thebenedict/tinkerbadge-hardware/docs/design/history/2026-11-10-before-optical-reposition/review/rear-with-battery.png

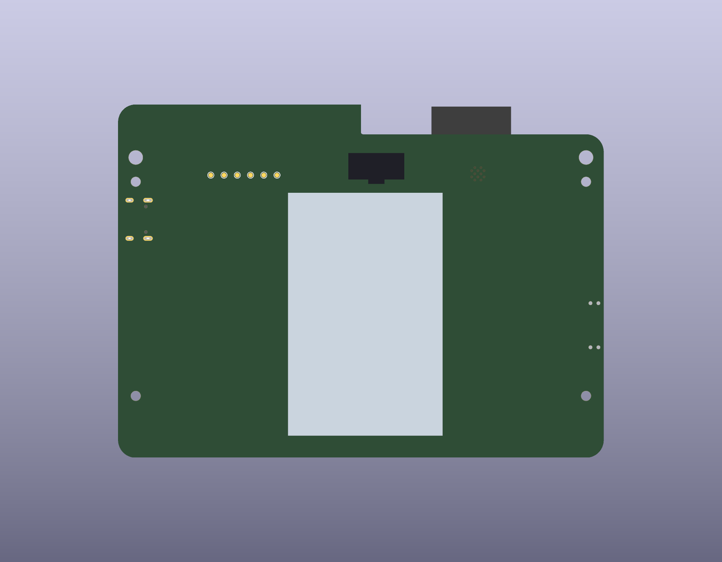
docs/design/history/2026-11-10-before-optical-reposition/review/rear-with-battery.png
