thebenedict/tinkerbadge-hardware/docs/design/history/2026-11-10-before-optical-reposition/README.md

# Before optical relocation

Complete native project/source-library/model checkpoint before the requested IR and ambient-light relocation. Board SHA256 08b5de1ac1b194544ebf15598fd0b40e66a4e0c05123c6da75603a769d91554e. This 110 × 80 mm placement is historical and unrouted. Review outputs and the source placement plan are preserved.
