thebenedict/tinkerbadge-hardware/docs/design/display_pinout.md

# Display project pinout

Generated by `tools/write_display_pinout.py` from [display_contract.json](display_contract.json). Manufacturer facts remain in docs/components. J301 rows are panel flex positions; the FH34SRJ footprint numbers its pads in the same panel order.

| Ref | Physical pin | Function | Project net | Treatment |
|---|---|---|---|---|
| J301 | 1 | NC | — | no_connect |
| J301 | 2 | GDR | EPD_GDR | connected |
| J301 | 3 | RESE | EPD_RESE | connected |
| J301 | 4 | NC | — | no_connect |
| J301 | 5 | VSH2 | EPD_VSH2 | connected |
| J301 | 6 | TSCL | — | no_connect |
| J301 | 7 | TSDA | — | no_connect |
| J301 | 8 | BS1 | GND | connected |
| J301 | 9 | BUSY | EPD_BUSY | connected |
| J301 | 10 | RES# | EPD_RST_N | connected |
| J301 | 11 | D/C# | EPD_DC | connected |
| J301 | 12 | CS# | EPD_CS_N | connected |
| J301 | 13 | SCL | EPD_SCK | connected |
| J301 | 14 | SDA | EPD_MOSI | connected |
| J301 | 15 | VDDIO | +3V3_EPD | connected |
| J301 | 16 | VCI | +3V3_EPD | connected |
| J301 | 17 | VSS | GND | connected |
| J301 | 18 | VDD | EPD_VDD_1V8 | connected |
| J301 | 19 | VPP | EPD_VPP | connected |
| J301 | 20 | VSH1 | EPD_VSH1 | connected |
| J301 | 21 | VGH | EPD_VGH | connected |
| J301 | 22 | VSL | EPD_VSL | connected |
| J301 | 23 | VGL | EPD_VGL | connected |
| J301 | 24 | VCOM | EPD_VCOM | connected |
| Q301 | 1 | G | EPD_GDR | connected |
| Q301 | 2 | S | EPD_RESE | connected |
| Q301 | 3 | D | EPD_SW | connected |
| D301 | 1 | K | GND | connected |
| D301 | 2 | A | EPD_PUMP | connected |
| D302 | 1 | K | EPD_PUMP | connected |
| D302 | 2 | A | EPD_VGL | connected |
| D303 | 1 | K | EPD_VGH | connected |
| D303 | 2 | A | EPD_SW | connected |
| L301 | 1 | 1 | +3V3_EPD | connected |
| L301 | 2 | 2 | EPD_SW | connected |
| R301 | 1 | 1 | EPD_RESE | connected |
| R301 | 2 | 2 | GND | connected |
| R302 | 1 | 1 | EPD_GDR | connected |
| R302 | 2 | 2 | GND | connected |
| C301 | 1 | 1 | +3V3_EPD | connected |
| C301 | 2 | 2 | GND | connected |
| C302 | 1 | 1 | EPD_SW | connected |
| C302 | 2 | 2 | EPD_PUMP | connected |
| C303 | 1 | 1 | +3V3_EPD | connected |
| C303 | 2 | 2 | GND | connected |
| C304 | 1 | 1 | EPD_VDD_1V8 | connected |
| C304 | 2 | 2 | GND | connected |
| C305 | 1 | 1 | EPD_VPP | connected |
| C305 | 2 | 2 | GND | connected |
| C306 | 1 | 1 | EPD_VSH1 | connected |
| C306 | 2 | 2 | GND | connected |
| C307 | 1 | 1 | EPD_VGH | connected |
| C307 | 2 | 2 | GND | connected |
| C308 | 1 | 1 | EPD_VSL | connected |
| C308 | 2 | 2 | GND | connected |
| C309 | 1 | 1 | EPD_VGL | connected |
| C309 | 2 | 2 | GND | connected |
| C310 | 1 | 1 | EPD_VCOM | connected |
| C310 | 2 | 2 | GND | connected |
| C311 | 1 | 1 | EPD_VSH2 | connected |
| C311 | 2 | 2 | GND | connected |
| R308 | 1 | 1 | EPD_BUSY | connected |
| R308 | 2 | 2 | GND | connected |
| TP301 | 1 | pad | +3V3_EPD | connected |
