thebenedict/tinkerbadge-hardware/docs/design/power_capture_review.md

# Independent power capture review

9 November 2026. **PASS: native single nominal 3.3 V prototype capture.** This replaces the historical 3.95 V / LDO capture review, which remains preserved under `history/power_3v95_before_single_3v3`.

A new netlist was independently exported from the actual `power.kicad_sch` through Konnect. It matches the reviewed contract: **60 components, 195 physical endpoints, 14 intentional NCs, zero issues**. The exact non-power-symbol component set also matches, so removed U106, C110 and C111 have not survived outside the contract. No old VLED_3V9 net remains. Four independent native validators report zero floating wires, unconnected pins, shorted nets and orphan items.

Separately compared all 60 Contract fields, all 60 blank footprint fields, 12 exact MPNs and their visible values, 45 support Specifications and visible values, plus J104's DNP property. All agree. Blank footprints are deliberate release gates, not accepted physical mappings. J104's DNP is carried by its explicit value/property; the native DNP attribute remains unavailable in the current tool and the BOM process must honor this flag.

Inspected the final full-page image. The shared-rail group is readable, the 56.0 kΩ divider is shown, both 22 µF output capacitors remain, and the removed LDO group and old headline are absent. Rail labels terminate on clear branch stubs. The charging-disabled and first-prototype LED-exception notes remain prominent. No new ambiguity or visible correction was found.

Current native SHA-256: `377d3afaa8323e6f61d6cef0f8e670254b959091fdc766e32c5c063dad6d121f`.
Final reviewed PNG SHA-256: `5bca714550c126438e0f0ab12fda2b1071d87f0450cd5ac655035bd5c81601b2`.
Independent export SHA-256: `e516bbae113c89aea26574083f35281a8f212997e392044e743a3b23d77adbda`.

This acceptance is for a development schematic, not guaranteed LED operation or manufacturing release. Full-root ERC, physical component/footprint qualification, the unselected pack/connector and shared-rail bench tests remain separate. R120 continues to disable charging. Full results, source contract hash and field-level evidence are in `power_capture_review.json`.
