thebenedict/tinkerbadge-hardware/docs/design/property_checker_review.md

# Independent property-checker review

9 November 2026. **PASS for its stated explicit-property scope.** Independently ran seven fixture tests: five negative cases, one baseline and one unit-equivalence case. All pass, with fixture hashes checked. Current power export also passes.

Declared MPN, support value/rating, displayed voltage rating, explicit library/footprint and DNP comparisons are consistent with the current contracts. The checker is separate from endpoint checking and does not claim physical footprint or electrical-performance acceptance.

Scope limits: Contract trace fields, power Specification metadata and visible IC values are not automatically compared unless represented by the implemented contract fields. Unspecified footprints are reported rather than approved. I separately audited all of these for the current power capture. Nominal values are compared as scaled numbers without dimensions, allowing display-style values such as 100n; this is not a unit-validity proof.

Future fail-closed improvements: reject duplicate component/property records instead of dictionary overwrite, report missing values cleanly, and add negative DNP/library tests. These are not observed defects in the current KiCad exports. No native correction is required. File hashes and exact observations are in `property_checker_review.json`.
