thebenedict/tinkerbadge-hardware/docs/design/history/2026-11-10-before-lower-ir/spec.md

# AI Tinkerers Badge Project Specification

Version 0.6 · 9 November 2026 · Working draft for humans and implementation agents

## Purpose and scope

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

## Current schematic snapshot

The KiCad development schematic now implements the reviewed [project pinouts](pinouts.md). [Schematic implementation](design/implementation_status.md) records the current electrical choices and supersedes conflicting candidate details below, including the two-wire battery interface, initially unpopulated thermistor and hardware-disabled charging. Prototype and physical acceptance gates remain open.

### Approved first-prototype LED supply

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

## Experience and operation

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

## Events and interactions

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

### Arrival: email link, scan, and badge assignment

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

### Further journeys to define

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

## Hardware blocks

### Display and processor

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

### V1 sensors and peripherals

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

- **Two physical buttons are required.** Use at least one existing button for wake from storage deep sleep; its GPIO and circuit must support the selected sleep mode. Placement, labels, other short/long-press behavior, and functions remain TBD. Candidate uses include display navigation and explicit contact exchange; retain independent hardware recovery access.
- **Ambient light sensor:** Include a low-power digital sensor, preferably on I2C, to adapt LED brightness to the room. Allow manual brightness override. Position its optical opening away from the badge's own LEDs and test with the final enclosure and diffuser.
- **Accelerometer and orientation:** Include a low-power three-axis accelerometer with motion/wake interrupt support for tilt, shake, and badge-bump experiments. Gravity provides tilt when the badge is relatively still; an accelerometer alone does not provide compass heading or reliable orientation during arbitrary movement. Prefer this simpler baseline. A six-axis accelerometer/gyroscope is an option if prototypes need richer gestures or smoother motion tracking; it still does not provide drift-free absolute heading.
- **Infrared, proposed transmit and receive:** Recommend both an IR LED with a suitable current driver and a carrier-demodulating IR receiver, rather than transmit-only hardware. This allows directional badge-to-badge messages and facing-cue experiments. Start by evaluating a common 38 kHz carrier and a short, collision-aware packet protocol. A demodulating remote-control receiver is not a general raw IR sensor: validate its burst timing and filtering against the selected protocol. Check sunlight and lighting interference, viewing angle, range, multiple badges, and transmitter peak current. IR sensing is not proof of a conversation. Final inclusion and optical placement remain a v1 decision.
- **MCU-programmable NFC tag:** Include a dynamic NFC tag with an MCU interface, preferably I2C, and a tuned antenna. Firmware should be able to update an NDEF record, such as a profile or contact-exchange URL, so a compatible phone can tap the badge. Select field-detect/interrupt capability if useful for wake or UI feedback, and test the target phones and enclosure. Passive RF operation can allow reading the last stored record without badge power, subject to the selected part. Default to a public or limited-purpose link, with controlled write access; do not expose private attendee data or credentials in the tag. A tap does not itself authorize contact sharing.
- **NFC reader, optional pending use case:** A dynamic tag does not make the badge a reader. Two passive tags cannot initiate an exchange with one another. If badges must read external tags or initiate badge-to-badge NFC, add a reader/controller capable of generating the RF field, and validate the reader/tag modes and arbitration. This adds cost, power, antenna/layout work, and firmware. Recommendation: use the dynamic tag for v1 phone taps and defer an onboard reader unless one of those use cases is essential; BLE with button confirmation or IR can support badge-to-badge experiments. The proposed ESP32-S3 needs external NFC hardware for either approach.
- **BLE and Wi-Fi:** Retain the processor's radios for discovery/proximity experiments, provisioning, updates, and event connectivity. Evaluate scanning, advertising, power, and coexistence under event conditions. BLE signal strength is only an approximate proximity cue.
- **Display and lighting:** Retain the e-paper display, top role bar, and independently controlled affinity indicators described below. Budget LED drivers/channels, dimming, and power explicitly; the exact indicator count remains open.
- **Battery and power sensing:** Retain battery-voltage monitoring, charger status, separate USB and dock presence sensing, low-battery behavior, and battery-temperature protection appropriate to the chosen cell and charger. Prefer an inexpensive voltage/status baseline; a fuel-gauge IC is a suggested upgrade if usable state-of-charge estimates or fleet charging diagnostics justify it. Voltage alone is not an accurate remaining-runtime measurement.

### Supporting interfaces and optional additions

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

Other suggestions, not additional v1 requirements:

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

### Lights and optics

- **Power status:** Include one separate tiny red/green indicator, owned by the power block and distinct from the role/affinity lights. Prefer 0402 or similar; the currently sourced working candidate is a four-pad 0603 part. See the power-status contract below.
- **Top role bar:** A thin, continuous-looking colored light identifies attendee, organizer, speaker, or another event-defined role. Explore a diffused LED strip/light guide; no specific filament or LED construction is selected.
- **Affinity indicators:** Approximately three to five separately controlled color indicators, likely near the bottom. Five is a prototype suggestion, not a final count. Begin with simple, distinguishable colors rather than combinations or subtle blinking codes.
- **Affinity assignment:** Support attendee-selected interests and optional agent-proposed groups based on voluntarily shared interests. Proposed flow: organizer reviews the event’s categories, attendees confirm or edit their assignments, and the website or display explains the colors. More specific introductions and “can help with / looking for” matching are optional extensions.
- **Appearance:** Soft, modest-brightness glows rather than exposed hotspots. Prototype frosted windows or strips, LED-to-diffuser spacing, and internal light barriers. A single diffuser behind separate openings may simplify construction. Preserve a non-color explanation for accessibility.

## Power and docking

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

Working architecture:

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

### Automatic power behavior

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

### Power-status indicator

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

Reuse battery-voltage sensing and charger status. Measure protected BAT through a calibrated, filtered, safely scaled ADC1 path with verified powered-off isolation, never raw battery directly into a GPIO. Provisional battery-mode thresholds are **below 3.50 V for 10 seconds**, clearing **above 3.65 V for 30 seconds**; validate these with the selected pack and realistic load/temperature, suppress transient flicker, and re-evaluate after external power removal. Invalid readings must not imply a healthy battery. The warning is separate from controlled low-voltage shutdown and the pack's protection cutoff. `CHG` indicates charging, not low battery.

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

## PCB and enclosure

### PCB

**Current placement trial (9 November 2026):** The requested compact candidate is 110 × 80 mm, with front-side SMT, a proposed 4.5 mm raised display, right-edge USB, full-width affinity LEDs, organized circuit groups, an evenly spaced role-LED row on the remaining top edge and a radio-antenna opening extended to the left edge. It is experimental, not RF/manufacturing approved. The glass is closer to the antenna than the recommended surrounding clearance; the NFC coil, flex and exact part heights remain unresolved. The user selected a rear-copper NFC PCB coil with the front and inner layers kept clear; coil geometry and tuning are not yet implemented. IR/ambient optical faces now use the exposed area right of the MCU and below the role row, while low-profile support sits under the raised display. The prior 110 × 100 mm placement is preserved as a fallback. See [current placement review](design/pcb_placement_review.md) and obtain human approval before detailed routing.

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

#### PCB layout and routing guidance

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

**Placement, composition, and routing goals:**

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

**Placement approval and visual feedback loop:**

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

**Useful prior art and its limits** (reviewed 9 November 2026):

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

### Enclosure

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

- Explore two or three shapes around the same functional envelope. A clear front/back with a printed frame, screws/standoffs, and diffuser inserts is a practical candidate. A simple protective front cover is an earlier prototype step; higher-quality printing, machining, or molding may follow.
- Attach the lanyard to the structure or PCB, not assumed holes in the display. Confirm the exact panel’s permitted support and adhesive regions. Compliant support is a candidate, not permission to clamp arbitrary glass edges or compress the panel.
- **CAD working choice:** Parametric build123d; CadQuery is a close alternative, with FreeCAD or Onshape available for visual design/review. Keep fit dimensions separate from styling and use KiCad’s PCB/component STEP assembly as a reference.
- Export STEP for mechanical handoff and 3MF or STL for printed prototypes. Check fits, clearances, wall thickness, fasteners, assembly sequence, and process-specific rules such as draft before calling a design production-ready.

## Firmware, networking, and privacy

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

## Design, publishing, and production pipeline

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

## Next decisions and references

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
