thebenedict/tinkerbadge-hardware/docs/design/history/2026-11-10-before-shared-optics/CHECKPOINT.md

# Before shared passive optical window placement

Complete a7ac lower-IR native project, libraries/models and reviews before the four-part ALS/support revision. Board SHA256 a7ac2778f423c3847b9a3a6200f00446d6a960bbee242b6ef8da7aff5ed24b84. The saved prior-bookkeeping manifest predates a7ac and is retained as history, not as this checkpoint verification. The source board and review files identify the a7ac revision.
