thebenedict/tinkerbadge-hardware/docs/design/history/power_3v95_before_single_3v3/docs/design/power_capture_review.md

# Independent power capture review

Temporary review artifacts below are identified by filename only; these intermediate files are not distributed. Published source outputs and repeatable checks are linked from the [current verification record](../../../../verification.md).

2026-11-09. Reviewer: display/MCU circuit reviewer, independent of power CAD author. **PASS electrical capture for reviewed contract e6117b29…bccb; visual corrections requested before final visual acceptance.** No native CAD edits made by this reviewer.

Freshly exported `power-independent.net` through Konnect and checked it against `power_contract.json`: **63 parts, 206 physical endpoints, 16 intentional NC, no mismatch**. Independently ran all four local validators: **0 floating wires, 0 unconnected pins, 0 named-net shorts and 0 orphans**. Every specified MPN/value matches the export. All power footprint fields are blank, preserving the physical-release gate.

Reviewed the actual `power_final.png` against the original-source decisions in `review_power.md`. Actual endpoint sets preserve USB/dock input and TVS polarity, mux OUT1/8 and charger BAT2/3/OUT10/11 duplicates, all exposed grounds, Q103 source-mode inversion, the fitted R1200-ohm VSYS→CE hard charge-disable, and separate logical two-wire battery/optional thermistor interfaces. The 69k/10k feedback, 0.47uH between L1/L2, both 22uF primary output caps, 3.3V LDO and bypasses match the reviewed 3.95V/3.3V architecture. This is not independent approval of a later rail-architecture change.

ADC capture places C116 upstream of the powered-off-protected TMUX, R13010k after it, and R129100k from BAT_ADC to ground; the reviewed VBAT/3.2 ratio and off-state leakage reasoning therefore apply. U104 has correct ON/CT/QOD assignments and its QOD resistor returns to +3V3_EPD, not ground. All source-sense GPIO outputs use ground-referenced MOSFETs and 3.3V pull-ups. The complete-root display/MCU review separately verifies U104's switched output and EPD_EN integration.

J104's exported value is `NTC (DNP)` with `Populate=DNP` and an explicit charging-stays-disabled Safety field. A native KiCad DNP attribute was not available through the current tool; the source contract, value and custom field retain the intent. Manufacturing/BOM automation must explicitly honor that field before any release. No battery mating polarity or charge enable is authorized by this schematic.

## Requested visual corrections

The electrical content is sound, but the initial final render has avoidable collisions: R120 with the CHARGER_TMR/EN1 text; battery/NTC captions with nearby rail/GND labels; U106 value with +3V3; R121/R124 values across vertical gate wires; and three global rail labels over continuous wires. Specific locations were sent to the author for correction. Await a fresh render before visual signoff. These findings do not alter the electrical contract.

Pinned evidence, actual critical net membership, values and validator results are in `power_capture_review.json`. Complete-root ERC, human visual approval, exact footprints/MPNs/pack polarity, temperature sensing and disabled charging, source/current-mode tests, thermal/peak-load limits, USB compliance and prototype validation remain open release gates. This review neither routes a PCB nor approves manufacturing.

## Corrected historical capture accepted

Inspected the final corrected `power_final_reviewed.png`, including the last U103 reference/value move clear of PRIMARY_L2. All reported visual overlaps are resolved; no new issue observed. Rechecked exported endpoints:63/206/16NC PASS, and fresh local validators again report zero findings. **Independent electrical and visual capture PASS for this 3.95V-plus-LDO snapshot.**

The user has since chosen a single nominal3.3V prototype rail. That upcoming electrical amendment supersedes this architecture and requires a new source/contract review before capture; this historical signoff does not approve it in advance.

Snapshot native SHA-256: `137e7f1daf40aac11d6c4be061468b6c48a9999a3ebdb6682e1a062be78fc4c8`.
Snapshot netlist SHA-256: `f7becfc1633dc1065ae864f44d7bf41c62d5d64395a43ab665b5a6f64cec310b`.
Inspected PNG SHA-256: `7703f9b78a4eafbf3418aee859d446e965a00efd902e23f2b2076d88f7b0f0e0`.
