thebenedict/tinkerbadge-hardware/docs/design/history/2026-11-10-before-shared-optics/review/functional-blocks.png

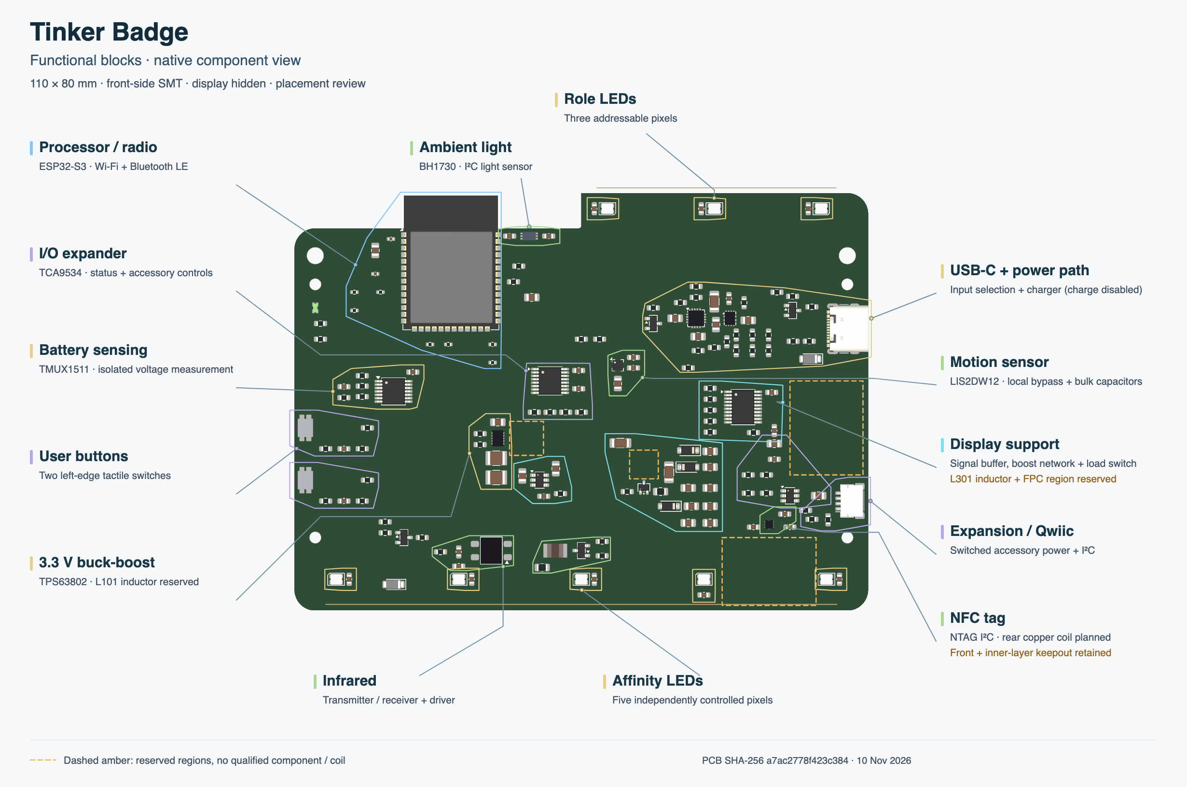
docs/design/history/2026-11-10-before-shared-optics/review/functional-blocks.png
