thebenedict/tinkerbadge-hardware/docs/review/product-review-2026-11-11/pcb-front.png

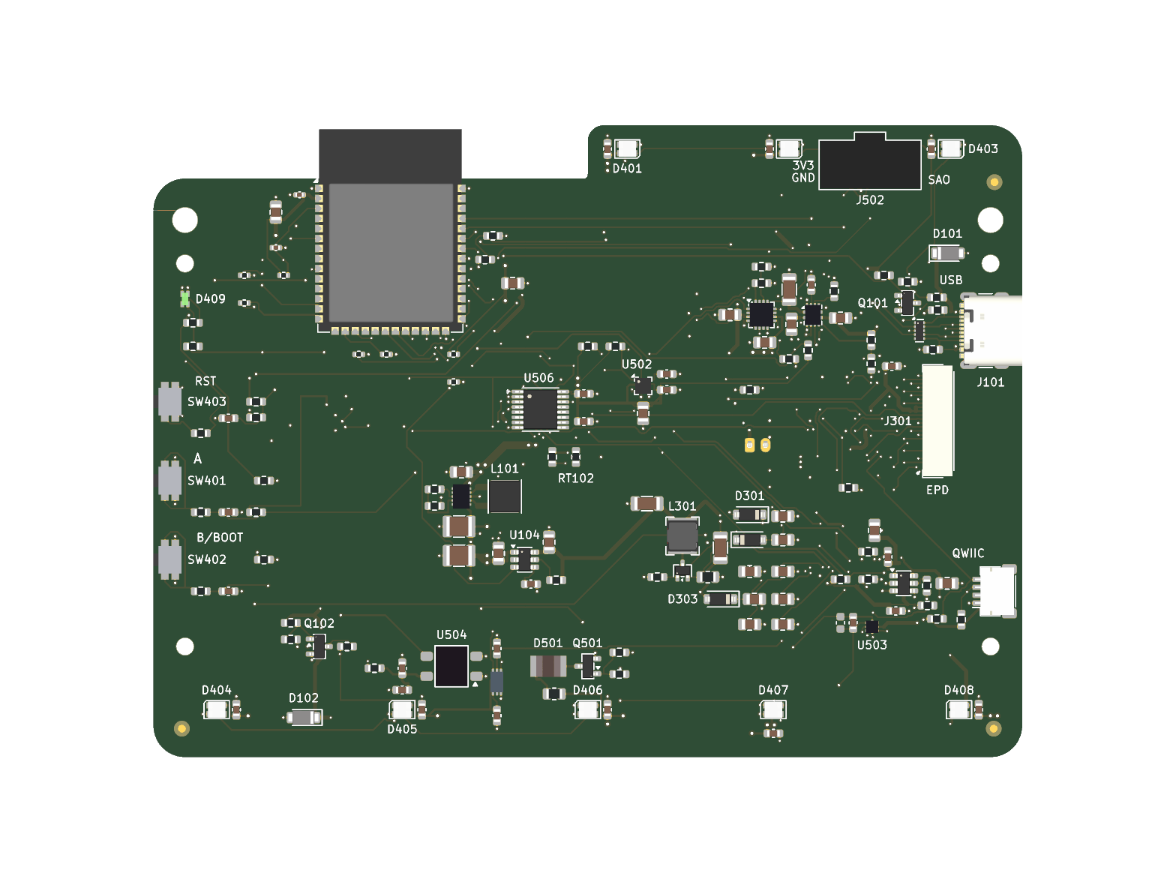
docs/review/product-review-2026-11-11/pcb-front.png
