thebenedict/tinkerbadge-hardware/exports/design-review-2026-11-11/front-3d.png

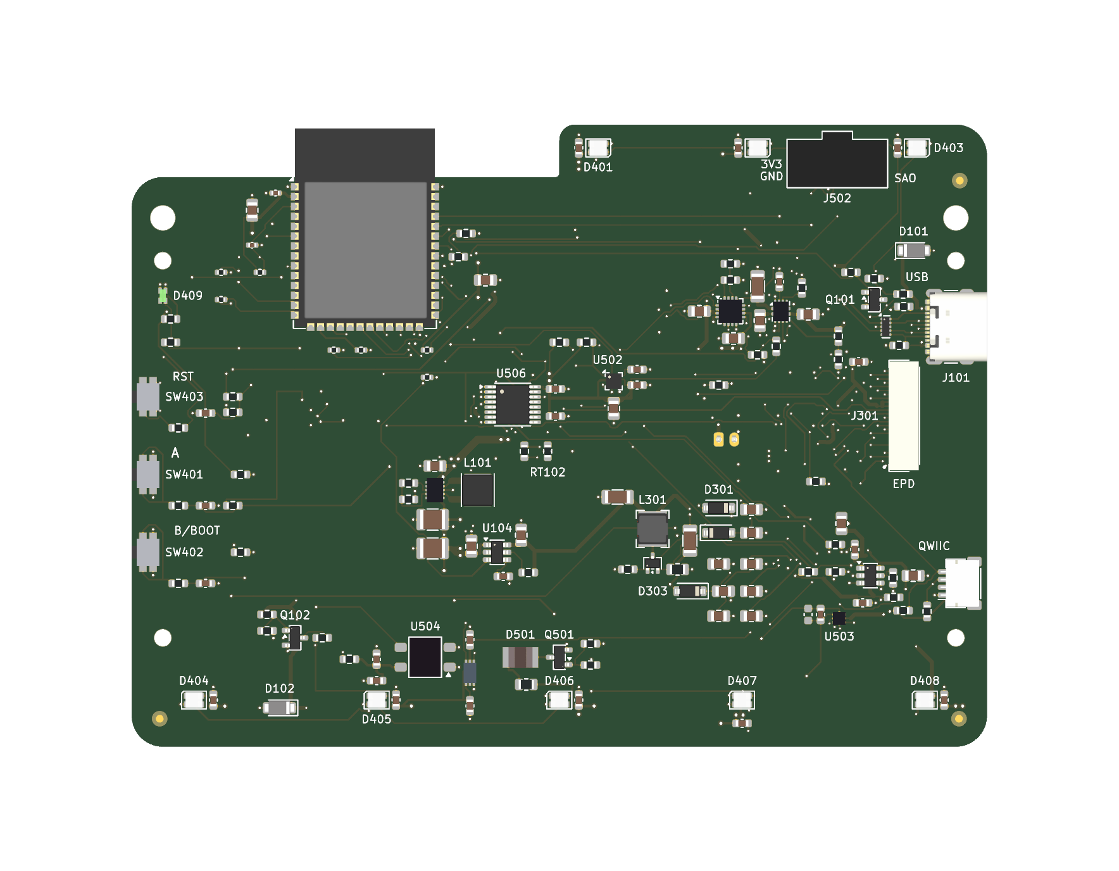
exports/design-review-2026-11-11/front-3d.png
