thebenedict/tinkerbadge-hardware/exports/display.png

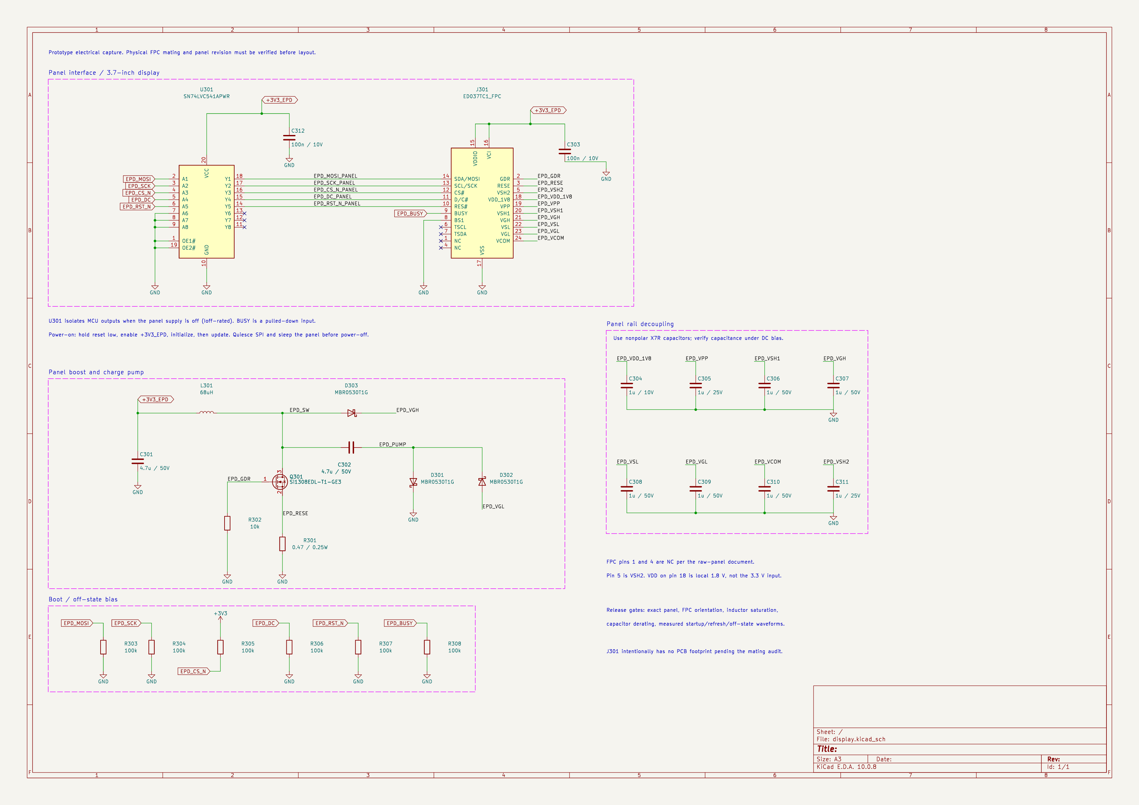
exports/display.png
