thebenedict/tinkerbadge-hardware/exports/lighting.png

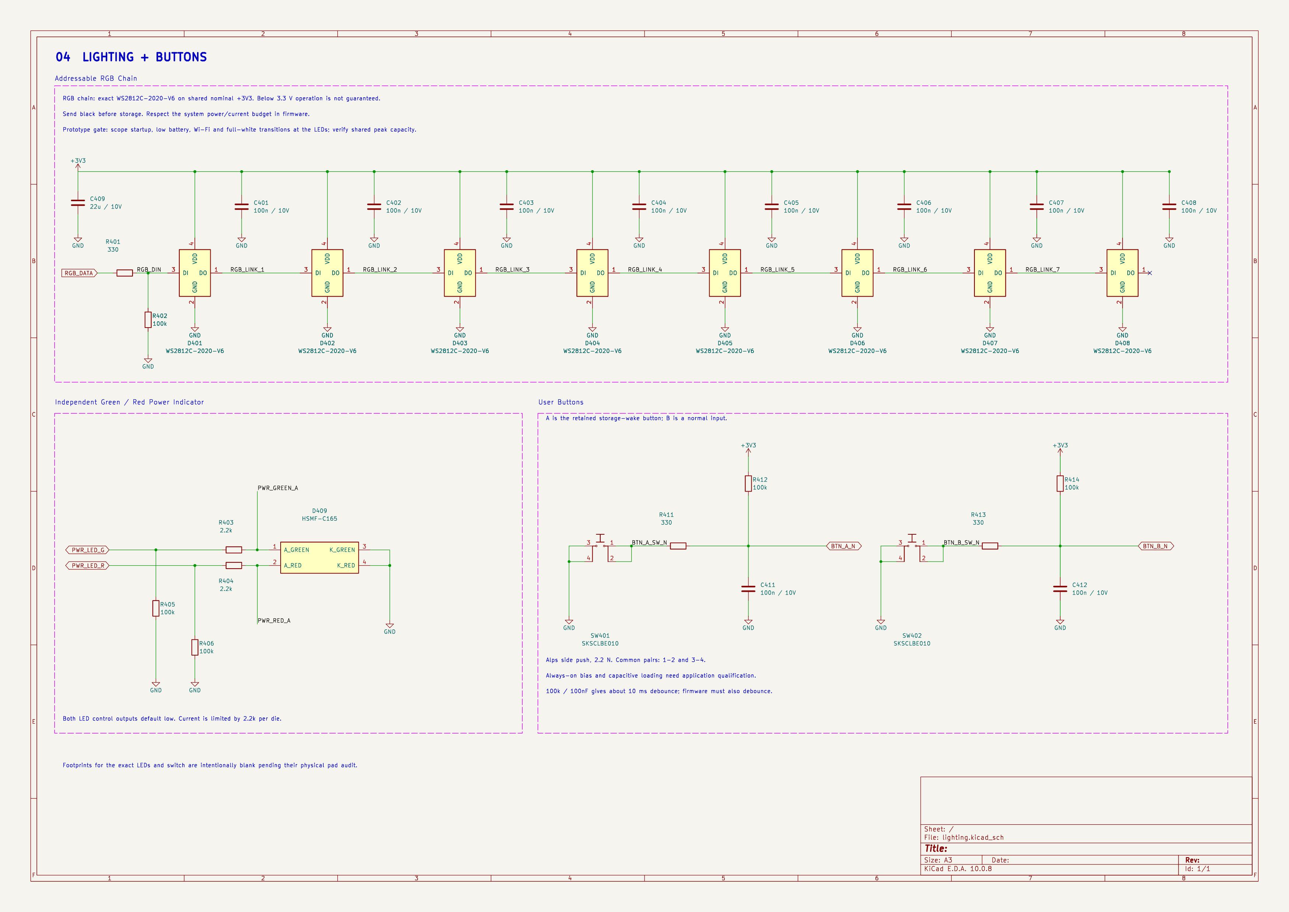
exports/lighting.png
