thebenedict/tinkerbadge-hardware/exports/mcu.png

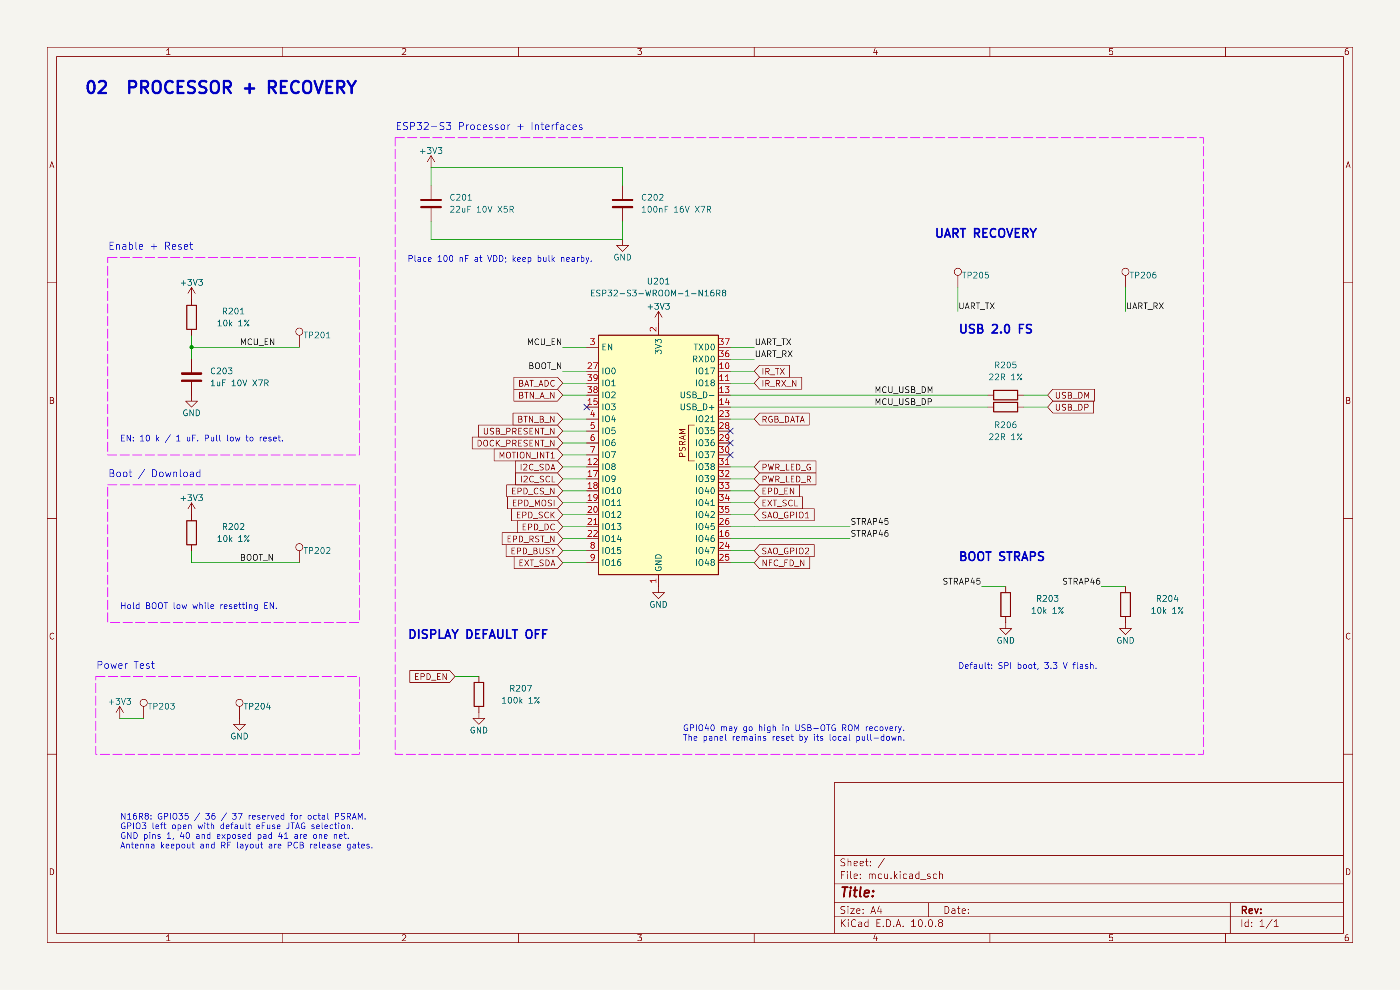
exports/mcu.png
