thebenedict/tinkerbadge-hardware/exports/pcb-review/first-routing/front-with-display.png

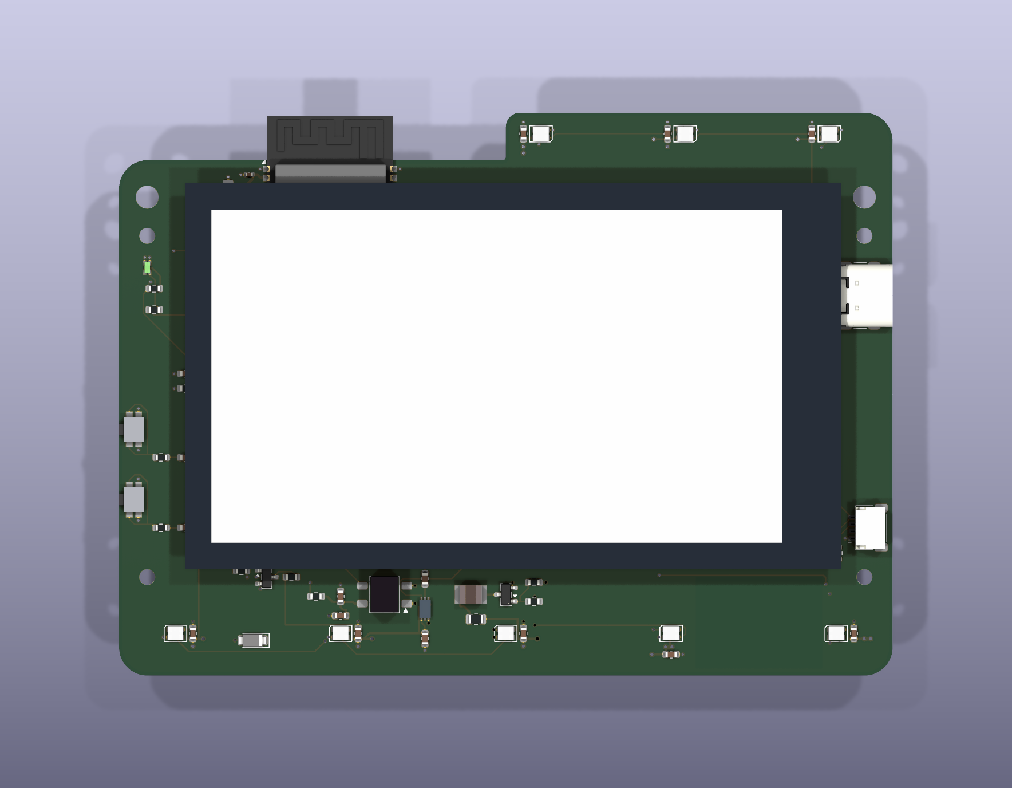
exports/pcb-review/first-routing/front-with-display.png
