thebenedict/tinkerbadge-hardware/exports/pcb-review/first-routing/raised-display-perspective.png

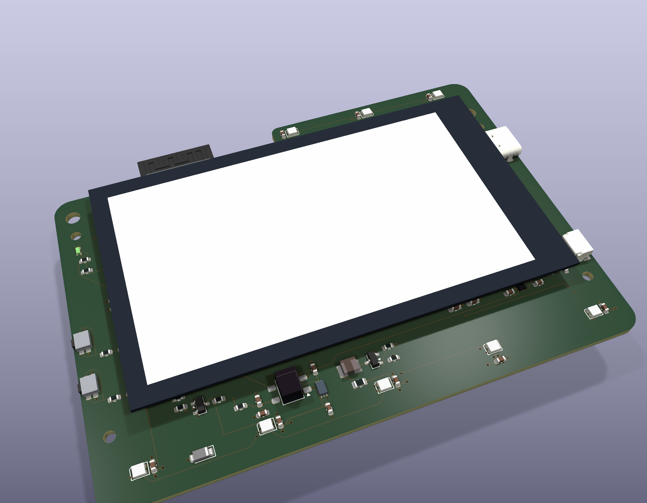
exports/pcb-review/first-routing/raised-display-perspective.png
