thebenedict/tinkerbadge-hardware/exports/pcb-review/first-routing/rear-with-battery.png

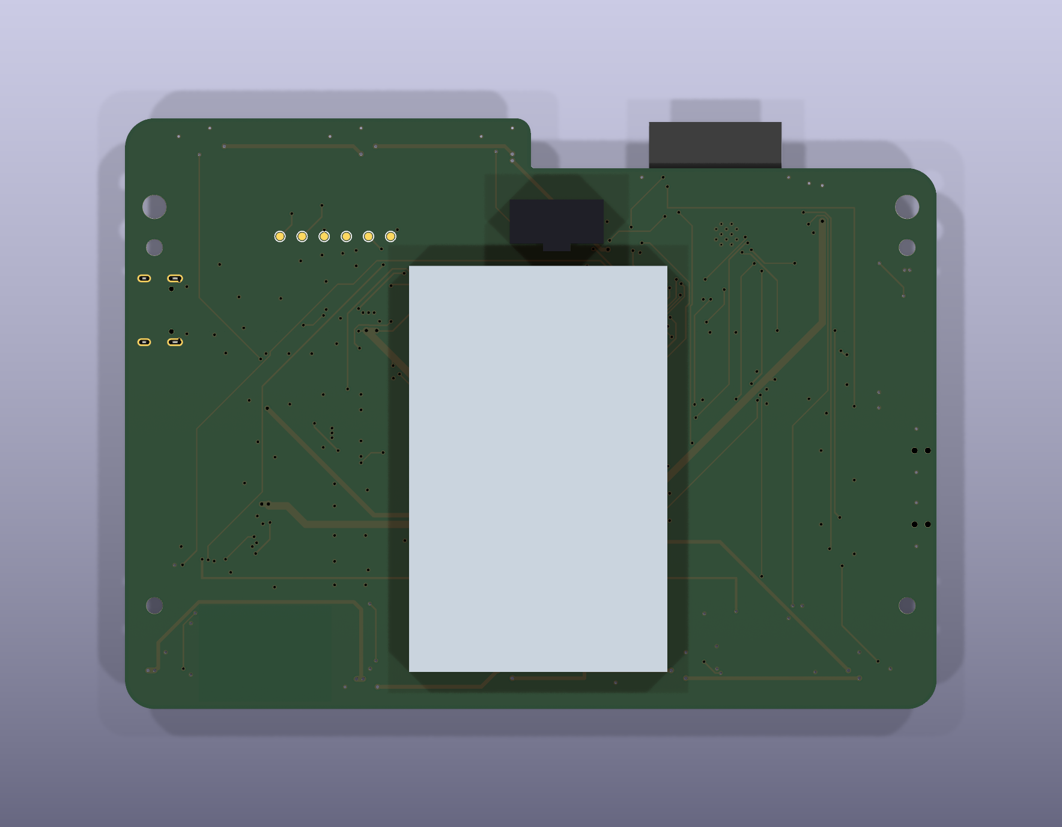
exports/pcb-review/first-routing/rear-with-battery.png
