thebenedict/tinkerbadge-hardware/exports/pcb-review/first-routing/routing-closeups.png

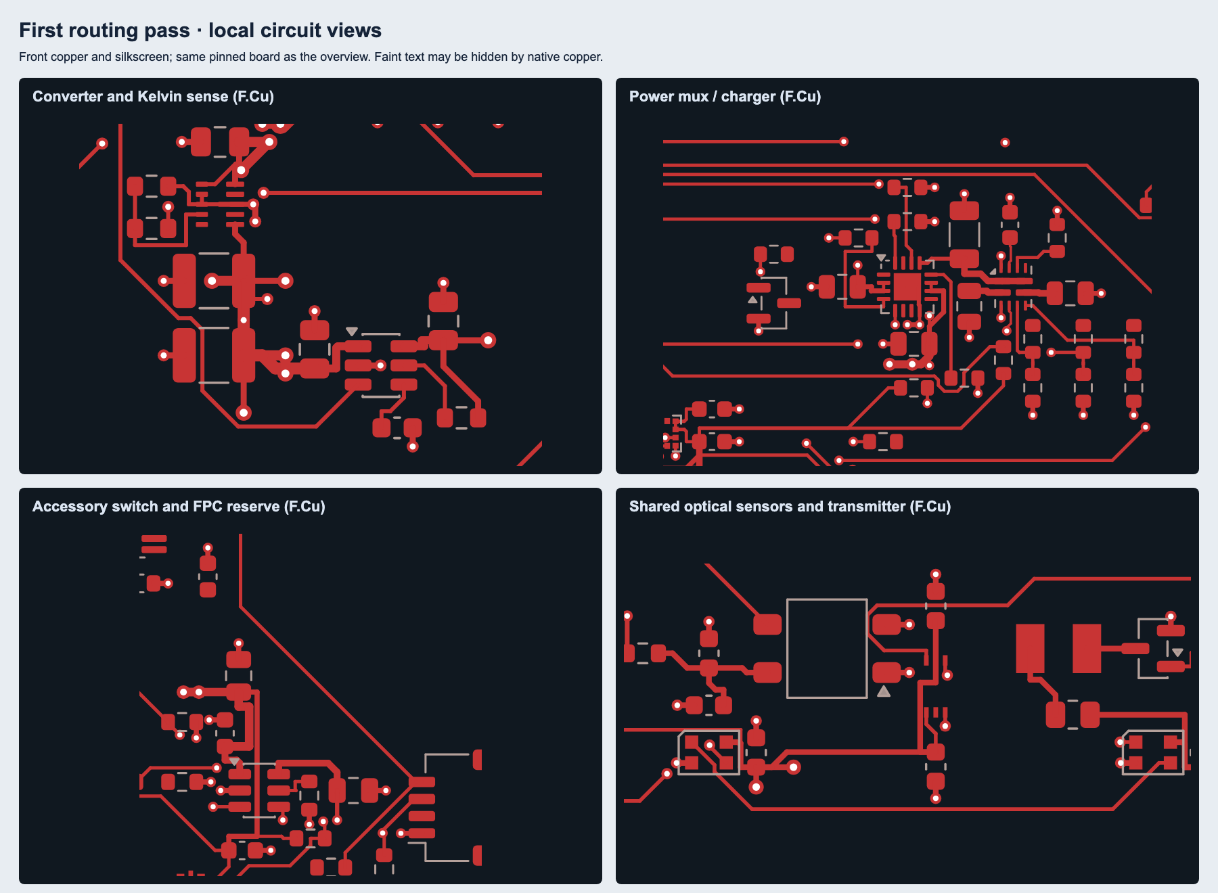
exports/pcb-review/first-routing/routing-closeups.png
