thebenedict/tinkerbadge-hardware/exports/pcb-review/first-routing/routing-overview.png

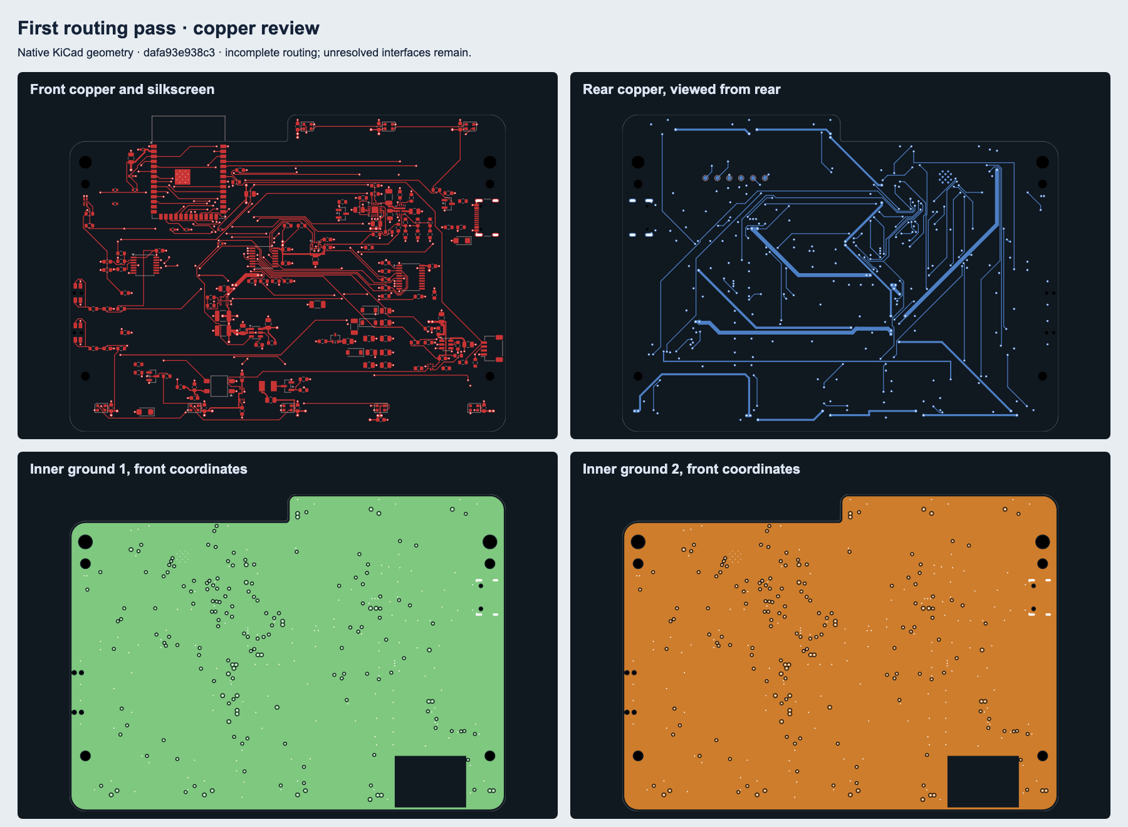
exports/pcb-review/first-routing/routing-overview.png
