thebenedict/tinkerbadge-hardware/exports/pcb-review/led-spacing-front-with-envelopes.png

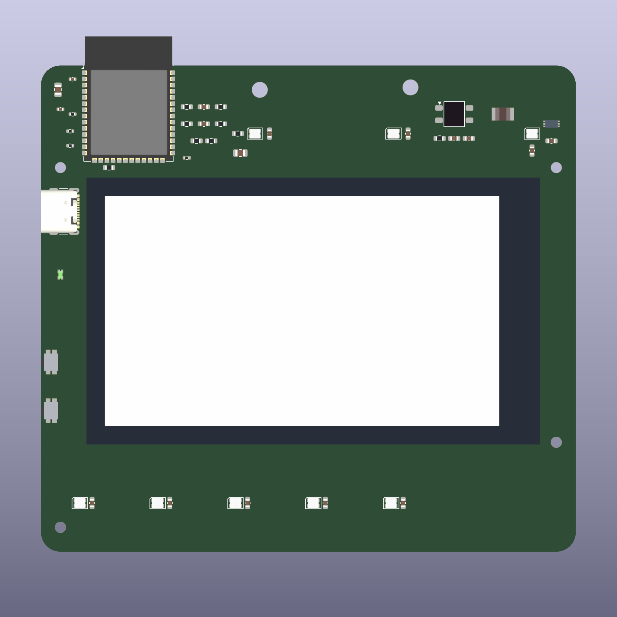
exports/pcb-review/led-spacing-front-with-envelopes.png
