thebenedict/tinkerbadge-hardware/exports/pcb-review/led-spacing-rear-with-envelopes.png

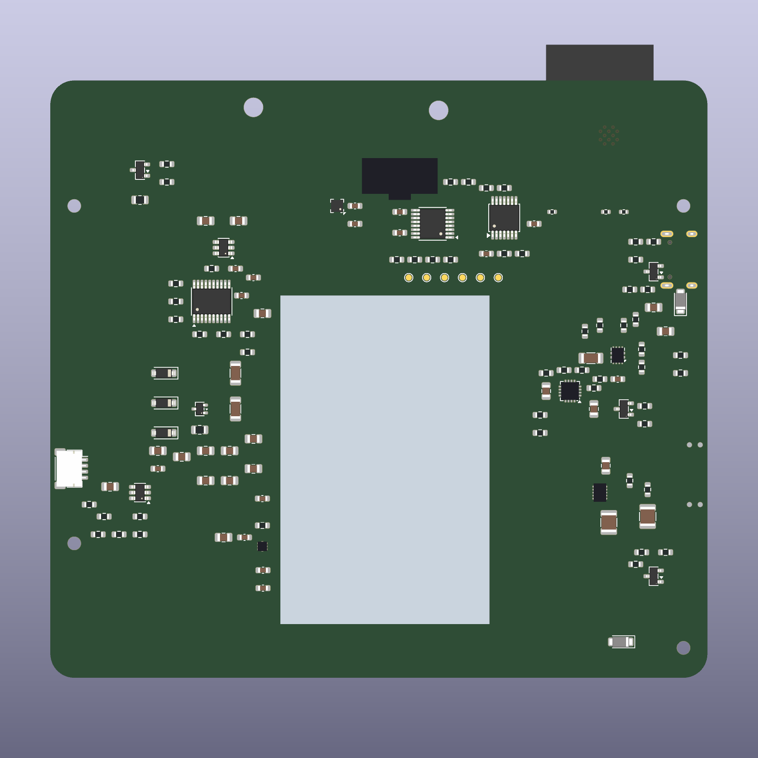
exports/pcb-review/led-spacing-rear-with-envelopes.png
