thebenedict/tinkerbadge-hardware/exports/pcb-review/placement-bottom-3d.png

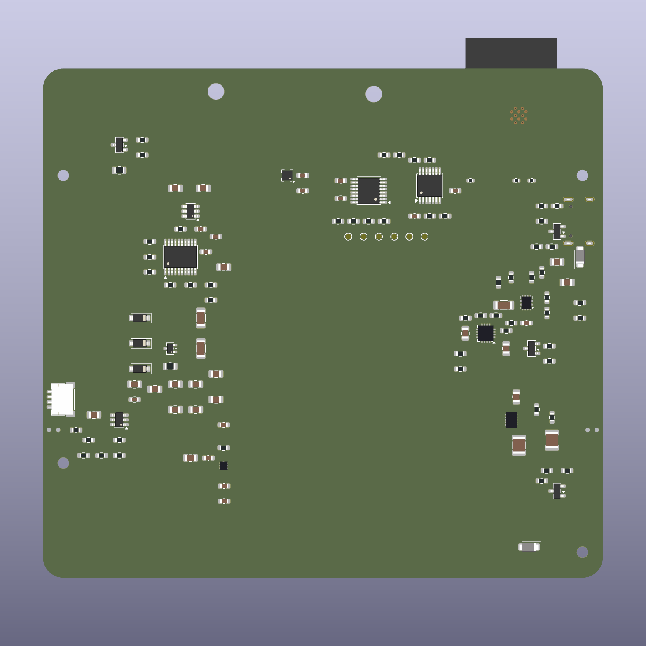
exports/pcb-review/placement-bottom-3d.png
