thebenedict/tinkerbadge-hardware/exports/pcb-review/placement-initial-top.png

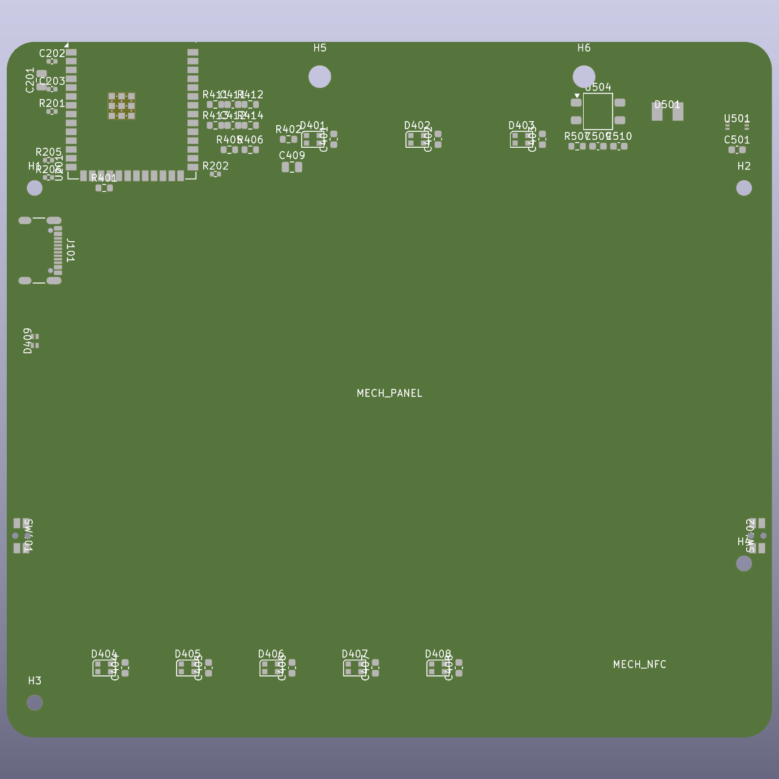
exports/pcb-review/placement-initial-top.png
