thebenedict/tinkerbadge-hardware/exports/pcb-review/placement-top-3d.png

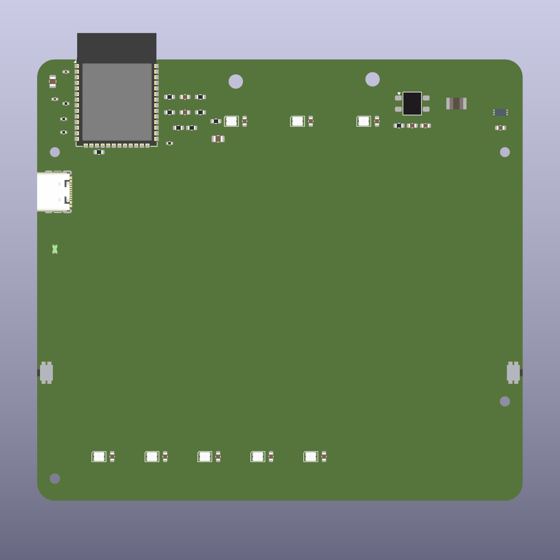
exports/pcb-review/placement-top-3d.png
