thebenedict/tinkerbadge-hardware/exports/pcb-review/shared-optics/front-with-display.png

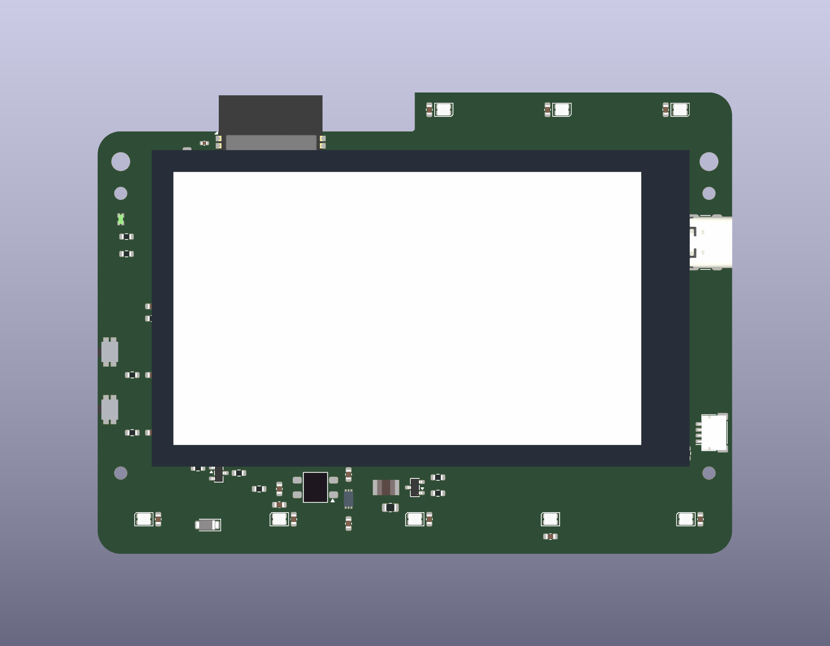
exports/pcb-review/shared-optics/front-with-display.png
