thebenedict/tinkerbadge-hardware/exports/peripherals.png

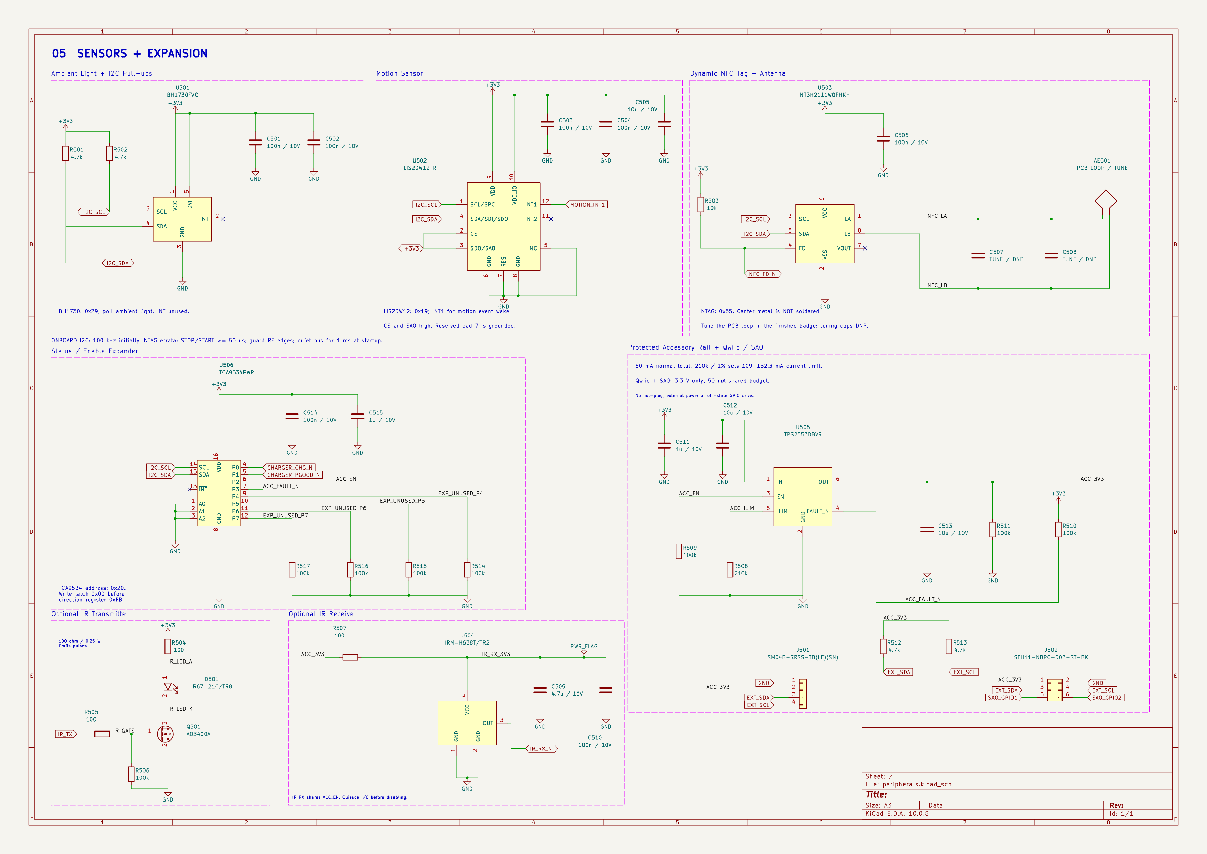
exports/peripherals.png
