thebenedict/tinkerbadge-hardware/exports/power.png

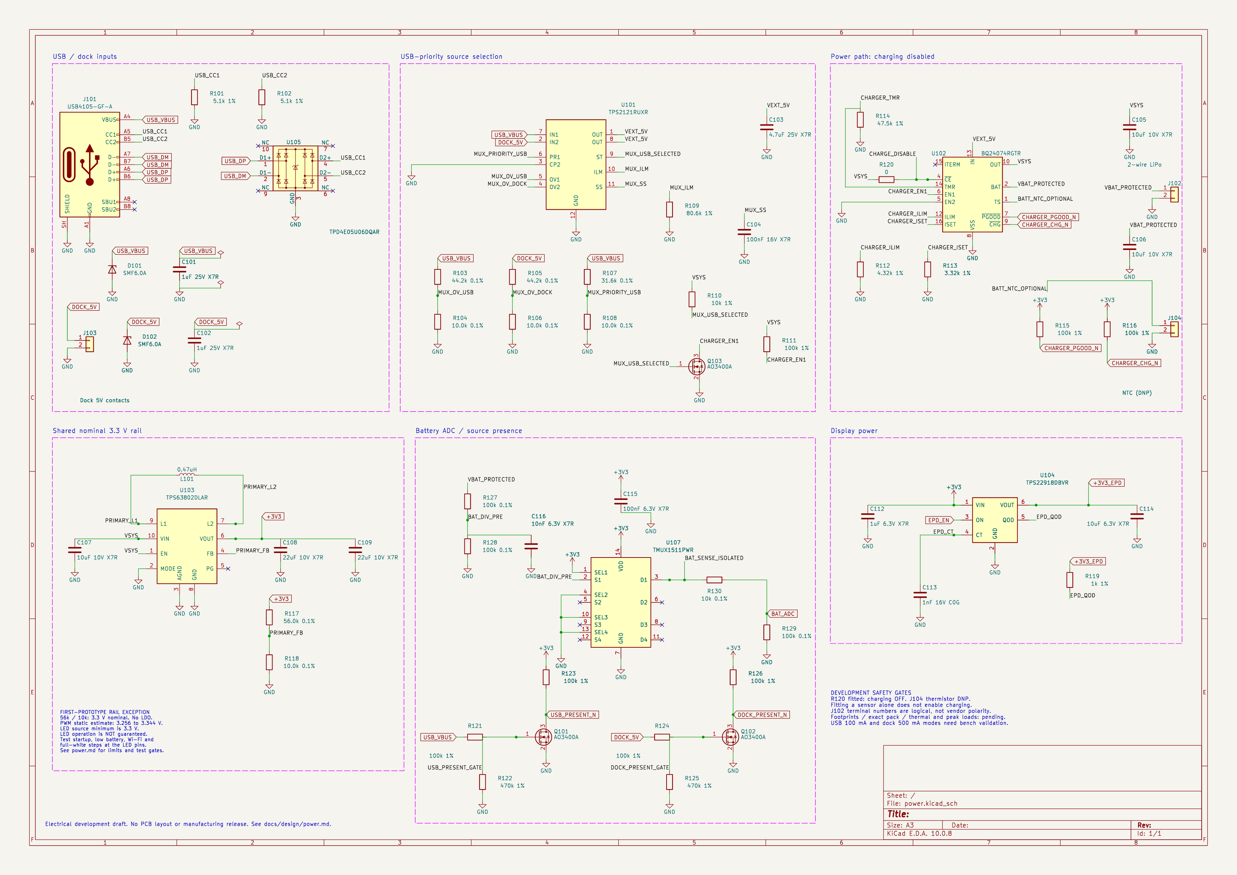
exports/power.png
