thebenedict/tinkerbadge-hardware/docs/components/532610371.md

# 532610371

Status: BLOCKED: manufacturer drawing and actual pack polarity

Package: Molex PicoBlade, 3 contacts, 1.25 mm pitch, right-angle SMT

Source: [532610371-product.pdf](https://www.micros.com.pl/mediaserver/Z_MX-0532610371_MOLEX_0001.pdf). Critical PDF pages: not available.

Pin facts are generated from `power_facts.json`. Project assignments are separate in `../design/power_contract.json`.

| Physical pin/pad | Manufacturer function | Meaning |
|---|---|---|
| 1 | CONTACT1 | Function unknown until actual pack is matched |
| 2 | CONTACT2 | Function unknown until actual pack is matched |
| 3 | CONTACT3 | Function unknown until actual pack is matched |
| MP1 | MOUNT | Provisional mechanical hold-down; geometry unverified |
| MP2 | MOUNT | Provisional mechanical hold-down; geometry unverified |

Selection: Former three-wire candidate retained as source evidence; not selected for the user-approved two-wire build.

## Design-relevant facts

- An exact-part product export is saved as 532610371-product.pdf. The manufacturer mechanical drawing could not be downloaded: official requests timed out and the distributor returned non-PDF content. The footprint is not approved.
- The product record confirms three contacts, 1.25 mm pitch, right-angle SMT, mating family 51021 and 1 A/contact. Do not assign BAT, GND or NTC by convention.
- All electrical assignments remain null. Omit the connector from implemented electrical CAD, or display it explicitly unconnected and blocked. MP1/MP2 are provisional hold-down identifiers whose geometry and count require the missing drawing.

Project circuit and power-state decisions: [power.md](../design/power.md).
