thebenedict/tinkerbadge-hardware/docs/components/AYF532435.md

# AYF532435

Preferred physical connector candidate. Official Y5B drawings establish dual contacts, 0.5 mm pitch, 0.30 ± 0.03 mm FPC thickness, 50 V / 0.5 A ratings, and the dimensional pattern. They do not label numbered terminals. Numbers below are project panel-flex positions. J301 remains an electrical flex model with no approved footprint until the contact face, board view, fold, and pad-1 continuity are checked. The Hirose bottom-contact alternative is not approved.

See [display circuit decisions](../design/display.md) for voltage margins, support values, boot/off-state behavior, and release gates.

## Physical pin facts

Source: [Panasonic_Y5B_Y5BW.pdf](https://api.pim.na.industrial.panasonic.com/file_stream/main/fileversion/277740). ACCTB1E 202309; September 2023; 14 PDF pages. Machine-readable source: [AYF532435.pins.json](AYF532435.pins.json).

| Pin | Manufacturer function | Type | PDF page |
|---|---|---|---|
| 1 | contact: Electrically independent dual-contact FPC position | passive | 5 |
| 2 | contact: Electrically independent dual-contact FPC position | passive | 5 |
| 3 | contact: Electrically independent dual-contact FPC position | passive | 5 |
| 4 | contact: Electrically independent dual-contact FPC position | passive | 5 |
| 5 | contact: Electrically independent dual-contact FPC position | passive | 5 |
| 6 | contact: Electrically independent dual-contact FPC position | passive | 5 |
| 7 | contact: Electrically independent dual-contact FPC position | passive | 5 |
| 8 | contact: Electrically independent dual-contact FPC position | passive | 5 |
| 9 | contact: Electrically independent dual-contact FPC position | passive | 5 |
| 10 | contact: Electrically independent dual-contact FPC position | passive | 5 |
| 11 | contact: Electrically independent dual-contact FPC position | passive | 5 |
| 12 | contact: Electrically independent dual-contact FPC position | passive | 5 |
| 13 | contact: Electrically independent dual-contact FPC position | passive | 5 |
| 14 | contact: Electrically independent dual-contact FPC position | passive | 5 |
| 15 | contact: Electrically independent dual-contact FPC position | passive | 5 |
| 16 | contact: Electrically independent dual-contact FPC position | passive | 5 |
| 17 | contact: Electrically independent dual-contact FPC position | passive | 5 |
| 18 | contact: Electrically independent dual-contact FPC position | passive | 5 |
| 19 | contact: Electrically independent dual-contact FPC position | passive | 5 |
| 20 | contact: Electrically independent dual-contact FPC position | passive | 5 |
| 21 | contact: Electrically independent dual-contact FPC position | passive | 5 |
| 22 | contact: Electrically independent dual-contact FPC position | passive | 5 |
| 23 | contact: Electrically independent dual-contact FPC position | passive | 5 |
| 24 | contact: Electrically independent dual-contact FPC position | passive | 5 |

Status: source extraction complete; independent review of assignments is pending.
