thebenedict/tinkerbadge-hardware/docs/components/ED037TC1.md

# ED037TC1

Electrical candidate defined by the exact 19-page Waveshare 3.7-inch Rev 1.0 specification. The ED037TC1 / SSD1677 association does not establish the next shipped panel revision. The panel includes its controller. Use switched 3.3 V on pins 15/16; pin 18 is a separate 1.8 V regulator node. Pins 1/4 remain NC, and pin 5 is bypassed VSH2 rather than the generic HAT VGH label. RESE and SCL are inputs despite errors in the panel table’s I/O column. Pixel review covered the actual flex diagram, pin table, HAT circuit, and controller circuit.

See [display circuit decisions](../design/display.md) for voltage margins, support values, boot/off-state behavior, and release gates.

## Physical pin facts

Source: [ED037TC1_Waveshare_rev1_2020-05-29.pdf](https://files.waveshare.com/upload/7/71/3.7inch_e-Paper_Specification.pdf). Rev 1.0; 2020-05-29; 19 PDF pages. Machine-readable source: [ED037TC1.pins.json](ED037TC1.pins.json).

| Pin | Manufacturer function | Type | PDF page |
|---|---|---|---|
| 1 | NC: No connection | no_connect | 6 |
| 2 | GDR: External N-MOSFET gate drive | output | 6 |
| 3 | RESE: Current-sense input | input | 6 |
| 4 | NC: No connection | no_connect | 6 |
| 5 | VSH2: Reserved positive source rail, nominal 5 V | power | 6 |
| 6 | TSCL: External temperature sensor I2C clock | output | 6 |
| 7 | TSDA: External temperature sensor I2C data | bidirectional | 6 |
| 8 | BS1: Interface selection: low for 4-wire SPI | input | 6 |
| 9 | BUSY: Controller busy status, active high | output | 6 |
| 10 | RES#: Active-low global reset | input | 6 |
| 11 | D/C#: Data/command select | input | 6 |
| 12 | CS#: Active-low chip select | input | 6 |
| 13 | SCL: SPI clock input | input | 6 |
| 14 | SDA: SPI serial data | bidirectional | 6 |
| 15 | VDDIO: Logic/I/O supply, nominal 3.3 V | power_in | 6 |
| 16 | VCI: Analog/chip supply, nominal 3.3 V | power_in | 6 |
| 17 | VSS: Ground | power_in | 6 |
| 18 | VDD: Core regulator node, nominal 1.8 V; decouple only for internal-regulator use | power | 6 |
| 19 | VPP: OTP programming node, nominal 7.5 V; no external programming supply in badge | power | 6 |
| 20 | VSH1: Positive source rail, nominal +15 V | power | 6 |
| 21 | VGH: Positive gate rail, nominal +20 V | power | 6 |
| 22 | VSL: Negative source rail, nominal -15 V | power | 6 |
| 23 | VGL: Negative gate rail, nominal -20 V | power | 6 |
| 24 | VCOM: Common-electrode drive output | power | 6 |

Status: source facts and electrical assignments independently reviewed; see [display review](../design/review_display.md). Physical and prototype gates are listed in [library acceptance](display_library_acceptance.md).
