thebenedict/tinkerbadge-hardware/docs/components/IR67-21C-TR8.md

# IR67-21C/TR8 component facts

## Source and physical package

[IR67-21C-TR8.pdf](https://www.everlighteurope.com/custom/files/datasheets/DIR-0000986.pdf), DIR-0000986 Rev3,10 July2013; approval stamp12 July2013. [Source](https://www.everlighteurope.com/custom/files/datasheets/DIR-0000986.pdf). URL, retrieval route and SHA256 are in `IR67-21C-TR8.source.json` under datasheets.

SMD3528 two-terminal emitter,3.5×2.7×1.9mm. No exposed pad. Polarity mark and pad numbering must match exact drawing.

Inspected actual p1–2 package and pin-table pixels, peripheral_views/IR67-page1.png and IR67-page2.png.

| Physical pin | Name | Function | PDF page |
|---|---|---|---|
| 1 | ANODE | IR LED anode | 2 |
| 2 | CATHODE | IR LED cathode | 2 |

## Limits and working baseline

940nm emitter,120° full viewing angle. At20mA, VF1.2V typical/1.5V maximum. Continuous IF65mA and power130mW at25°C, with thermal derating. Pulsed1A absolute limit requires≤100µs and≤1% duty; that rating must not be used for a33–50% duty38kHz carrier.

D501 anode fed from3.3V through100Ω1%0805≥0.25W resistor; cathode to AO3400A drain. Nominal about21mA with1.2V VF. Even with zero LED drop and3.6V rail the electrical bound is36.4mA, below25°C continuous limit. Worst resistor short-LED dissipation3.6²/99≈131mW, hence≥0.25W. Board use is initially0–45°C; thermal and optical range still require assembled testing. Use38kHz carrier, one-third carrier duty and bounded packet duty. All gate defaults low; storage emits nothing. This is a working option for optical experiments, not a certified high-power IR product.

## Review state

Extracted 2026-11-09. Electrical source facts and assignments passed [independent review](../design/review_peripherals.md). Connections are maintained in [the peripheral contract](../design/peripherals_contract.json); physical mating, footprints and prototype checks remain separate gates.
