thebenedict/tinkerbadge-hardware/docs/components/MBR0530T1G.md

# MBR0530T1G

Three 30 V / 0.5 A Schottky rectifiers. The actual CASE 425 STYLE 1 drawing on PDF page 4 identifies cathode pin 1 at the banded end and anode pin 2. D301 clamps the flying-capacitor node; D302 rectifies VGL; D303 rectifies VGH. Nominal rail voltage does not establish switching-overshoot margin. The discontinued row on datasheet page 1 is NRVB0530T3G, not this part.

See [display circuit decisions](../design/display.md) for voltage margins, support values, boot/off-state behavior, and release gates.

## Physical pin facts

Source: [MBR0530T1G.pdf source record](MBR0530T1G.pins.json). MBR0530T1/D Rev 9; October 2024; 5 PDF pages. Machine-readable source: [MBR0530T1G.pins.json](MBR0530T1G.pins.json).

| Pin | Manufacturer function | Type | PDF page |
|---|---|---|---|
| 1 | K: Cathode, banded end | passive | 4 |
| 2 | A: Anode | passive | 4 |

Status: source facts and electrical assignments independently reviewed; see [display review](../design/review_display.md). Physical and prototype gates are listed in [library acceptance](display_library_acceptance.md).
