thebenedict/tinkerbadge-hardware/docs/design/jlcpcb_parts_check_2026-11-11.csv

LCSC Part # | Manufacturer Part | Comment | Qty per board | JLCPCB library | JLCPCB stock | Unit price USD (qty 1 tier) | Line USD | Read on
C28323 | CL21B105KBFNNNE | 1uF 25V X7R | 11 | Basic | 3698947 | 0.0296 | 0.3256 | 2026-11-10
C29823 | 1206B475K500NT | 4.7uF 25V X7R | 3 | Basic | 602626 | 0.0697 | 0.2091 | 2026-11-10
C14663 | CC0603KRX7R9BB104 | 100nF 16V X7R | 20 | Basic | 35882469 | 0.0058 | 0.116 | 2026-11-10
C15850 | CL21A106KAYNNNE | 10uF 10V X7R | 7 | Basic | 8319541 | 0.0314 | 0.2198 | 2026-11-10
C309062 | CL32B226KAJNNNE | 22uF 10V X7R | 2 | Extended | 137891 | 0.2423 | 0.4846 | 2026-11-10
C1588 | CL10B102KB8NNNC | 1nF 16V C0G | 1 | Basic | 5592980 | 0.0082 | 0.0082 | 2026-11-10
C45783 | CL21A226MAQNNNE | 22uF 10V X5R | 2 | Basic | 3791286 | 0.1055 | 0.211 | 2026-11-10
C1525 | CL05B104KO5NNNC | 100nF 16V X7R | 1 | Basic | 31631277 | 0.0031 | 0.0031 | 2026-11-10
C52923 | CL05A105KA5NQNC | 1uF 10V X7R | 1 | Basic | 10771625 | 0.0057 | 0.0057 | 2026-11-10
C107045 | CC0603JRNPO9BN270 | 27p C0G (tune) | 1 | Preferred Extended | 409458 | 0.0033 | 0.0033 | 2026-11-10
C19666 | CL10A475KO8NNNC | 4.7u / 10V | 1 | Basic | 3684108 | 0.015 | 0.015 | 2026-11-10
C15849 | CL10A105KB8NNNC | 1u / 10V | 2 | Basic | 12255666 | 0.0112 | 0.0224 | 2026-11-10
C19077499 | SMF6.0A | SMF6.0A | 2 | Preferred Extended | 593960 | 0.0318 | 0.0636 | 2026-11-10
C82046 | MBR0530T1G | MBR0530T1G | 3 | Extended | 211905 | 0.0628 | 0.1884 | 2026-11-10
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
C91447 | IRM-H638T/TR2 | IRM-H638T/TR2 | 1 | Extended | 129736 | 0.2546 | 0.2546 | 2026-11-10
C55266 | TPS2553DBVR | TPS2553DBVR | 1 | Extended | 55487 | 0.5525 | 0.5525 | 2026-11-10
C783615 | TCA9534PWR | TCA9534PWR | 1 | Extended | 8282 | 0.9301 | 0.9301 | 2026-11-10
