thebenedict/tinkerbadge-hardware/exports/design-review-2026-11-11/bom.csv

Reference | Value | Footprint | MPN | Qty | DNP
C101,C102 | 1uF 25V X7R | Capacitor_SMD:C_0805_2012Metric | CL21B105KBFNNNE | 2
C103 | 4.7uF 25V X7R | Capacitor_SMD:C_1206_3216Metric | 1206B475K500NT | 1
C104 | 100nF 16V X7R | Capacitor_SMD:C_0603_1608Metric | CC0603KRX7R9BB104 | 1
C105-C107 | 10uF 10V X7R | Capacitor_SMD:C_0805_2012Metric | CL21A106KAYNNNE | 3
C108,C109 | 22uF 10V X7R | Capacitor_SMD:C_1210_3225Metric | CL32B226KAJNNNE | 2
C112 | 1uF 6.3V X7R | Capacitor_SMD:C_0805_2012Metric | CL21B105KBFNNNE | 1
C113 | 1nF 16V C0G | Capacitor_SMD:C_0603_1608Metric | CL10B102KB8NNNC | 1
C114 | 10uF 6.3V X7R | Capacitor_SMD:C_0805_2012Metric | CL21A106KAYNNNE | 1
C116 | 100nF 6.3V X7R | Capacitor_SMD:C_0603_1608Metric | CC0603KRX7R9BB104 | 1
C201 | 22uF 10V X5R | Capacitor_SMD:C_0805_2012Metric | CL21A226MAQNNNE | 1
C202 | 100nF 16V X7R | Capacitor_SMD:C_0402_1005Metric | CL05B104KO5NNNC | 1
C203 | 1uF 10V X7R | Capacitor_SMD:C_0402_1005Metric | CL05A105KA5NQNC | 1
C301,C302 | 4.7u / 50V | Capacitor_SMD:C_1206_3216Metric | 1206B475K500NT | 2
C303,C401-C408,C411,C412,C501-C504,C506,C510,C514 | 100n / 10V | Capacitor_SMD:C_0603_1608Metric | CC0603KRX7R9BB104 | 18
C304 | 1u / 10V | Capacitor_SMD:C_0805_2012Metric | CL21B105KBFNNNE | 1
C305,C311 | 1u / 25V | Capacitor_SMD:C_0805_2012Metric | CL21B105KBFNNNE | 2
C306-C310 | 1u / 50V | Capacitor_SMD:C_0805_2012Metric | CL21B105KBFNNNE | 5
C409 | 22u / 10V | Capacitor_SMD:C_0805_2012Metric | CL21A226MAQNNNE | 1
C505,C512,C513 | 10u / 10V | Capacitor_SMD:C_0805_2012Metric | CL21A106KAYNNNE | 3
C507 | 27p C0G (tune) | Capacitor_SMD:C_0603_1608Metric | CC0603JRNPO9BN270 | 1
C509 | 4.7u / 10V | Capacitor_SMD:C_0603_1608Metric | CL10A475KO8NNNC | 1
C511,C515 | 1u / 10V | Capacitor_SMD:C_0603_1608Metric | CL10A105KB8NNNC | 2
D101,D102 | SMF6.0A | Tinkerbadge:SMF6.0A | SMF6.0A | 2
D301-D303 | MBR0530T1G | Diode_SMD:D_SOD-123 | MBR0530T1G | 3
D401-D408 | WS2812C-2020-V6 | Tinkerbadge:WS2812C-2020-V6_Reviewed | WS2812C-2020-V6 | 8
D409 | HSMF-C165 | Tinkerbadge:HSMF-C165 | HSMF-C165 | 1
D501 | IR67-21C/TR8 | Tinkerbadge:IR67-21C_TR8 | IR67-21C/TR8 | 1
J101 | USB4105-GF-A | Tinkerbadge:USB4105-GF-A_ProjectShells | USB4105-GF-A | 1
J102 | LiPo JST-PH | Connector_JST:JST_PH_S2B-PH-K_1x02_P2.00mm_Horizontal | S2B-PH-K-S(LF)(SN) | 1
J301 | ED037TC1_FPC | Tinkerbadge:Hirose_FH34SRJ-24S-0.5SH_PanelOrder | FH34SRJ-24S-0.5SH(50) | 1
J501 | SM04B-SRSS-TB(LF)(SN) | Tinkerbadge:JST_SH_SM04B_ProjectTabs | SM04B-SRSS-TB(LF)(SN) | 1
J502 | SFH11-NBPC-D03-ST-BK | Tinkerbadge:SAO_Socket_2x03_Front | SFH11-NBPC-D03-ST-BK | 1
L101 | 0.47uH | Inductor_SMD:L_Changjiang_FNR4020S | SWPA4020SR47NT | 1
L301 | 68uH | Inductor_SMD:L_Bourns-SRN4018 | SRN4018-680M | 1
Q101,Q102,Q501 | AO3400A | Package_TO_SOT_SMD:SOT-23 | AO3400A | 3
Q301 | Si1308EDL-T1-GE3 | Package_TO_SOT_SMD:SOT-323_SC-70 | SI1308EDL-T1-GE3 | 1
R101,R102 | 5.1k 1% | Resistor_SMD:R_0603_1608Metric | 0603WAF5101T5E | 2
R107 | 30k 1% | Resistor_SMD:R_0603_1608Metric | 0603WAF3002T5E | 1
R108,R118 | 10k 1% | Resistor_SMD:R_0603_1608Metric | 0603WAF1002T5E | 2
R109 | 82k 1% | Resistor_SMD:R_0603_1608Metric | 0603WAF8202T5E | 1
R111,R116,R121,R123,R124,R126 | 100k 1% | Resistor_SMD:R_0603_1608Metric | 0603WAF1003T5E | 6
R112 | 4.7k 1% | Resistor_SMD:R_0603_1608Metric | 0603WAF4701T5E | 1
R113 | 3.3k 1% | Resistor_SMD:R_0603_1608Metric | 0603WAF3301T5E | 1
R114 | 47k 1% | Resistor_SMD:R_0603_1608Metric | 0603WAF4702T5E | 1
R117 | 56k 1% | Resistor_SMD:R_0603_1608Metric | 0603WAF5602T5E | 1
R119 | 1k 1% | Resistor_SMD:R_0603_1608Metric | 0603WAF1001T5E | 1
R122,R125 | 470k 1% | Resistor_SMD:R_0603_1608Metric | 0603WAF4703T5E | 2
R127,R128 | 1M 1% | Resistor_SMD:R_0603_1608Metric | 0603WAF1004T5E | 2
R201-R204 | 10k 1% | Resistor_SMD:R_0402_1005Metric | 0402WGF1002TCE | 4
R205,R206 | 22R 1% | Resistor_SMD:R_0402_1005Metric | 0402WGF220JTCE | 2
R207 | 100k 1% | Resistor_SMD:R_0402_1005Metric | 0402WGF1003TCE | 1
R301 | 0.47 / 0.25W | Resistor_SMD:R_0805_2012Metric | FBF05FT-R470-00L | 1
R302,R503 | 10k | Resistor_SMD:R_0603_1608Metric | 0603WAF1002T5E | 2
R308,R402,R405,R406,R412,R506,R509-R511 | 100k | Resistor_SMD:R_0603_1608Metric | 0603WAF1003T5E | 9
R401,R411,R413,R415 | 330 | Resistor_SMD:R_0603_1608Metric | 0603WAF3300T5E | 4
R403,R404 | 2.2k | Resistor_SMD:R_0603_1608Metric | 0603WAF2201T5E | 2
R501,R502,R512,R513 | 4.7k | Resistor_SMD:R_0603_1608Metric | 0603WAF4701T5E | 4
R504 | 100 | Resistor_SMD:R_0805_2012Metric | 0805W8F1000T5E | 1
R505,R507 | 100 | Resistor_SMD:R_0603_1608Metric | 0603WAF1000T5E | 2
R508 | 200k | Resistor_SMD:R_0603_1608Metric | 0603WAF2003T5E | 1
RT101 | 10k NTC B3950 1% | Resistor_SMD:R_0603_1608Metric | KNTC0603/10KF3950 | 1
RT102 | 100k NTC B3950 1% | Resistor_SMD:R_0603_1608Metric | KNTC0603/100KF3950 | 1
SW401-SW403 | SKSCLBE010 | Tinkerbadge:SKSCLBE010 | SKSCLBE010 | 3
TP101 | VSYS | TestPoint:TestPoint_Pad_D1.0mm | PCB pad only: no fitted component | 1
TP201 | MCU_EN | TestPoint:TestPoint_Pad_D1.0mm | PCB pad only: no fitted component | 1
TP202 | BOOT / BTN_B | TestPoint:TestPoint_Pad_D1.0mm | PCB pad only: no fitted component | 1
TP203 | +3V3 | TestPoint:TestPoint_Pad_D1.0mm | PCB pad only: no fitted component | 1
TP204 | GND | TestPoint:TestPoint_Pad_D1.0mm | PCB pad only: no fitted component | 1
TP205 | UART_TX | TestPoint:TestPoint_Pad_D1.0mm | PCB pad only: no fitted component | 1
TP206 | UART_RX | TestPoint:TestPoint_Pad_D1.0mm | PCB pad only: no fitted component | 1
TP301 | +3V3_EPD | TestPoint:TestPoint_Pad_D1.0mm | PCB pad only: no fitted component | 1
TP501 | I2C_SDA | TestPoint:TestPoint_Pad_D1.0mm | PCB pad only: no fitted component | 1
TP502 | I2C_SCL | TestPoint:TestPoint_Pad_D1.0mm | PCB pad only: no fitted component | 1
U101 | TPS2121RUXR | Tinkerbadge:TPS2121RUXR_Reviewed | TPS2121RUXR | 1
U102 | BQ24074RGTR | Tinkerbadge:BQ24074RGTR_Reviewed | BQ24074RGTR | 1
U103 | TPS63802DLAR | Tinkerbadge:TPS63802_DLA0010A_Reviewed | TPS63802DLAR | 1
U104 | TPS22918DBVR | Package_TO_SOT_SMD:SOT-23-6 | TPS22918DBVR | 1
U105 | TPD4E05U06DQAR | Package_SON:USON-10_2.5x1.0mm_P0.5mm | TPD4E05U06DQAR | 1
U201 | ESP32-S3-WROOM-1-N16R8 | RF_Module:ESP32-S3-WROOM-1 | ESP32-S3-WROOM-1-N16R8 | 1
U501 | BH1730FVC | Tinkerbadge:BH1730FVC_WSOF6 | BH1730FVC | 1
U502 | LIS2DW12TR | Package_LGA:LGA-12_2x2mm_P0.5mm | LIS2DW12TR | 1
U503 | NT3H2111W0FHKH | Tinkerbadge:NT3H2111W0FHKH_XQFN8 | NT3H2111W0FHKH | 1
U504 | IRM-H638T/TR2 | Tinkerbadge:IRM-H638T_Reviewed | IRM-H638T/TR2 | 1
U505 | TPS2553DBVR | Package_TO_SOT_SMD:SOT-23-6 | TPS2553DBVR | 1
U506 | TCA9534PWR | Package_SO:TSSOP-16_4.4x5mm_P0.65mm | TCA9534PWR | 1
