thebenedict/tinkerbadge-hardware/production/jlcpcb/bom-hand-fit.csv

Comment | Designator | Footprint | LCSC Part # | Manufacturer Part | Qty | Note
LiPo JST-PH | J102 | JST_PH_S2B-PH-K_1x02_P2.00mm_Horizontal | C173752 | S2B-PH-K-S(LF)(SN) | 1 | through-hole, solder by hand after SMT
SFH11-NBPC-D03-ST-BK | J502 | SAO_Socket_2x03_Front | C3320727 | SFH11-NBPC-D03-ST-BK | 1 | through-hole, solder by hand after SMT
