thebenedict/tinkerbadge-hardware/docs/design/history/2026-11-09-80mm-before-group-spacing/review-artifacts/front-components.png

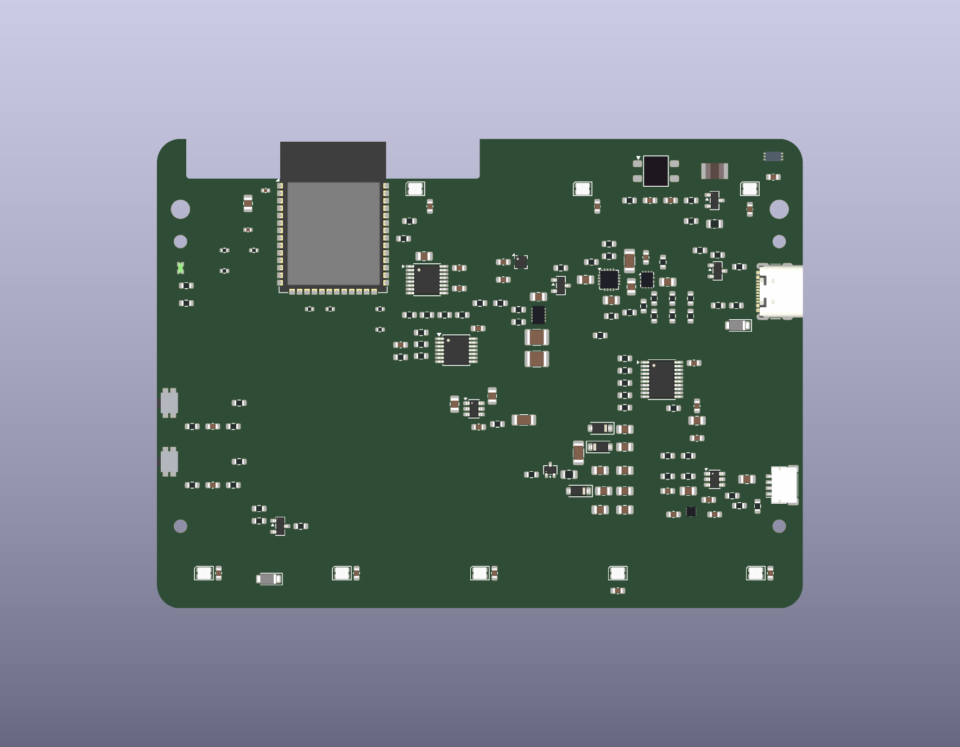
docs/design/history/2026-11-09-80mm-before-group-spacing/review-artifacts/front-components.png
