thebenedict/tinkerbadge-hardware/docs/design/history/2026-11-10-before-lower-ir/review/front-components-transparent.png

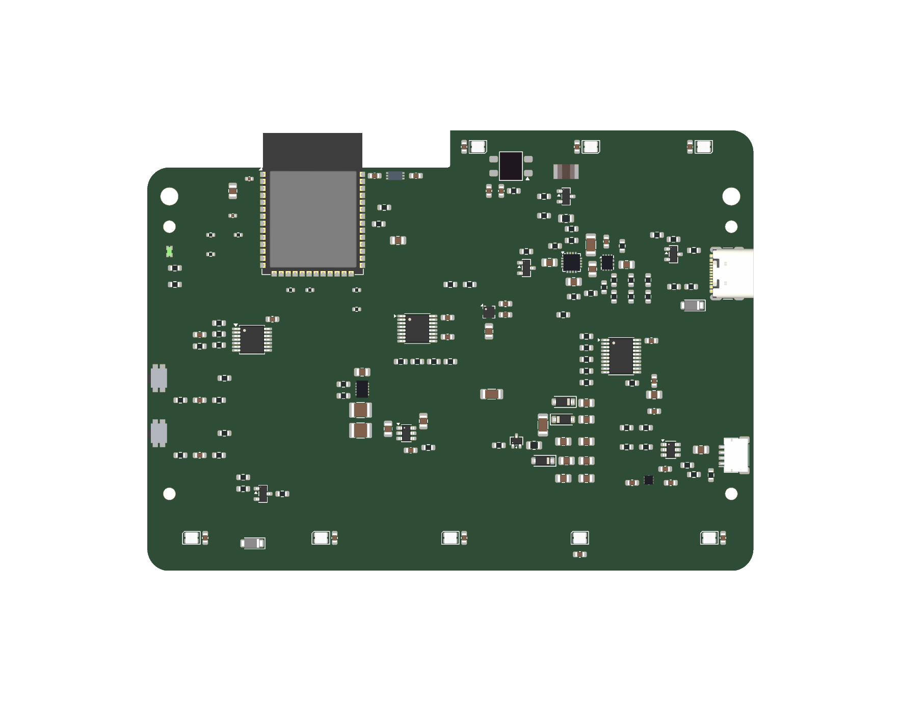
docs/design/history/2026-11-10-before-lower-ir/review/front-components-transparent.png
