thebenedict/tinkerbadge-hardware/exports/pcb-review/first-routing/front-components.png

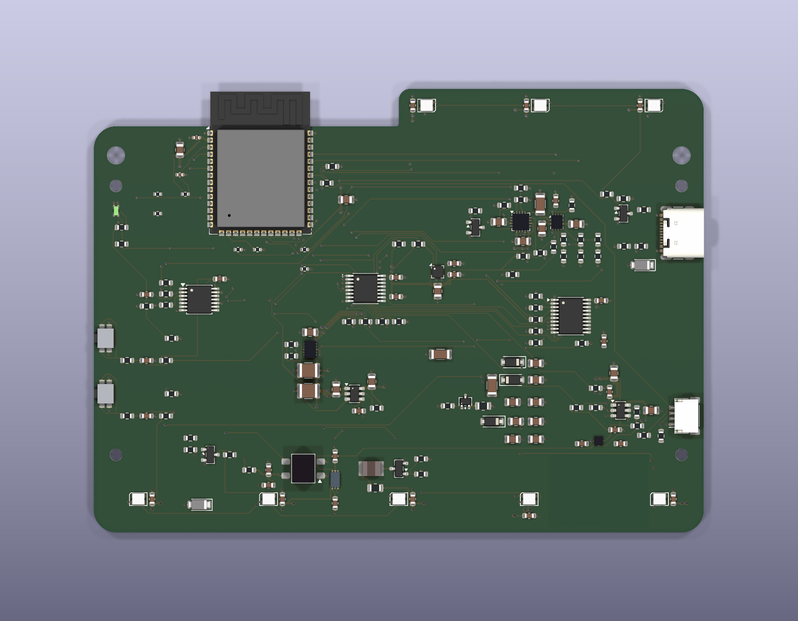
exports/pcb-review/first-routing/front-components.png
