thebenedict/tinkerbadge-hardware/mechanical/enclosure/exports/frame.step

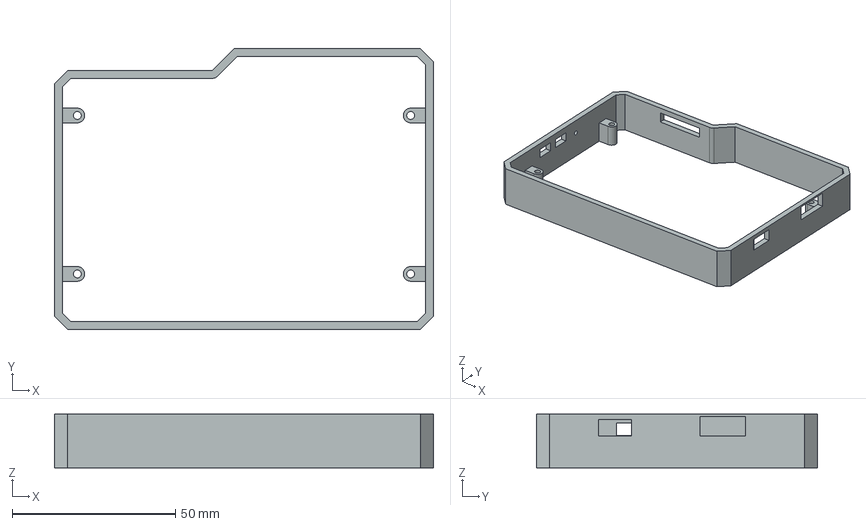
[picture p30: CAD file, 2026-11-12]
mechanical/enclosure/exports/frame.step
116.0 x 86.0 x 16.5 mm
