thebenedict/tinkerbadge-hardware/mechanical/enclosure/exports/battery-guide.step

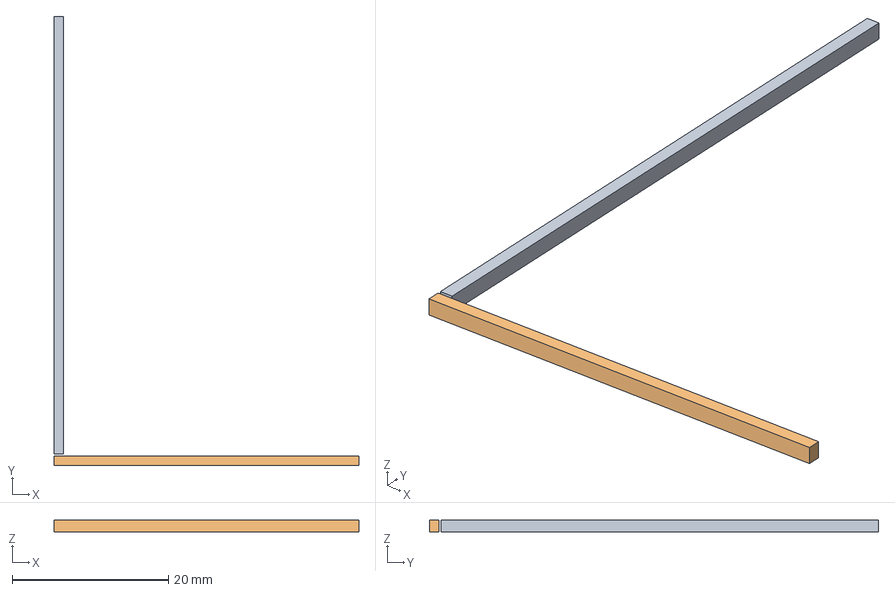
[picture p31: CAD file, 2026-11-12]
mechanical/enclosure/exports/battery-guide.step
39.0 x 57.5 x 1.50 mm
