thebenedict/tinkerbadge-hardware/mechanical/enclosure/exports/rear.step

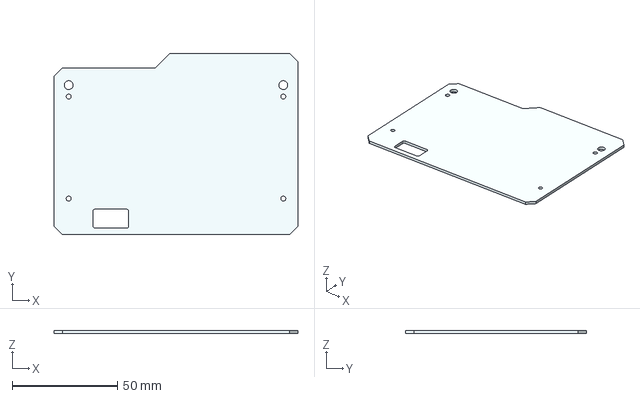
[picture p32: CAD file, 2026-11-12]
mechanical/enclosure/exports/rear.step
116.0 x 86.0 x 1.50 mm
