thebenedict/tinkerbadge-hardware/mechanical/enclosure/exports/support-H4.step

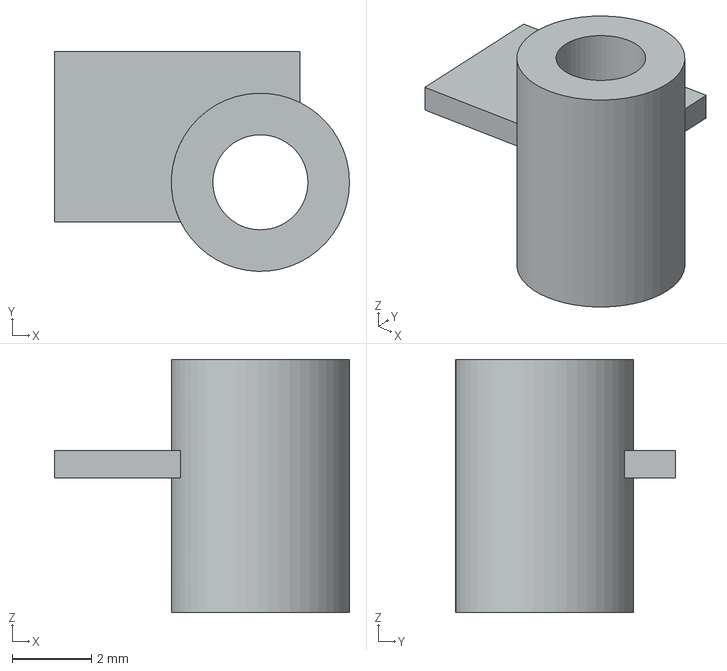
[picture p33: CAD file, 2026-11-12]
mechanical/enclosure/exports/support-H4.step
7.45 x 5.55 x 6.40 mm
