thebenedict/tinkerbadge-hardware/mechanical/enclosure/exports/support-H2.step

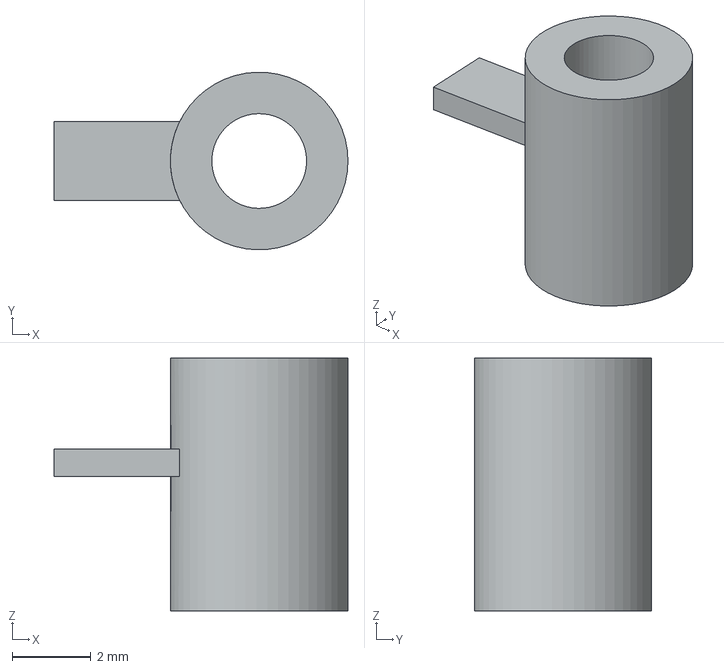
[picture p34: CAD file, 2026-11-12]
mechanical/enclosure/exports/support-H2.step
7.45 x 4.50 x 6.40 mm
