thebenedict/tinkerbadge-hardware/mechanical/enclosure/exports/enclosure.step

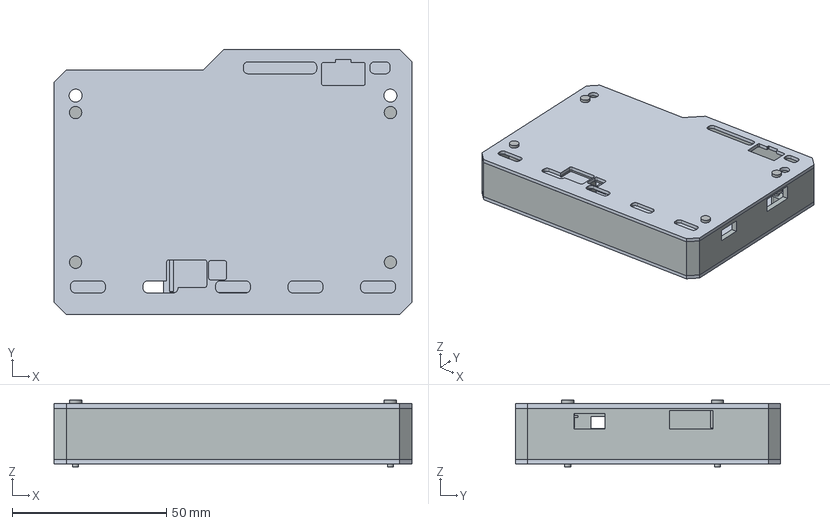
[picture p35: CAD file, 2026-11-12]
mechanical/enclosure/exports/enclosure.step
116.0 x 86.0 x 21.7 mm
Display support H1
Display support H2
Display support H3
Display support H4
Sensor light barrier
Stepped perimeter frame
M2 fastener H1
M2 fastener H2
M2 fastener H3
M2 fastener H4
