thebenedict/tinkerbadge-hardware/mechanical/enclosure/exports/support-H1.step

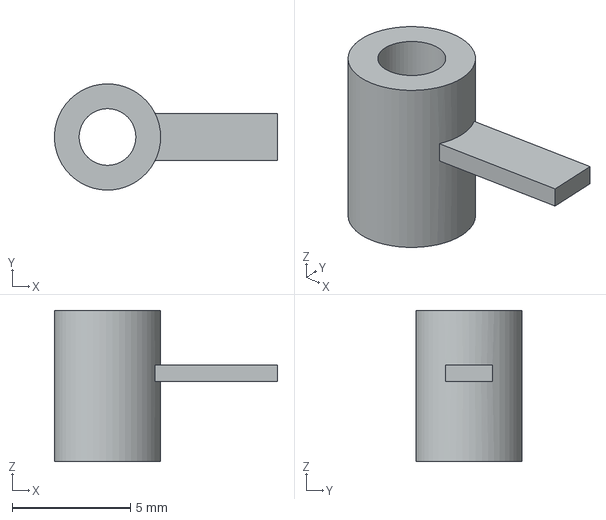
[picture p36: CAD file, 2026-11-12]
mechanical/enclosure/exports/support-H1.step
9.45 x 4.50 x 6.40 mm
