thebenedict/tinkerbadge-hardware/mechanical/enclosure/exports/support-H3.step

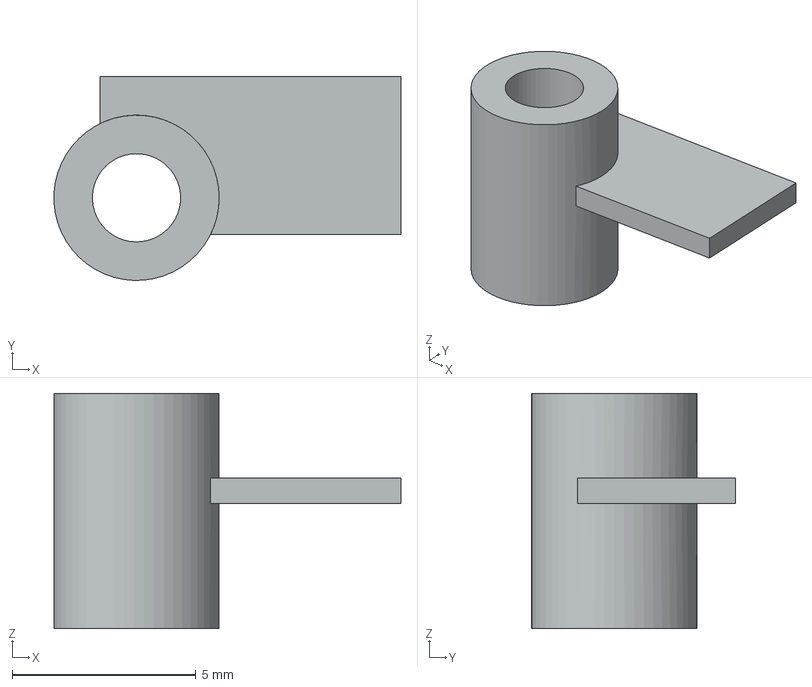
[picture p37: CAD file, 2026-11-12]
mechanical/enclosure/exports/support-H3.step
9.45 x 5.55 x 6.40 mm
