thebenedict/tinkerbadge-hardware/mechanical/enclosure/exports/front.step

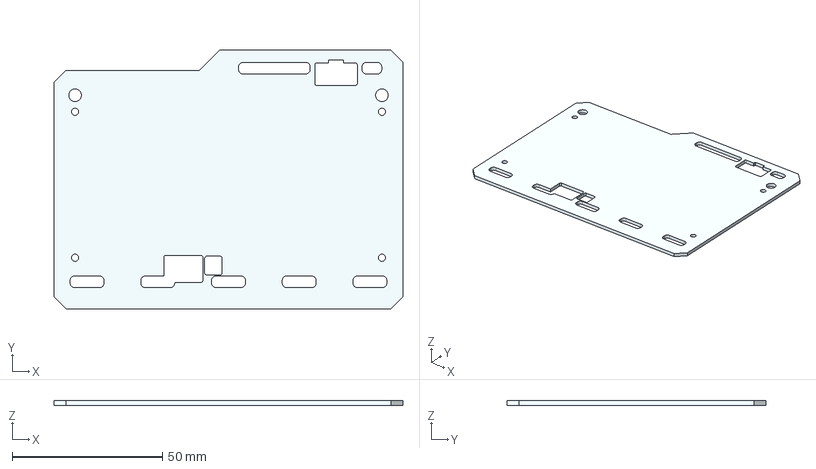
[picture p38: CAD file, 2026-11-12]
mechanical/enclosure/exports/front.step
116.0 x 86.0 x 1.50 mm
