thebenedict/tinkerbadge-hardware/mechanical/enclosure/exports/optical-baffle.step

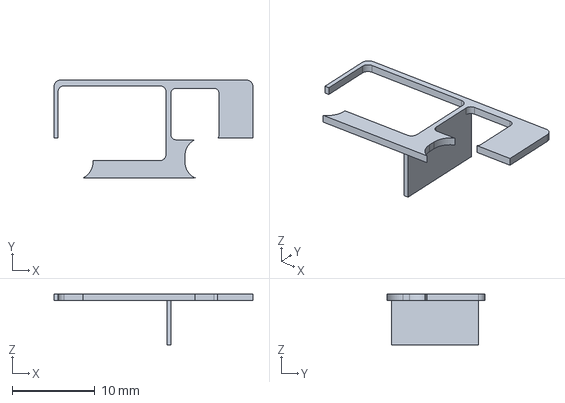
[picture p39: CAD file, 2026-11-12]
mechanical/enclosure/exports/optical-baffle.step
24.0 x 11.8 x 6.15 mm
