thebenedict/tinkerbadge-hardware/mechanical/enclosure/exports/screw-H4.step

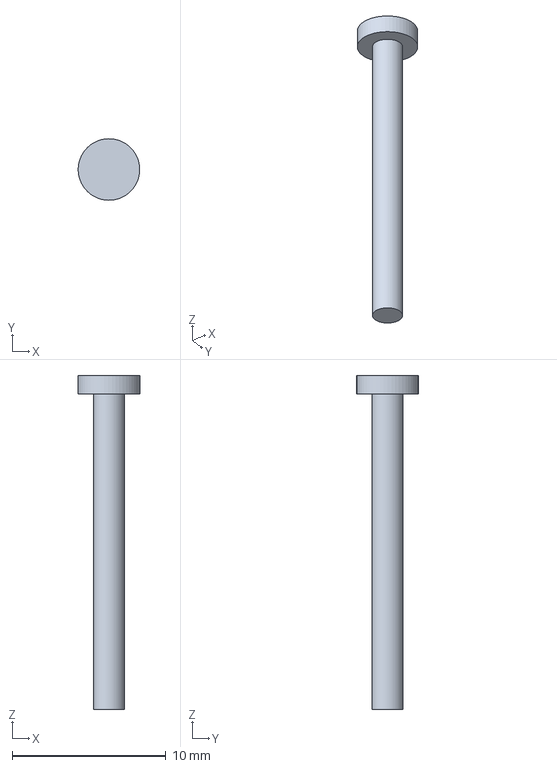
[picture p40: CAD file, 2026-11-12]
mechanical/enclosure/exports/screw-H4.step
4.00 x 4.00 x 21.7 mm
