thebenedict/tinkerbadge-hardware/(list of files, cad)

Other CAD files:
mechanical/enclosure/exports/screw-H2.step
mechanical/enclosure/exports/screw-H1.step
mechanical/enclosure/exports/screw-H3.step
mechanical/enclosure/exports/battery-guide.stl
mechanical/enclosure/exports/frame.stl
mechanical/enclosure/exports/front.dxf
mechanical/enclosure/exports/front.stl
mechanical/enclosure/exports/optical-baffle.stl
mechanical/enclosure/exports/rear.dxf
mechanical/enclosure/exports/rear.stl
mechanical/enclosure/exports/screw-H1.stl
mechanical/enclosure/exports/screw-H2.stl
mechanical/enclosure/exports/screw-H3.stl
mechanical/enclosure/exports/screw-H4.stl
mechanical/enclosure/exports/support-H1.stl
mechanical/enclosure/exports/support-H2.stl
mechanical/enclosure/exports/support-H3.stl
mechanical/enclosure/exports/support-H4.stl
