thebenedict/tinkerbadge-hardware/tests/fixtures/alps_buttons_snapshot/README.md

# Alps button snapshot

Reduced actual KiCad exported netlist for SW401/SW402 after the independently reviewed Alps SKSCLBE010 amendment. Only component/net nodes outside these switches are removed; source hashes are pinned in manifest.json. This fixture tests physical pin and symbol/property regressions, not source or footprint qualification.
