thebenedict/tinkerbadge-hardware/docs/design/history/power_3v95_before_single_3v3/docs/design/power_verification.md

# Power capture verification

Temporary review artifacts below are identified by filename only; these intermediate files are not distributed. Published source outputs and repeatable checks are linked from the [current verification record](../../../../verification.md).

9 November 2026. KiCad 10.0.8. Electrical development capture only.

- Source and assignment review: [review_power.md](review_power.md), including the two-wire and USB shell amendments.
- Independent exported-netlist checker: PASS, 63 components, 206 endpoints, 16 intentional NC endpoints, no missing or extra endpoints.
- Konnect checks: zero unconnected pins, zero floating wire endpoints, zero merged named nets and zero orphan items.
- Root ERC snapshot: no findings name a power reference. The complete project still had 282 findings while other sheets were being captured; this is not a project ERC pass.
- Disposable symbols were queried and rendered, then actual sheet pins were queried. The final render was inspected and field/ground-stub collisions corrected. A separate capture review is pending.

## Pinned evidence

- Contract: `e6117b29bcaa7d7c11b527b3b0ae852f057ef4d57d010c1c6cd636974148bccb`
- Power sheet: `137e7f1daf40aac11d6c4be061468b6c48a9999a3ebdb6682e1a062be78fc4c8`
- Power symbol library: `b486d4bd338bc0ad1079db7796dc91832527bd2b5ba9e774a866476a2127228f`
- Exported power netlist: `f7becfc1633dc1065ae864f44d7bf41c62d5d64395a43ab665b5a6f64cec310b`

Machine-readable results: [power_verification.json](power_verification.json). Preview: `power_final_reviewed.png`. Native writes were performed only by Konnect; orchestration/results are under `tools/` and the temporary working directory. Successful mutation stages are not idempotent and must not be rerun blindly.

## Build and release gates

Charging is hard-disabled in hardware by fitted R120. J104 remains DNP; fitting a thermistor does not enable or qualify charging. J102 is a logical two-wire interface, not a vendor connector pinout. All power footprints are deliberately unassigned. The exact stock pack, connector polarity/current rating, autonomous temperature qualification, inductor and capacitor MPNs, startup/current-mode transitions, rail/transient limits, ADC brownout behavior, storage draw and thermal performance still require selection or testing. No board layout, manufacturing or production readiness is established.
