thebenedict/tinkerbadge-hardware/docs/design/history/2026-11-10-before-routing/README.md

# Published placement before routing

This preserves the checked, unrouted board and current review records before the authorized R2 tip and routing pass. The complete source and library checkpoint is Git commit 1809844. Board SHA256: ddf824f2a59bc82568bbb03bcb3f89959f2ee12638b380790207739273c1844d. Published viewer snapshot: 9089771cc612. No manufacturing release is implied.
