thebenedict/tinkerbadge-hardware/docs/design/history/2026-11-09-100mm-two-sided-fallback/README.md

# Preserved 100 mm two-sided placement

Native board SHA256 99158950ecce21da92f8c0e9343ecf60316f321255fd496f790517ac7717f49f. This was the last checked placement before the requested one-sided, compact experiment. It is unrouted and not approved for production. Local libraries/models and schematic records are frozen with it.
