thebenedict/tinkerbadge-hardware/docs/design/history/2026-11-09-80mm-before-group-spacing/README.md

# Preserved compact placement before group spacing

Board SHA256 a49a19fdf1a2cea1b223f419887e369ab844f49adc9933a0688ba7f01e2ab7b4. This is the first checked 110 x 80 mm front-SMT experiment. It retains the former left PCB sliver and earlier sensor capacitor placement allocation. It is historical, unrouted, and not a manufacturing release.
