thebenedict/tinkerbadge-hardware/docs/design/history/2026-11-09-organized-before-top-row/README.md

# Intermediate organized placement

Historical 110 × 80 mm placement before the requested top-role LED row revision. Board SHA256 2ff74d95a154bce47ce87e97cf86c60af26514ff08235ffc70f8b9189b61ddda. This is a delta checkpoint, not a standalone project; unchanged source dependencies are preserved in the preceding 2026-11-09-80mm-before-group-spacing history directory. No routing was performed.
