thebenedict/tinkerbadge-hardware/docs/design/history/2026-11-10-annotation-before-portability/README.md

# Annotation provenance before portability cleanup

Historical generator, provenance and reproduction notes for the delivered version-1 optical-space annotation. These records preserve the original local execution paths and hashes. The current portable generator is retained in exports/pcb-review; PNG/SVG pixels and native CAD are unchanged by the portability cleanup. Exclude this historical local-path evidence from public distribution.
