thebenedict/tinkerbadge-hardware/docs/design/history/power_3v95_before_single_3v3/README.md

# Superseded 3.95 V / LDO development snapshot

Saved before the user-approved single nominal 3.3 V prototype amendment on 2026-11-09. This is historical evidence, not the current build. Paths inside the archived documents refer to the former project tree. Native files were copied unchanged for preservation; all design mutations remain Konnect-only. The LDO source and component record are retained here rather than in the active BOM inventory.
