thebenedict/tinkerbadge-hardware/docs/design/history/2026-11-10-before-lower-ir/CHECKPOINT.md

# Before lower IR relocation

Complete native project, libraries/models and review records before the requested IR move below the display. Board SHA256 8fa1ac386d237944d634cd7b5be0ca3ad3188f87965fbee94499eb1a51859399. The previous optical arrangement is historical and unrouted.
