thebenedict/tinkerbadge-hardware/exports/tinkerbadge-schematic.pdf

1 | 2 | 3 | 4 | 5 | 6
1 | 2 | 3 | 4 | 5 | 6

AB

C

D

AB

C

### D Date:

Size: A4 | Rev:
KiCad E.D.A. 10.0.8 | Id: 1/6

## Title:

### File: tinkerbadge.kicad_sch

### Sheet: /

02 PROCESSOR + RECOVERY

File: mcu.kicad_sch | 03 E-PAPER DISPLAY

File: display.kicad_sch 05 SENSORS + EXPANSION

File: peripherals.kicad_sch

01 POWER + CHARGING

File: power.kicad_sch 04 LIGHTING + BUTTONS

File: lighting.kicad_sch

ED037TC1 electrical interface Switched logic and isolated inputs Exact panel boost support

Ambient, motion, dynamic NFC IR transmit / receive Qwiic / SAO and status expander

INITIAL VARIANT Onboard charging is disabled. Two-wire protected LiPo; optional NTC not fitted. See docs/design/implementation_status.md

for physical and prototype release gates. PROTOTYPE RAIL DECISION

Shared 3.3 V supply, including the eight RGB LEDs. Tolerance can fall below the LED specified minimum. Startup / low-battery / Wi-Fi / LED-step tests required.

# TINKERBADGE / ELECTRICAL OVERVIEW

### Prototype schematic 0.1 | 2026-11-09 Source-controlled circuit contracts: docs/design/

Electrical source review precedes each populated block. | ESP32-S3-WROOM-1-N16R8 Native USB, UART and boot/reset Reviewed GPIO allocation

Three role + five affinity pixels Red / green power indicator Two buttons, RTC wake USB / dock input selection Power path, protected BAT sensing

Single nominal 3.3 V shared rail

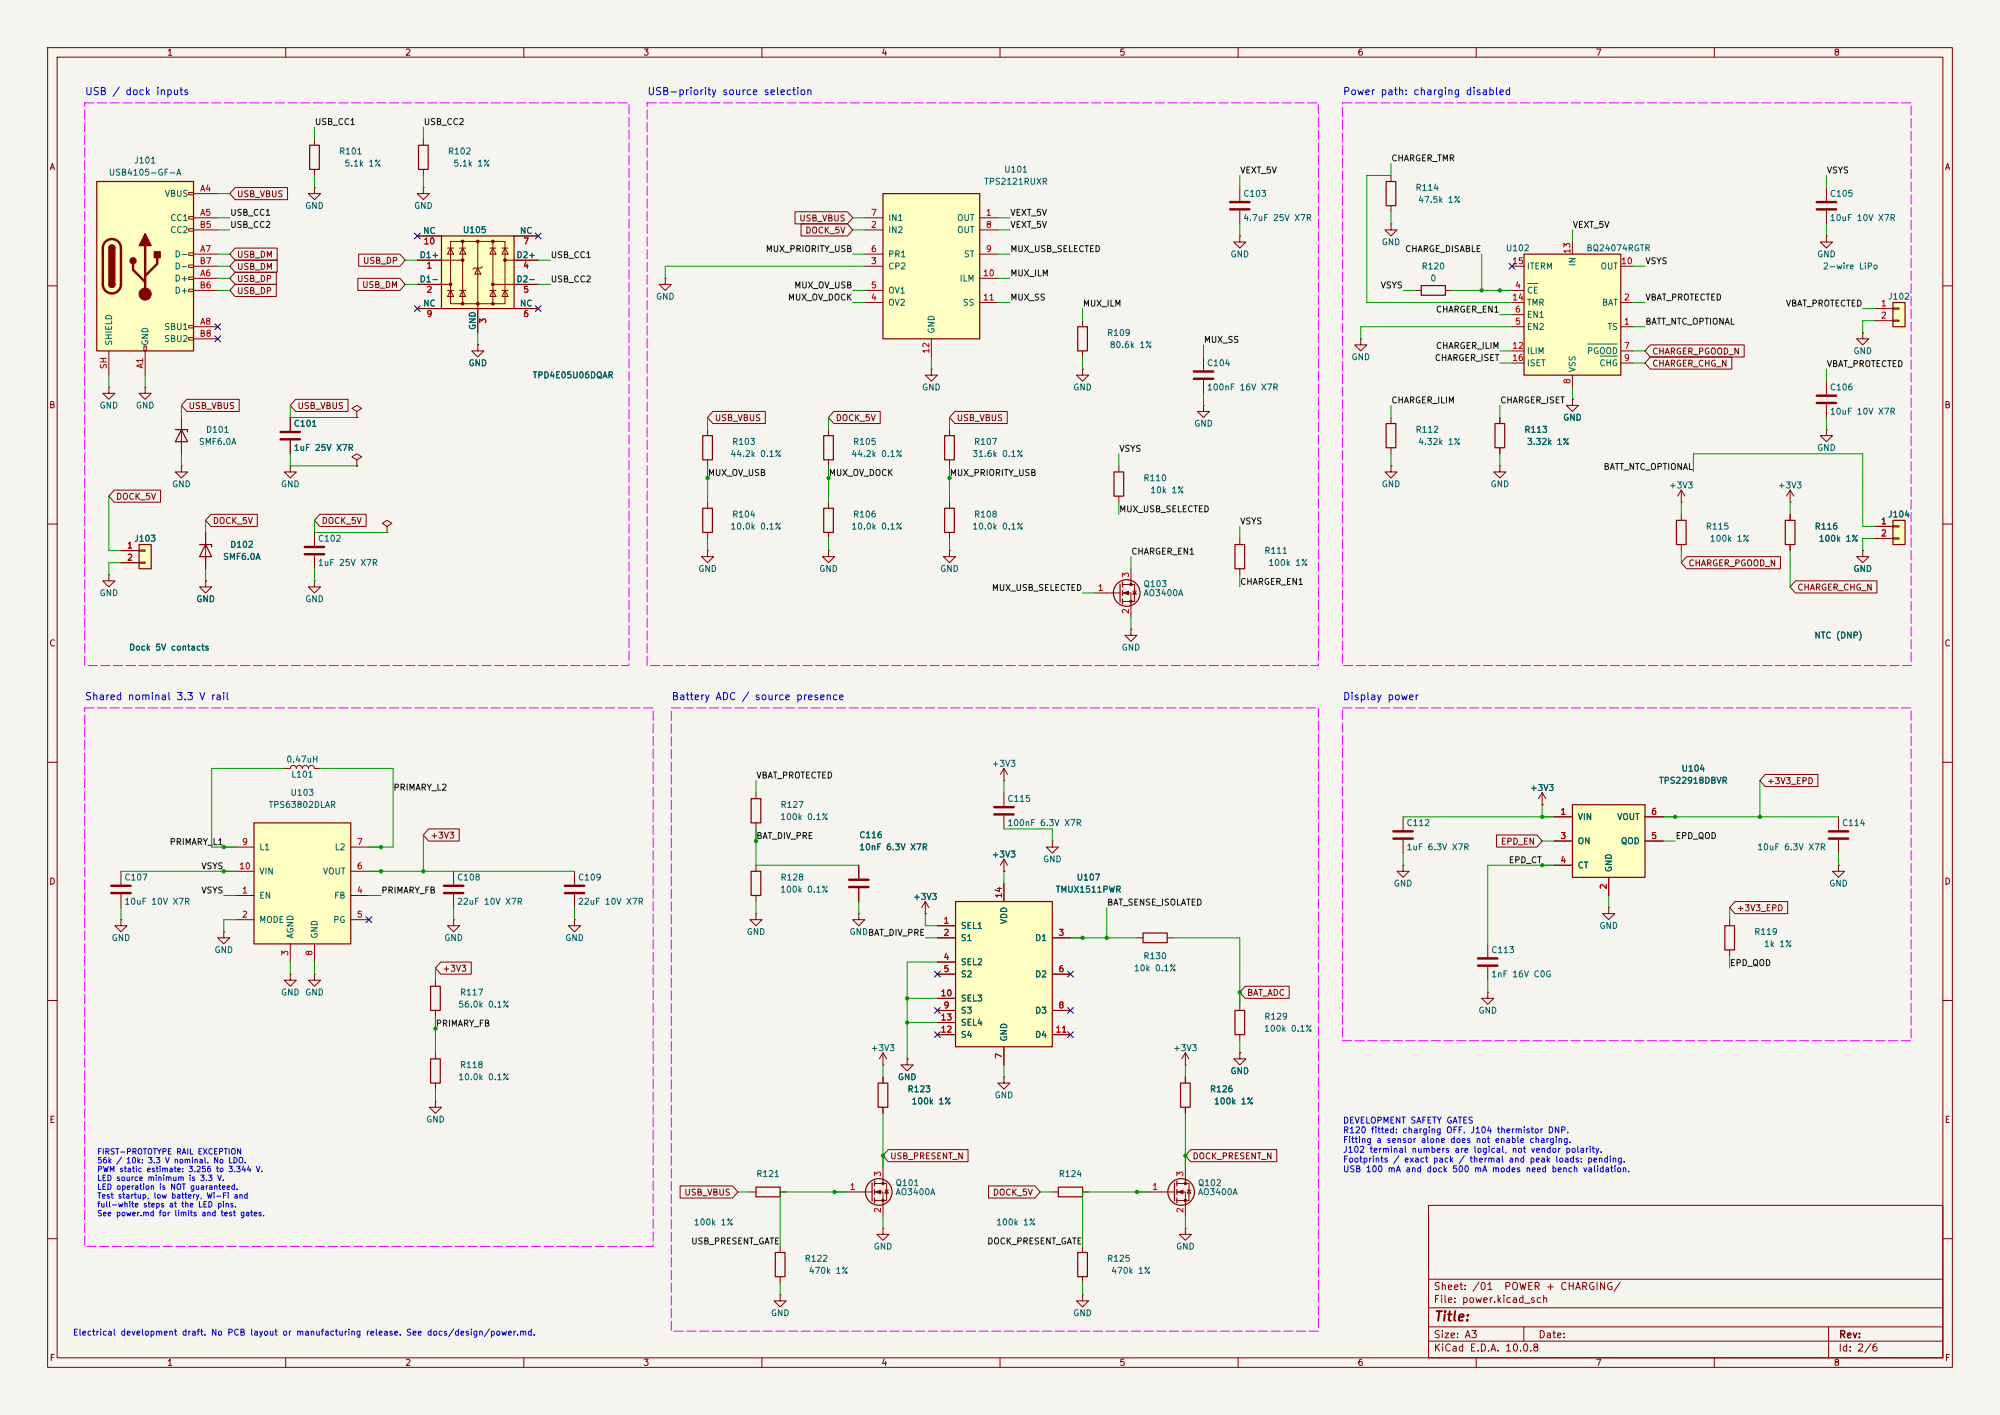
[picture p41: page 2]

Display power DEVELOPMENT SAFETY GATES R120 fitted: charging OFF. J104 thermistor DNP. Fitting a sensor alone does not enable charging. J102 terminal numbers are logical, not vendor polarity.

FIRST-PROTOTYPE RAIL EXCEPTION
56k / 10k: 3.3 V nominal. No LDO. PWM static estimate: 3.256 to 3.344 V. LED source minimum is 3.3 V. LED operation is NOT guaranteed. Test startup, low battery, Wi-Fi and

Footprints / exact pack / thermal and peak loads: pending. USB 100 mA and dock 500 mA modes need bench validation.

full-white steps at the LED pins. See power.md for limits and test gates. Electrical development draft. No PCB layout or manufacturing release. See docs/design/power.md.

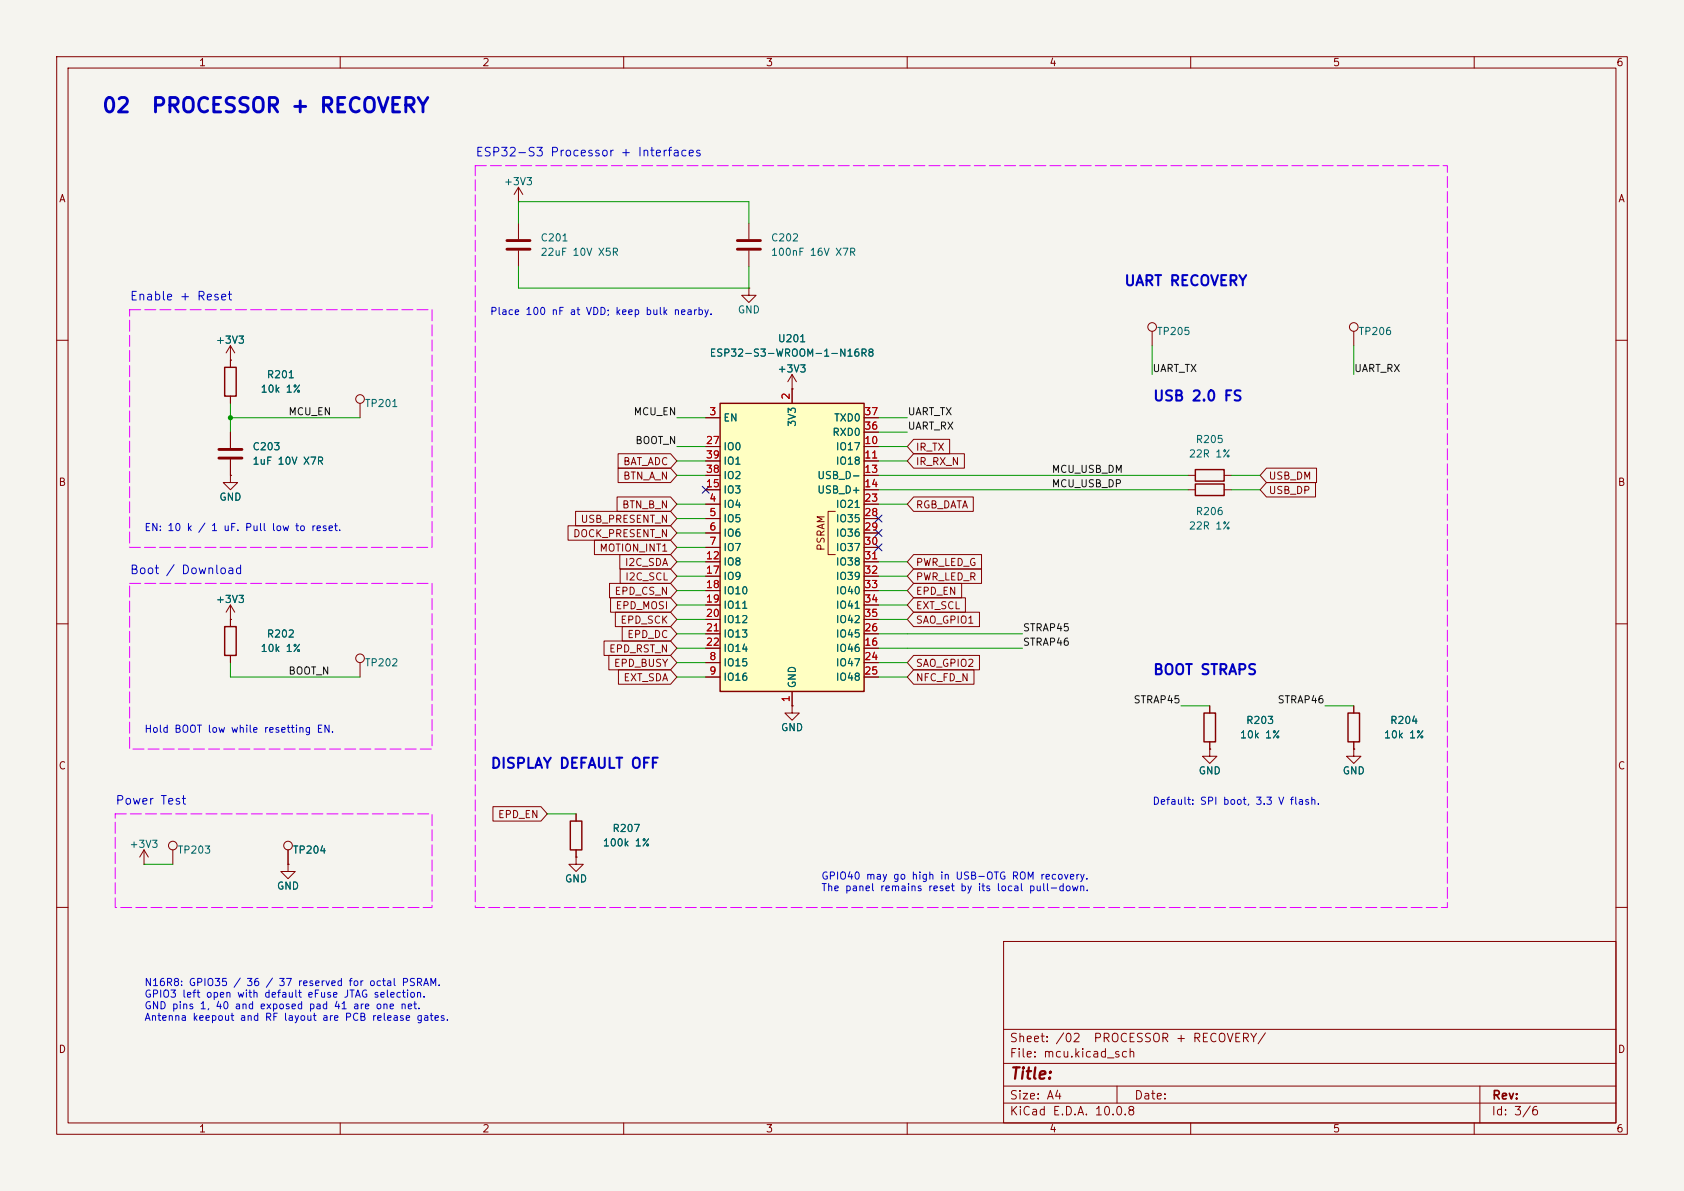
[picture p42: page 3]

Enable + Reset EN: 10 k / 1 uF. Pull low to reset. Boot / Download

Place 100 nF at VDD; keep bulk nearby.

Default: SPI boot, 3.3 V flash. GND

STRAP46 N16R8: GPIO35 / 36 / 37 reserved for octal PSRAM. GPIO3 left open with default eFuse JTAG selection. GND pins 1, 40 and exposed pad 41 are one net. Antenna keepout and RF layout are PCB release gates.

GPIO40 may go high in USB-OTG ROM recovery. The panel remains reset by its local pull-down.

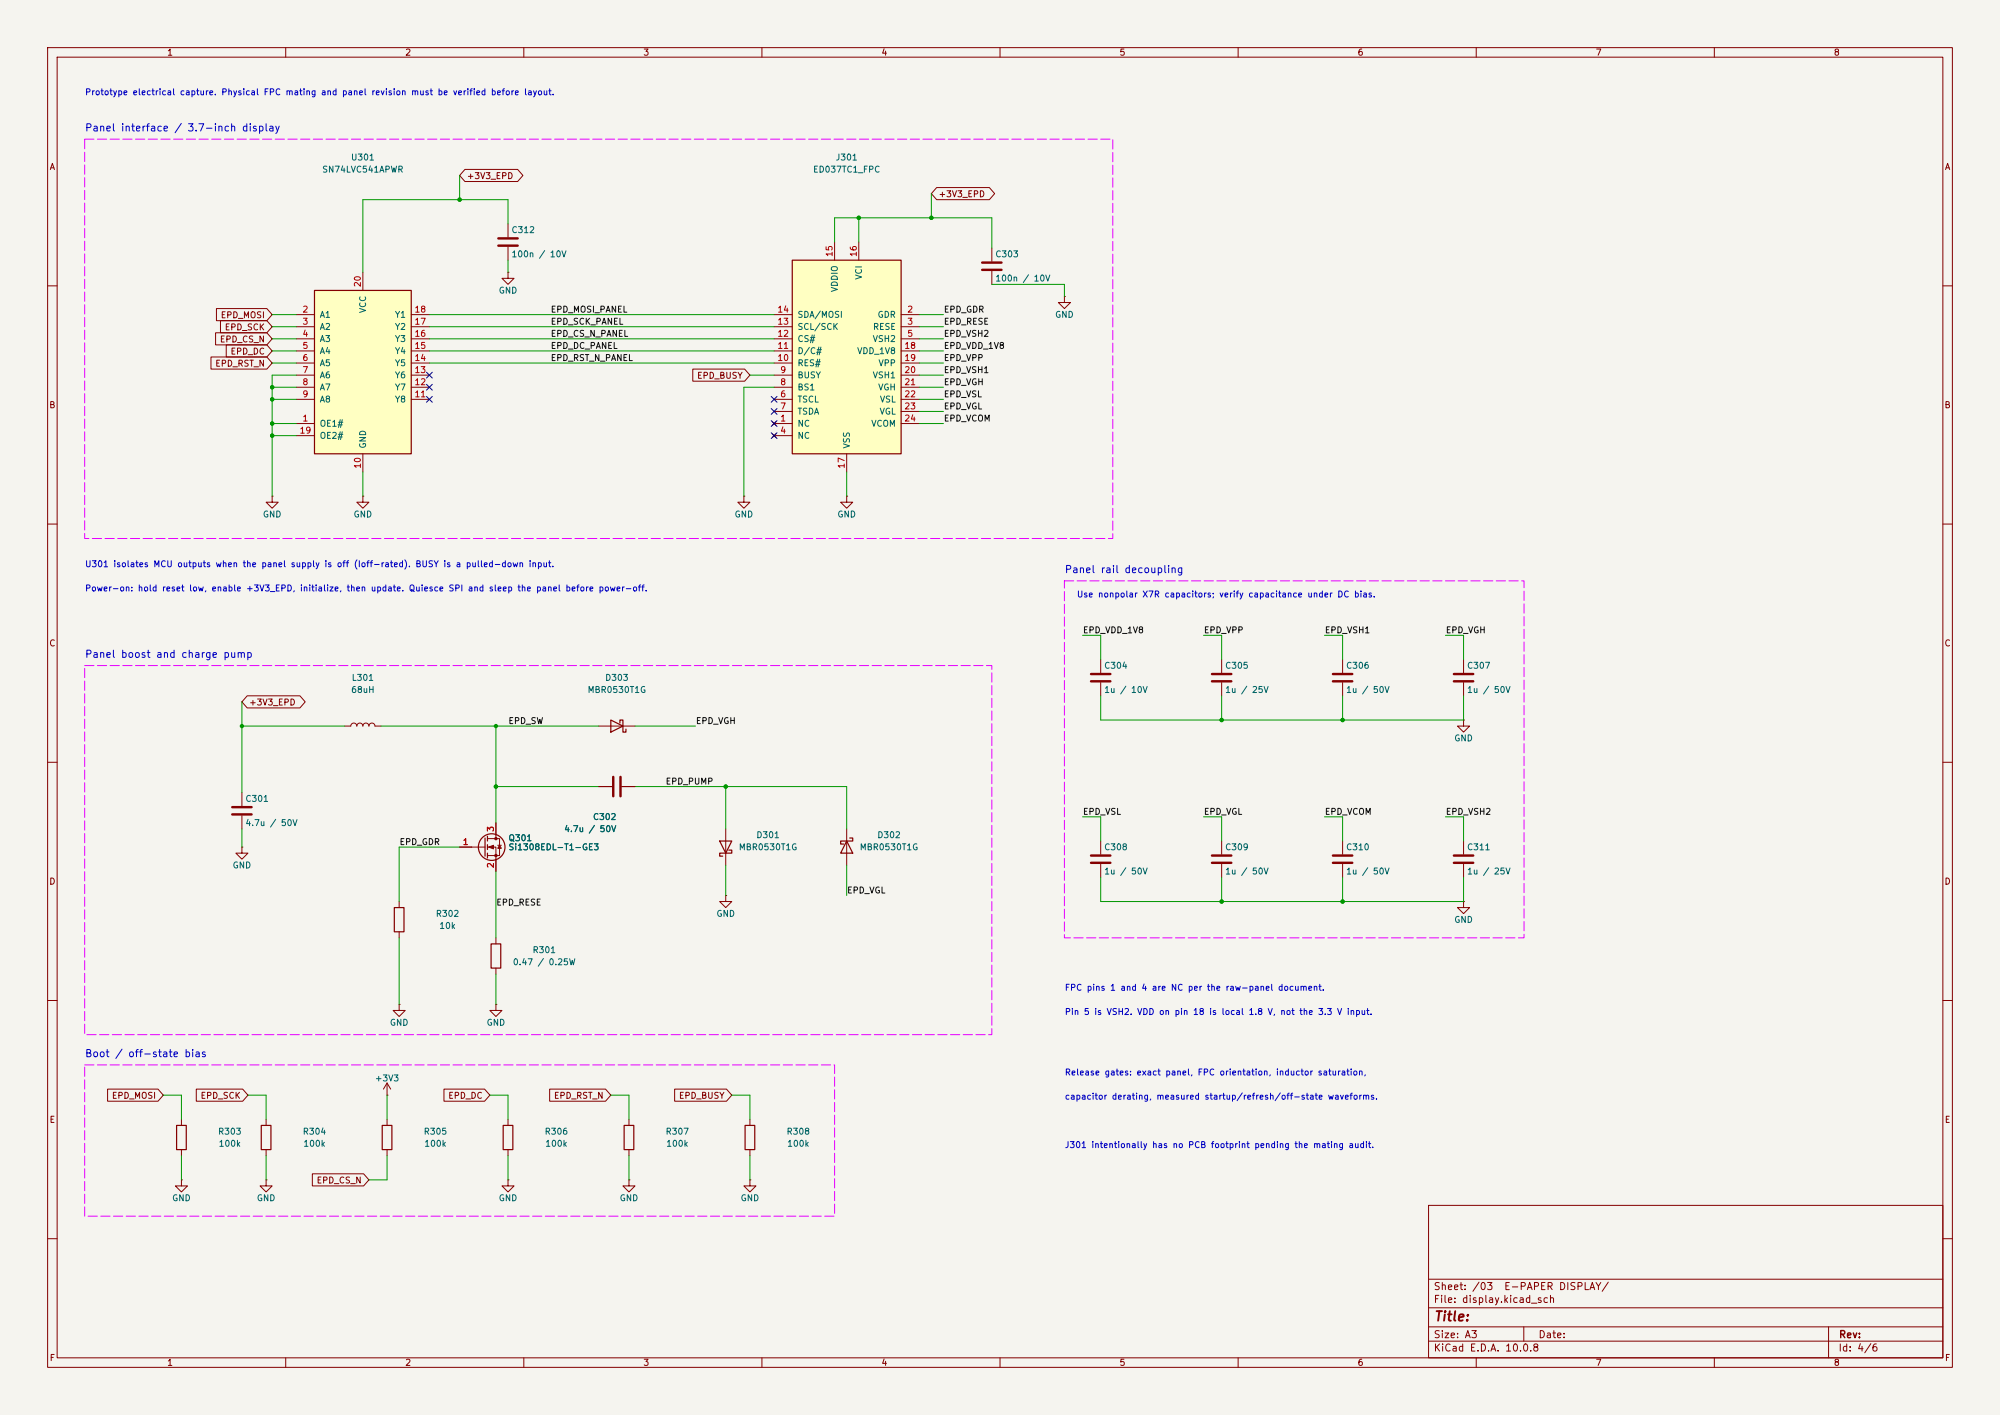
[picture p43: page 4]

Prototype electrical capture. Physical FPC mating and panel revision must be verified before layout.

Panel interface / 3.7-inch display

FPC pins 1 and 4 are NC per the raw-panel document. Pin 5 is VSH2. VDD on pin 18 is local 1.8 V, not the 3.3 V input. Release gates: exact panel, FPC orientation, inductor saturation,

Boot / off-state bias

capacitor derating, measured startup/refresh/off-state waveforms. J301 intentionally has no PCB footprint pending the mating audit.

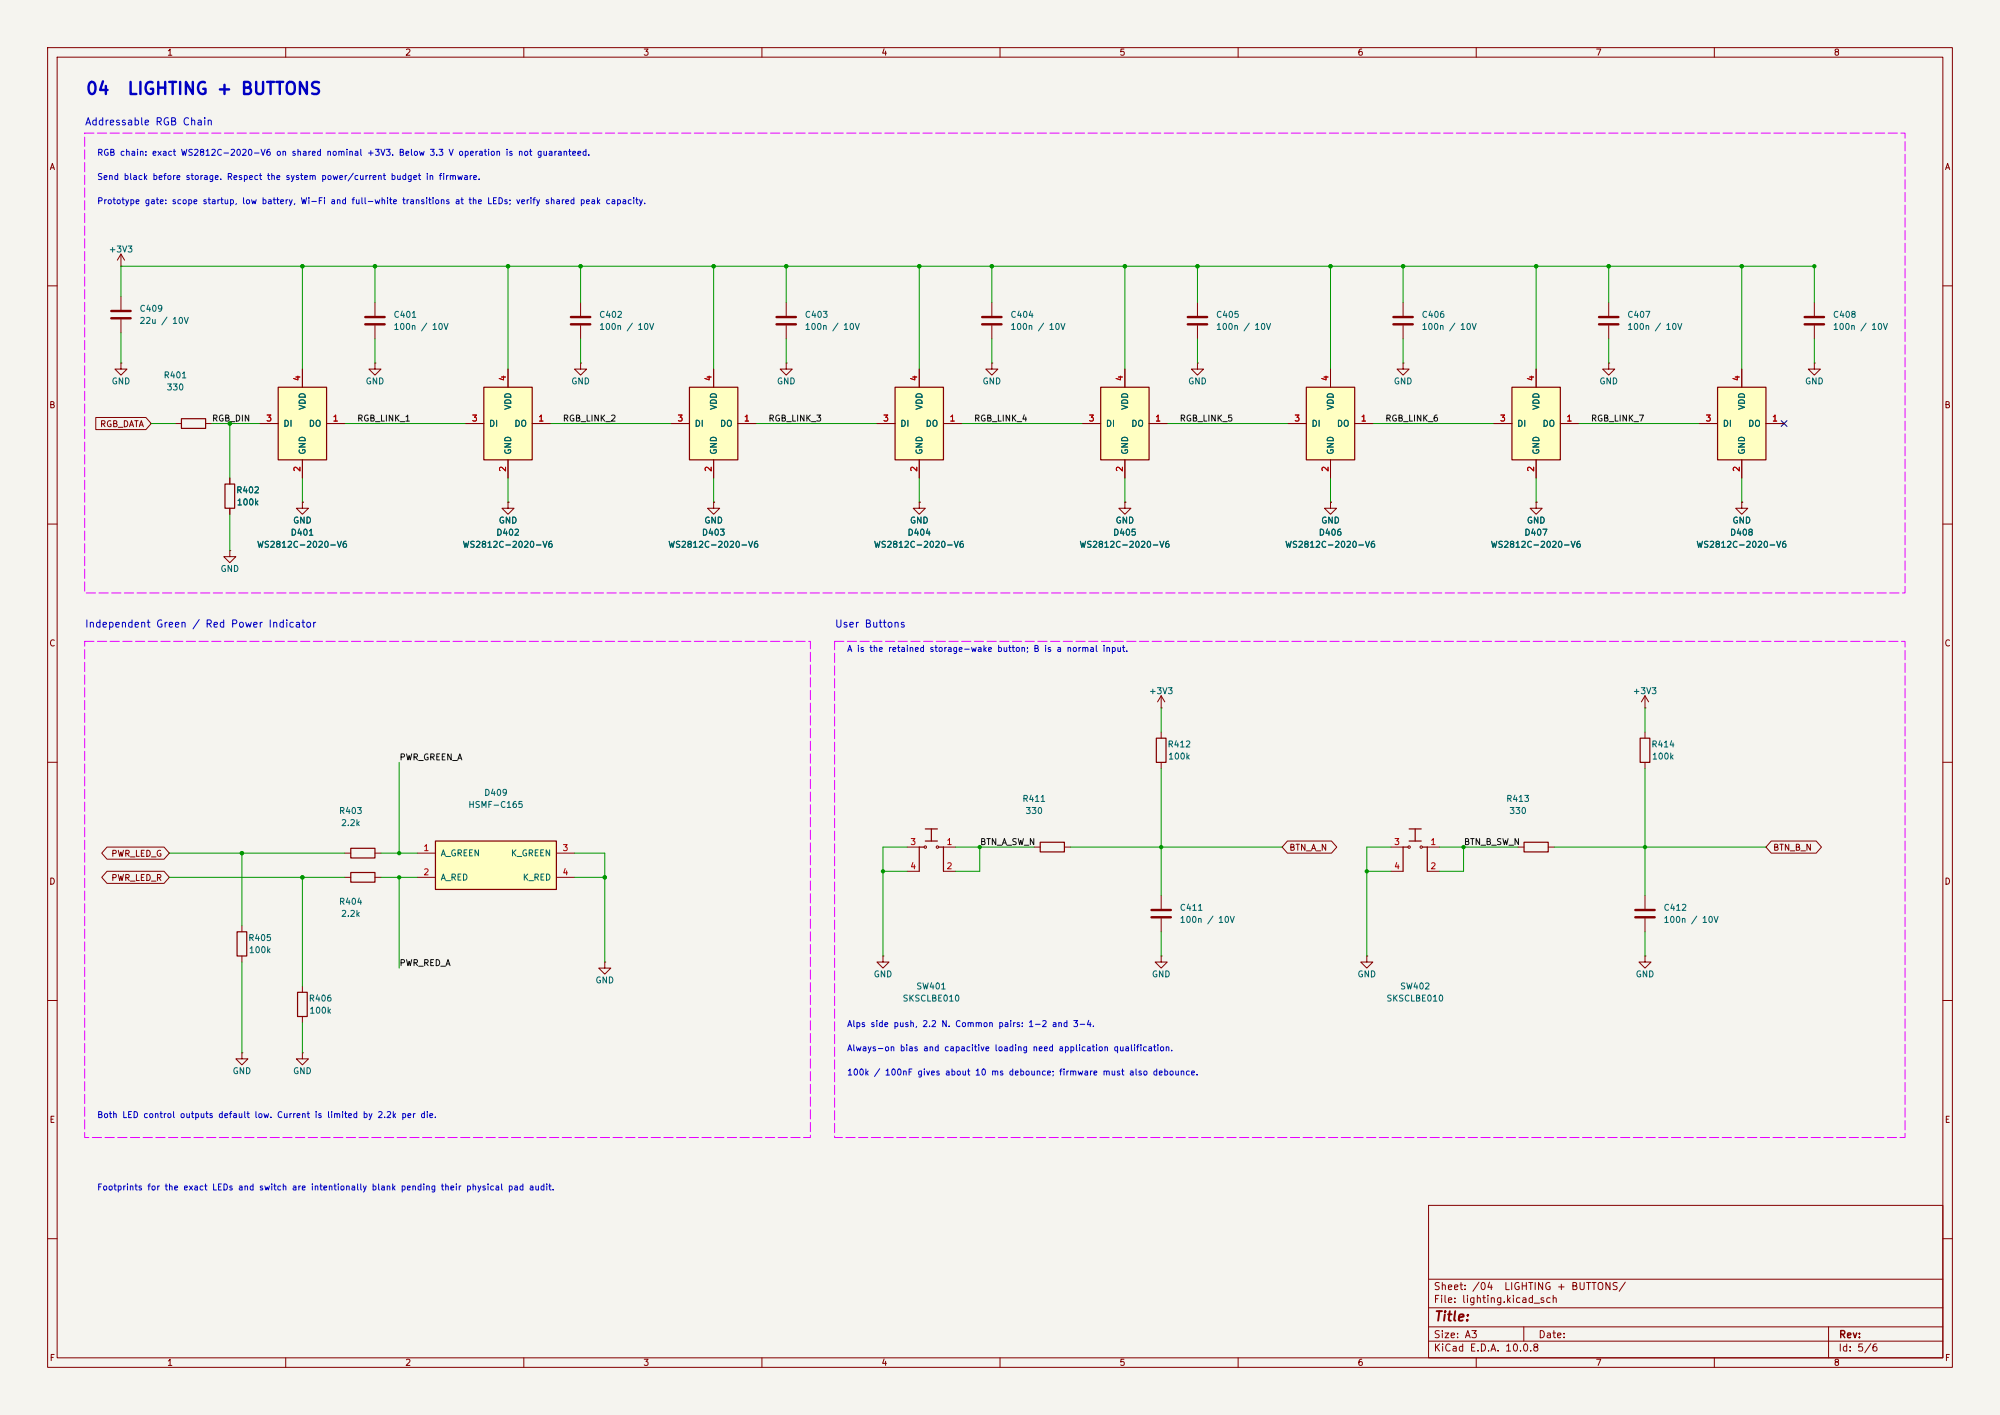
[picture p44: page 5]

Send black before storage. Respect the system power/current budget in firmware. RGB chain: exact WS2812C-2020-V6 on shared nominal +3V3. Below 3.3 V operation is not guaranteed.

Prototype gate: scope startup, low battery, Wi-Fi and full-white transitions at the LEDs; verify shared peak capacity.

Always-on bias and capacitive loading need application qualification.

Footprints for the exact LEDs and switch are intentionally blank pending their physical pad audit.

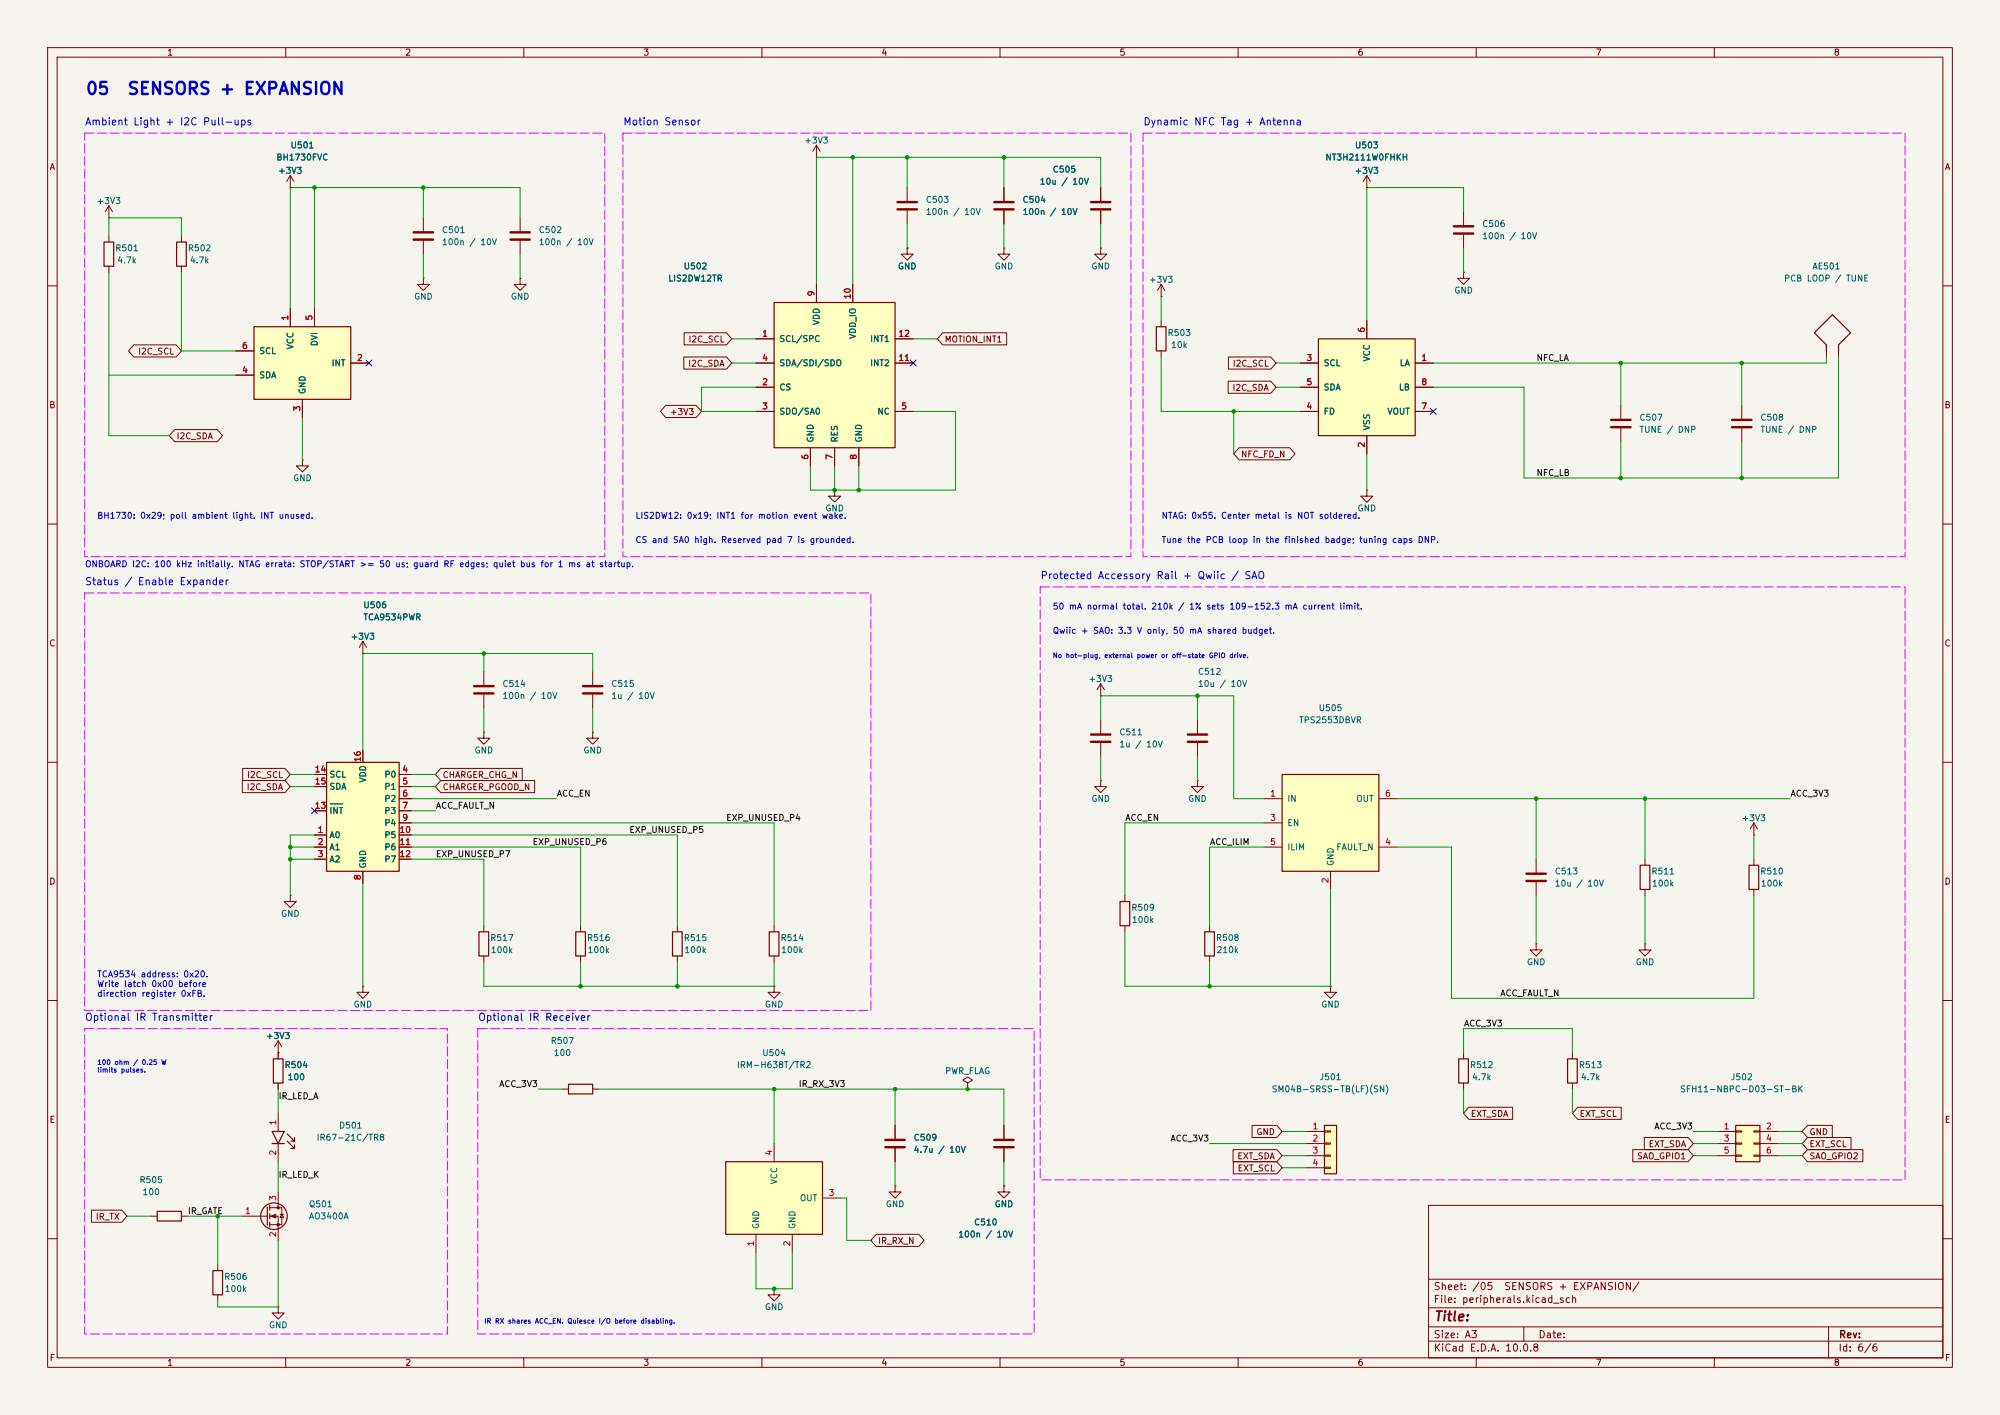
[picture p45: page 6]

Ambient Light + I2C Pull-ups

Dynamic NFC Tag + Antenna

BH1730: 0x29; poll ambient light. INT unused. ONBOARD I2C: 100 kHz initially. NTAG errata: STOP/START >= 50 us; guard RF edges; quiet bus for 1 ms at startup.

LIS2DW12: 0x19; INT1 for motion event wake. CS and SA0 high. Reserved pad 7 is grounded.

Tune the PCB loop in the finished badge; tuning caps DNP. NTAG: 0x55. Center metal is NOT soldered. Qwiic + SAO: 3.3 V only, 50 mA shared budget. 50 mA normal total. 210k / 1% sets 109-152.3 mA current limit. Protected Accessory Rail + Qwiic / SAO

No hot-plug, external power or off-state GPIO drive.

Optional IR Transmitter 100 ohm / 0.25 W

IR RX shares ACC_EN. Quiesce I/O before disabling.
