thebenedict/tinkerbadge-hardware/exports/design-review-2026-11-11/tinkerbadge-schematic.pdf

1 | 2 | 3 | 4 | 5 | 6
1 | 2 | 3 | 4 | 5 | 6

AB

C

D

AB

C

### D Date:

Size: A4 | Rev:
KiCad E.D.A. 10.0.8 | Id: 1/6

## Title:

### File: tinkerbadge.kicad_sch

### Sheet: /

04 LIGHTING + BUTTONS

File: lighting.kicad_sch

01 POWER + CHARGING

File: power.kicad_sch | 03 E-PAPER DISPLAY

File: display.kicad_sch 05 SENSORS + EXPANSION

File: peripherals.kicad_sch

02 PROCESSOR + RECOVERY

File: mcu.kicad_sch

ESP32-S3-WROOM-1-N16R8 Native USB, UART and boot/reset Reviewed GPIO allocation Prototype schematic 0.1 | 2026-11-09

### Source-controlled circuit contracts: docs/design/

Electrical source review precedes each populated block. Three role + five affinity pixels Red / green power indicator Two buttons, RTC wake TINKERBADGE / ELECTRICAL OVERVIEW

USB / dock input selection Power path, protected BAT sensing
Single nominal 3.3 V shared rail | ED037TC1 electrical interface Switched logic and isolated inputs Exact panel boost support

Ambient, motion, dynamic NFC IR transmit / receive Qwiic / SAO and status expander

INITIAL VARIANT Onboard charging is disabled. Two-wire protected LiPo; optional NTC not fitted. See docs/design/implementation_status.md

for physical and prototype release gates. PROTOTYPE RAIL DECISION

Shared 3.3 V supply, including the eight RGB LEDs. Tolerance can fall below the LED specified minimum. Startup / low-battery / Wi-Fi / LED-step tests required.

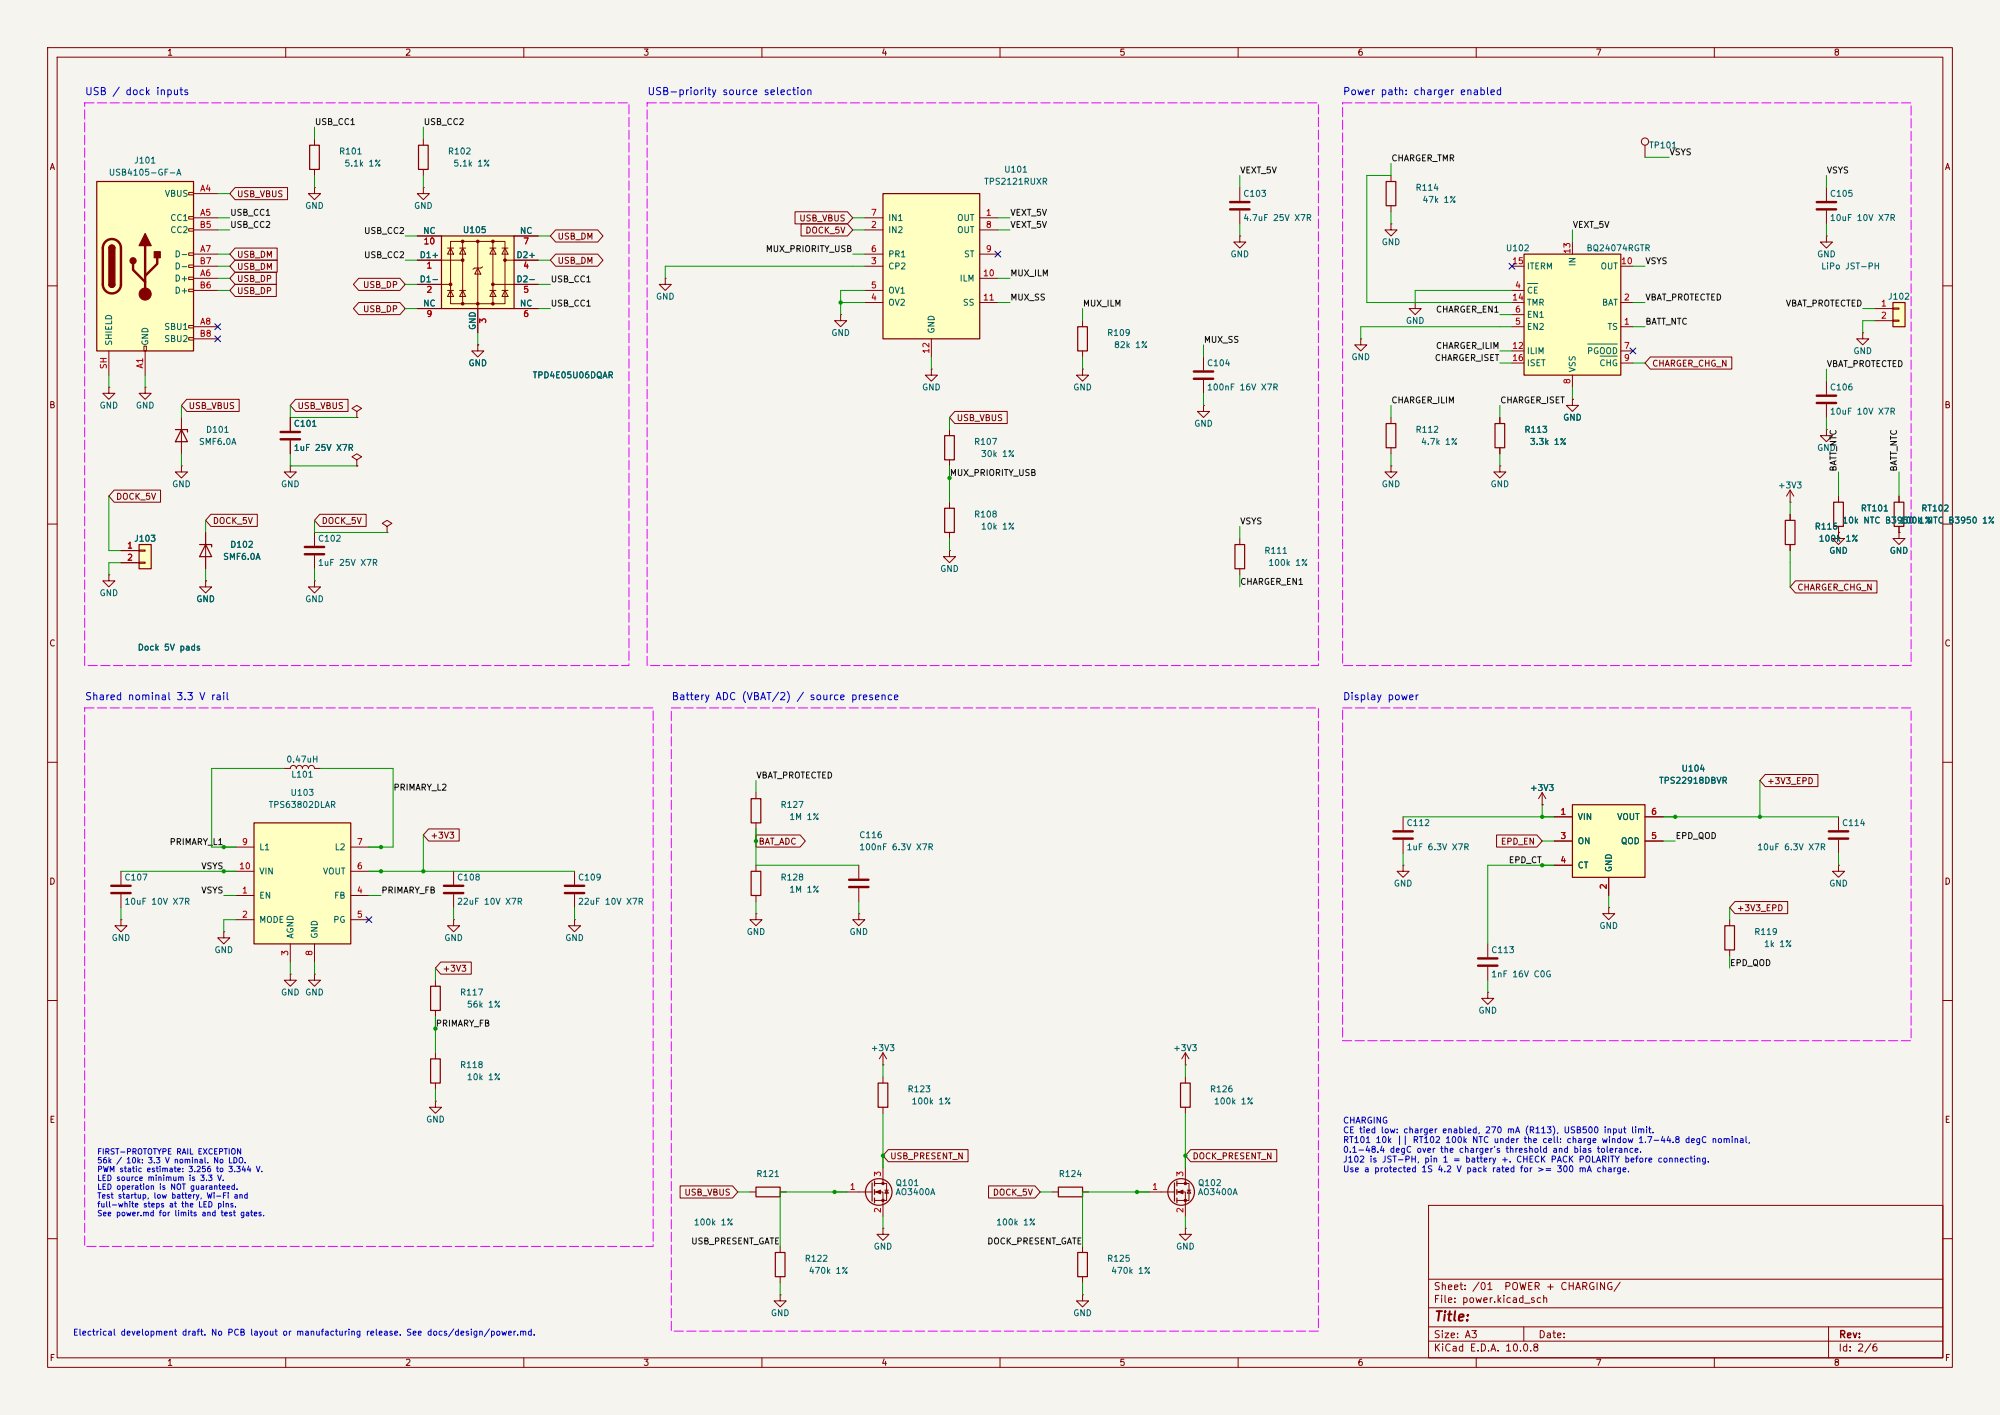
[picture p46: page 2]

USB-priority source selection

BATT_NTC Power path: charger enabled

Battery ADC (VBAT/2) / source presence

CE tied low: charger enabled, 270 mA (R113), USB500 input limit. RT101 10k || RT102 100k NTC under the cell: charge window 1.7-44.8 degC nominal, 0.1-48.4 degC over the charger's threshold and bias tolerance. J102 is JST-PH, pin 1 = battery +. CHECK PACK POLARITY before connecting. Use a protected 1S 4.2 V pack rated for >= 300 mA charge.

Electrical development draft. No PCB layout or manufacturing release. See docs/design/power.md. FIRST-PROTOTYPE RAIL EXCEPTION
56k / 10k: 3.3 V nominal. No LDO. PWM static estimate: 3.256 to 3.344 V. LED source minimum is 3.3 V. LED operation is NOT guaranteed. Test startup, low battery, Wi-Fi and

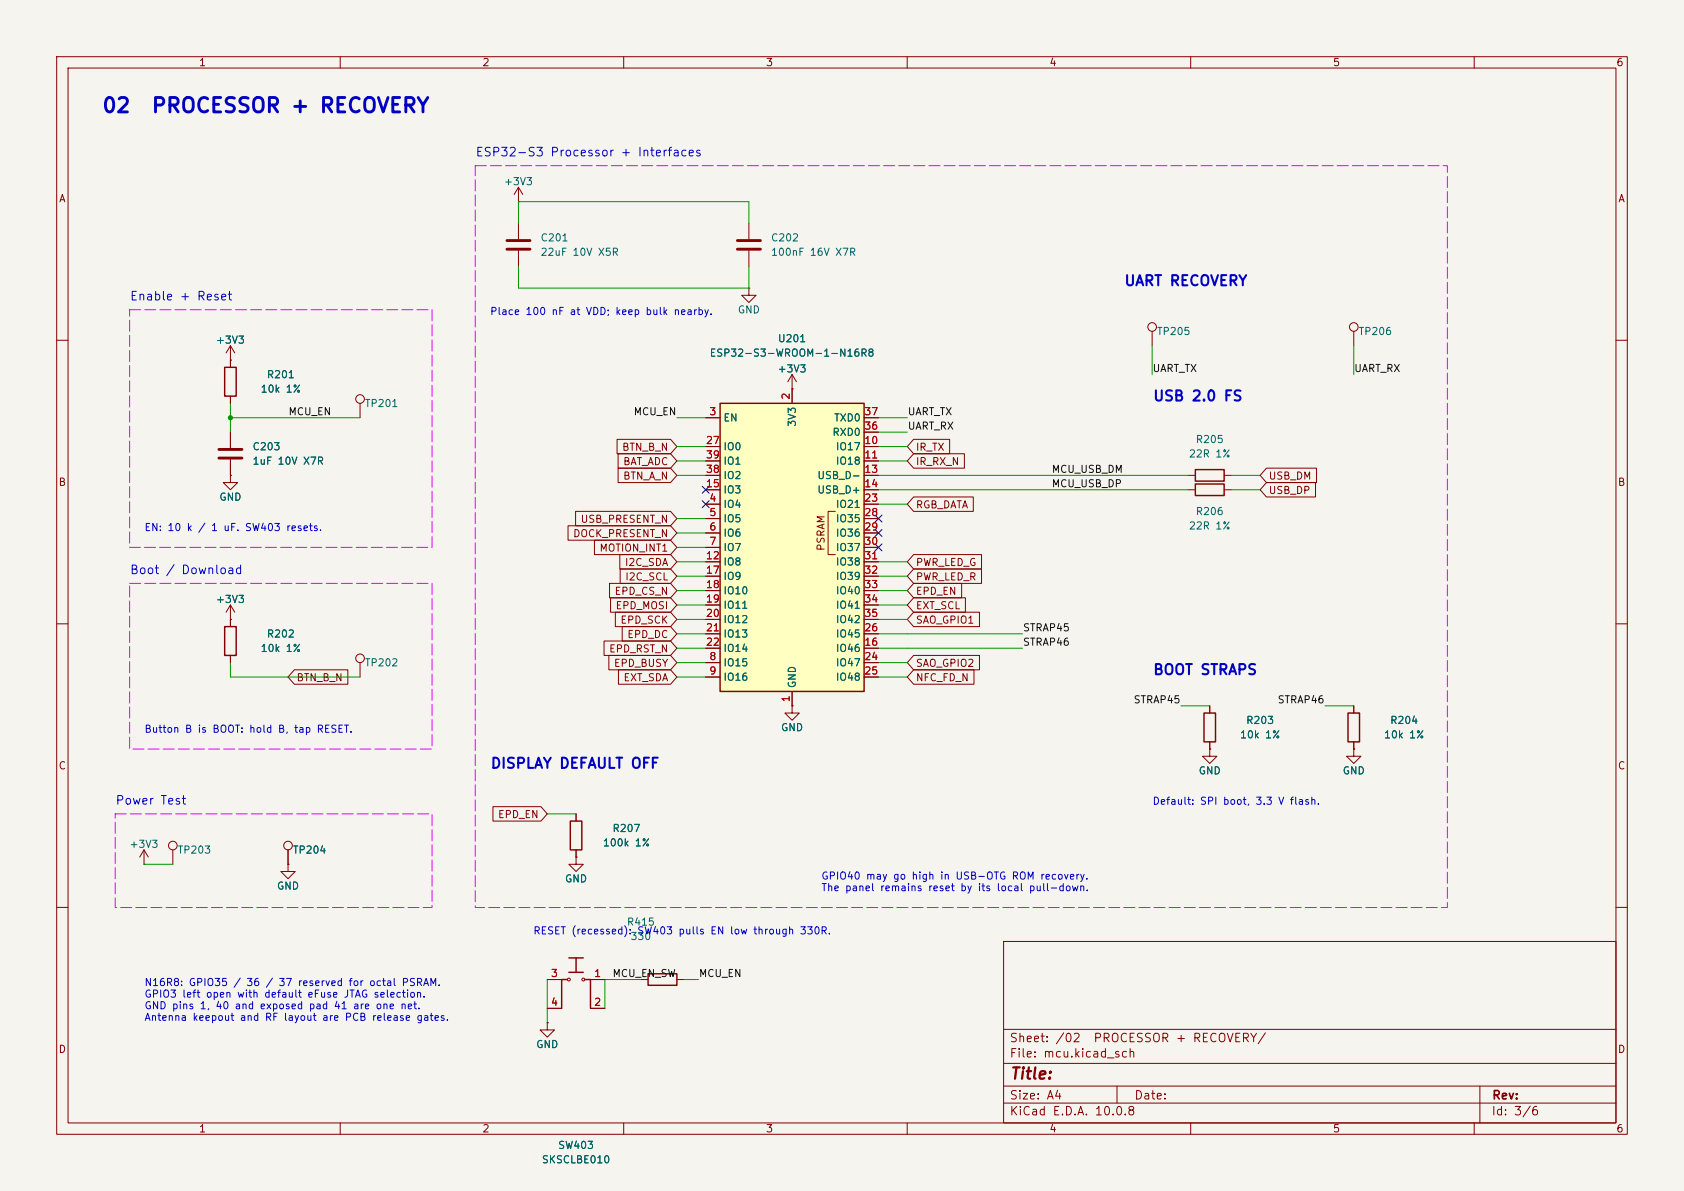
[picture p47: page 3]

Place 100 nF at VDD; keep bulk nearby. RESET (recessed): SW403 pulls EN low through 330R. GPIO40 may go high in USB-OTG ROM recovery. The panel remains reset by its local pull-down.

Power Test N16R8: GPIO35 / 36 / 37 reserved for octal PSRAM. GPIO3 left open with default eFuse JTAG selection. GND pins 1, 40 and exposed pad 41 are one net. Antenna keepout and RF layout are PCB release gates. GND

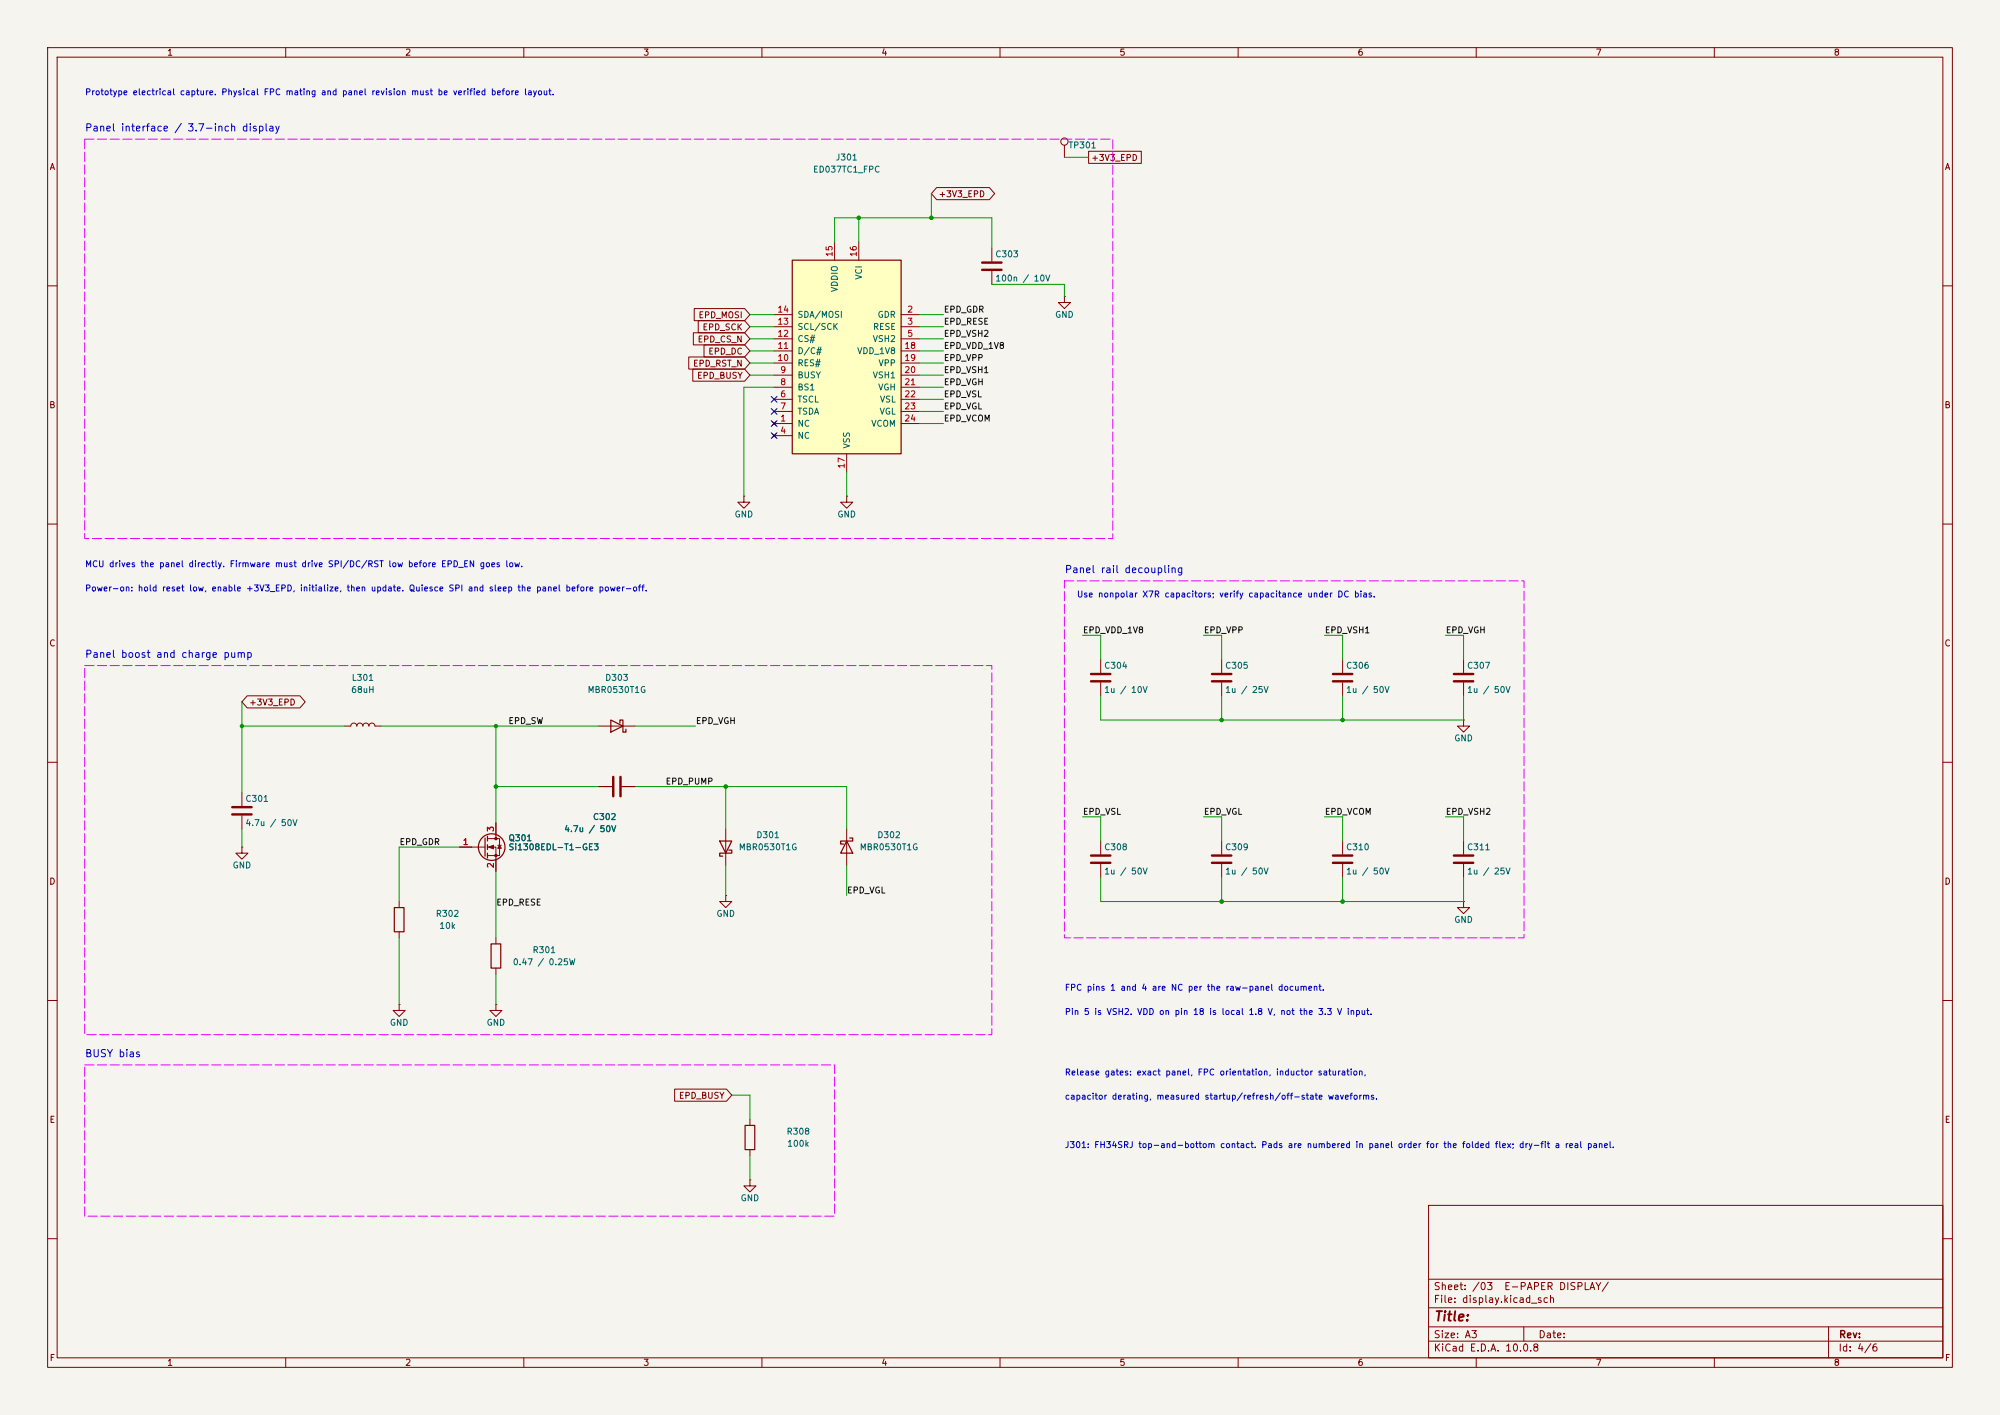
[picture p48: page 4]

Prototype electrical capture. Physical FPC mating and panel revision must be verified before layout.

Use nonpolar X7R capacitors; verify capacitance under DC bias. MCU drives the panel directly. Firmware must drive SPI/DC/RST low before EPD_EN goes low. Panel interface / 3.7-inch display

EPD_VGL EPD_VSL EPD_VSH1 Panel boost and charge pump

FPC pins 1 and 4 are NC per the raw-panel document. Panel rail decoupling

Power-on: hold reset low, enable +3V3_EPD, initialize, then update. Quiesce SPI and sleep the panel before power-off.

capacitor derating, measured startup/refresh/off-state waveforms. Pin 5 is VSH2. VDD on pin 18 is local 1.8 V, not the 3.3 V input. Release gates: exact panel, FPC orientation, inductor saturation, J301: FH34SRJ top-and-bottom contact. Pads are numbered in panel order for the folded flex; dry-fit a real panel.

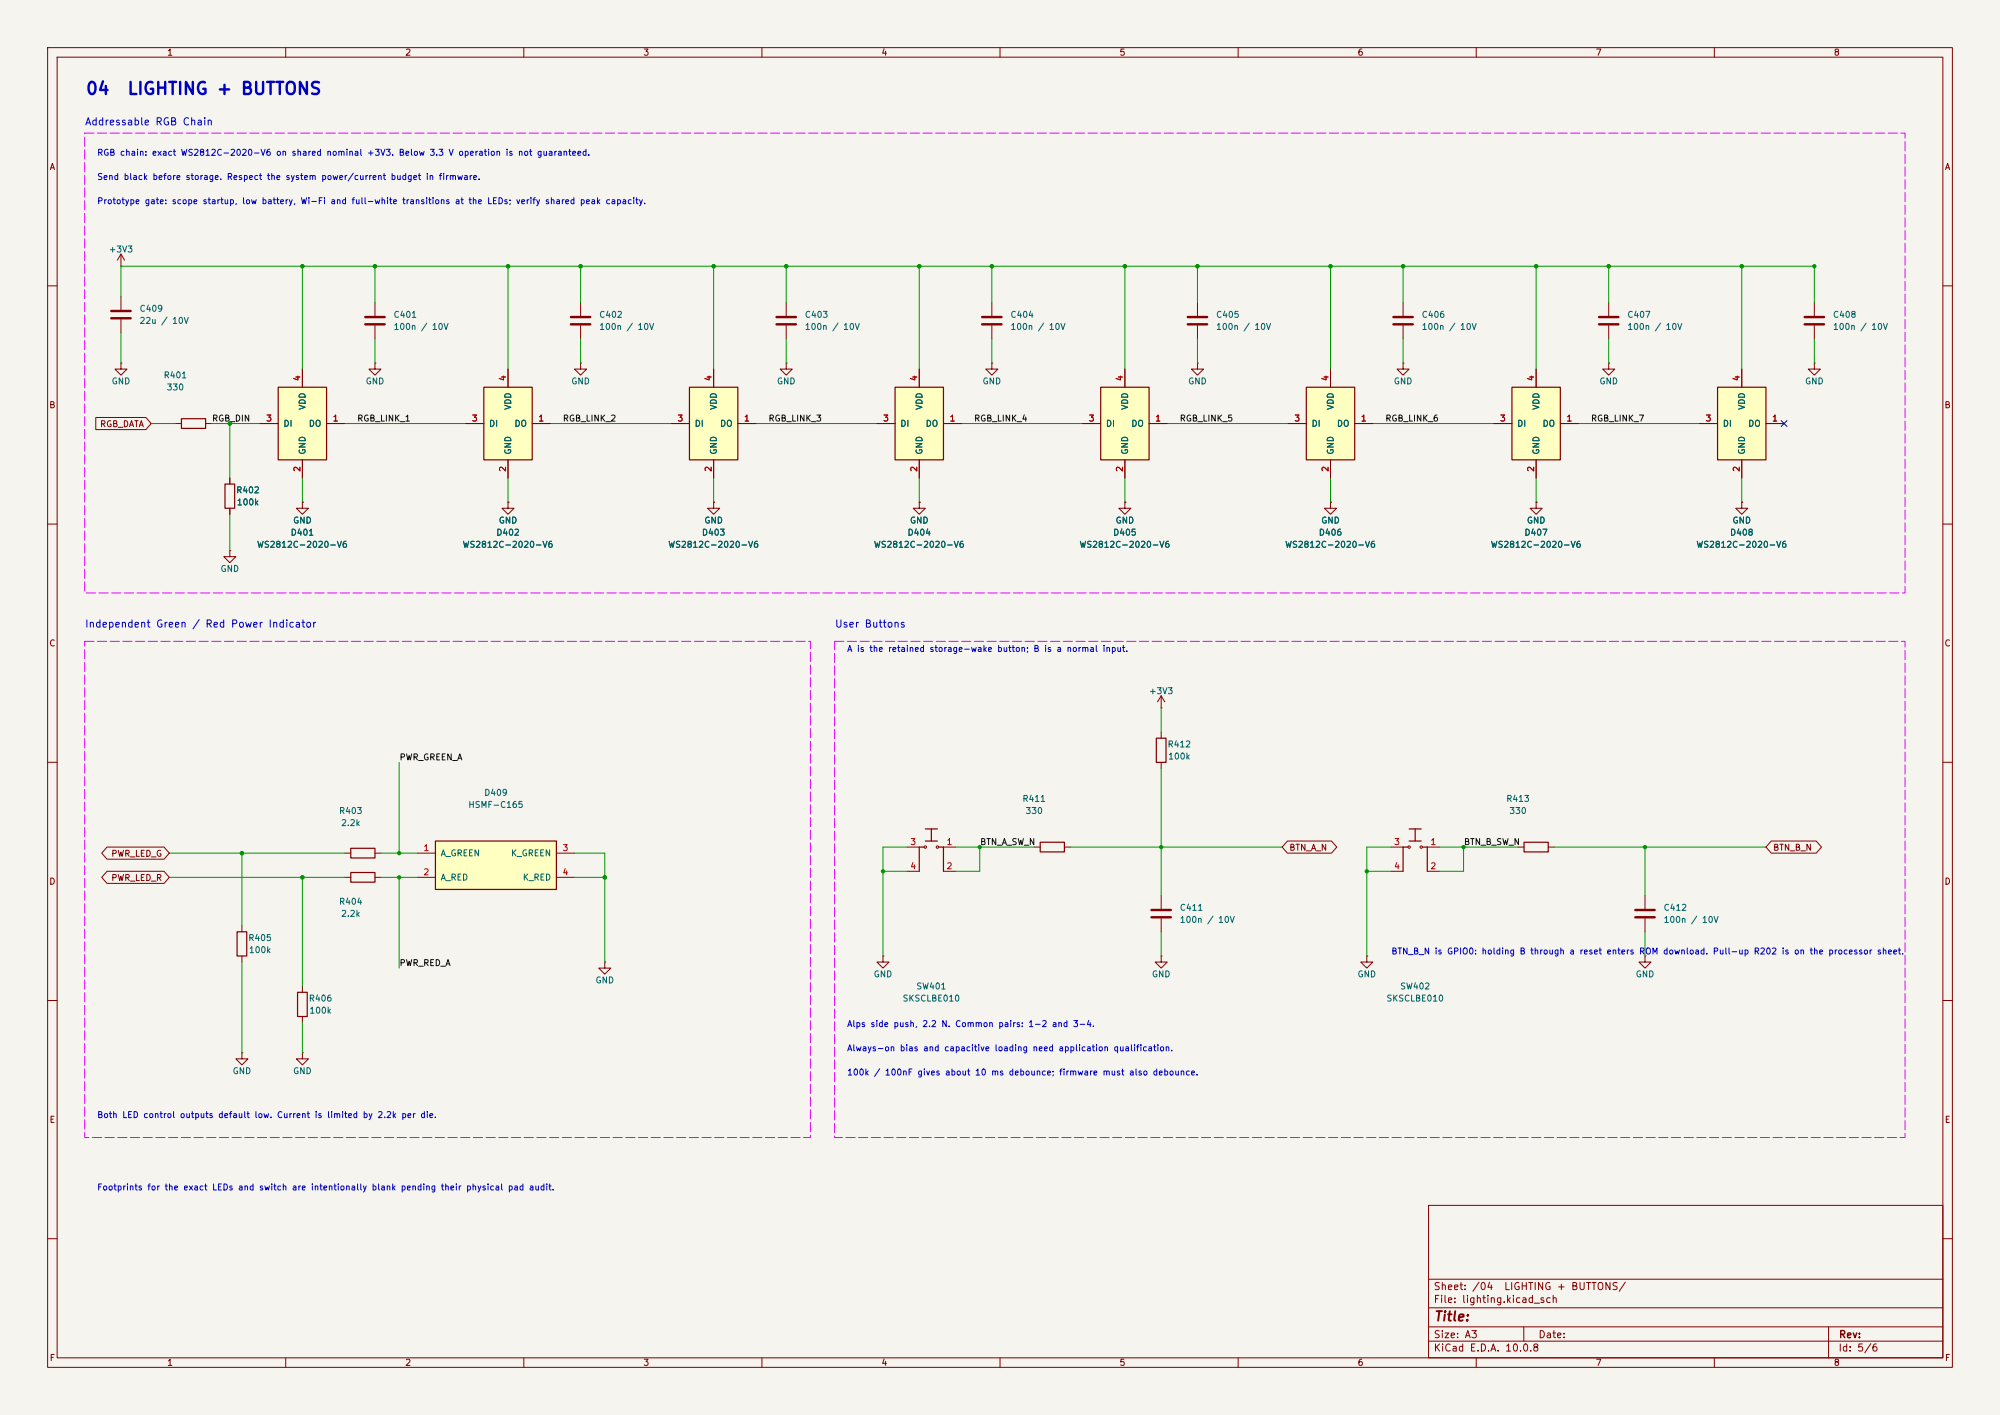
[picture p49: page 5]

Prototype gate: scope startup, low battery, Wi-Fi and full-white transitions at the LEDs; verify shared peak capacity.

Independent Green / Red Power Indicator

A is the retained storage-wake button; B is a normal input.

Alps side push, 2.2 N. Common pairs: 1-2 and 3-4.

Footprints for the exact LEDs and switch are intentionally blank pending their physical pad audit. Both LED control outputs default low. Current is limited by 2.2k per die.

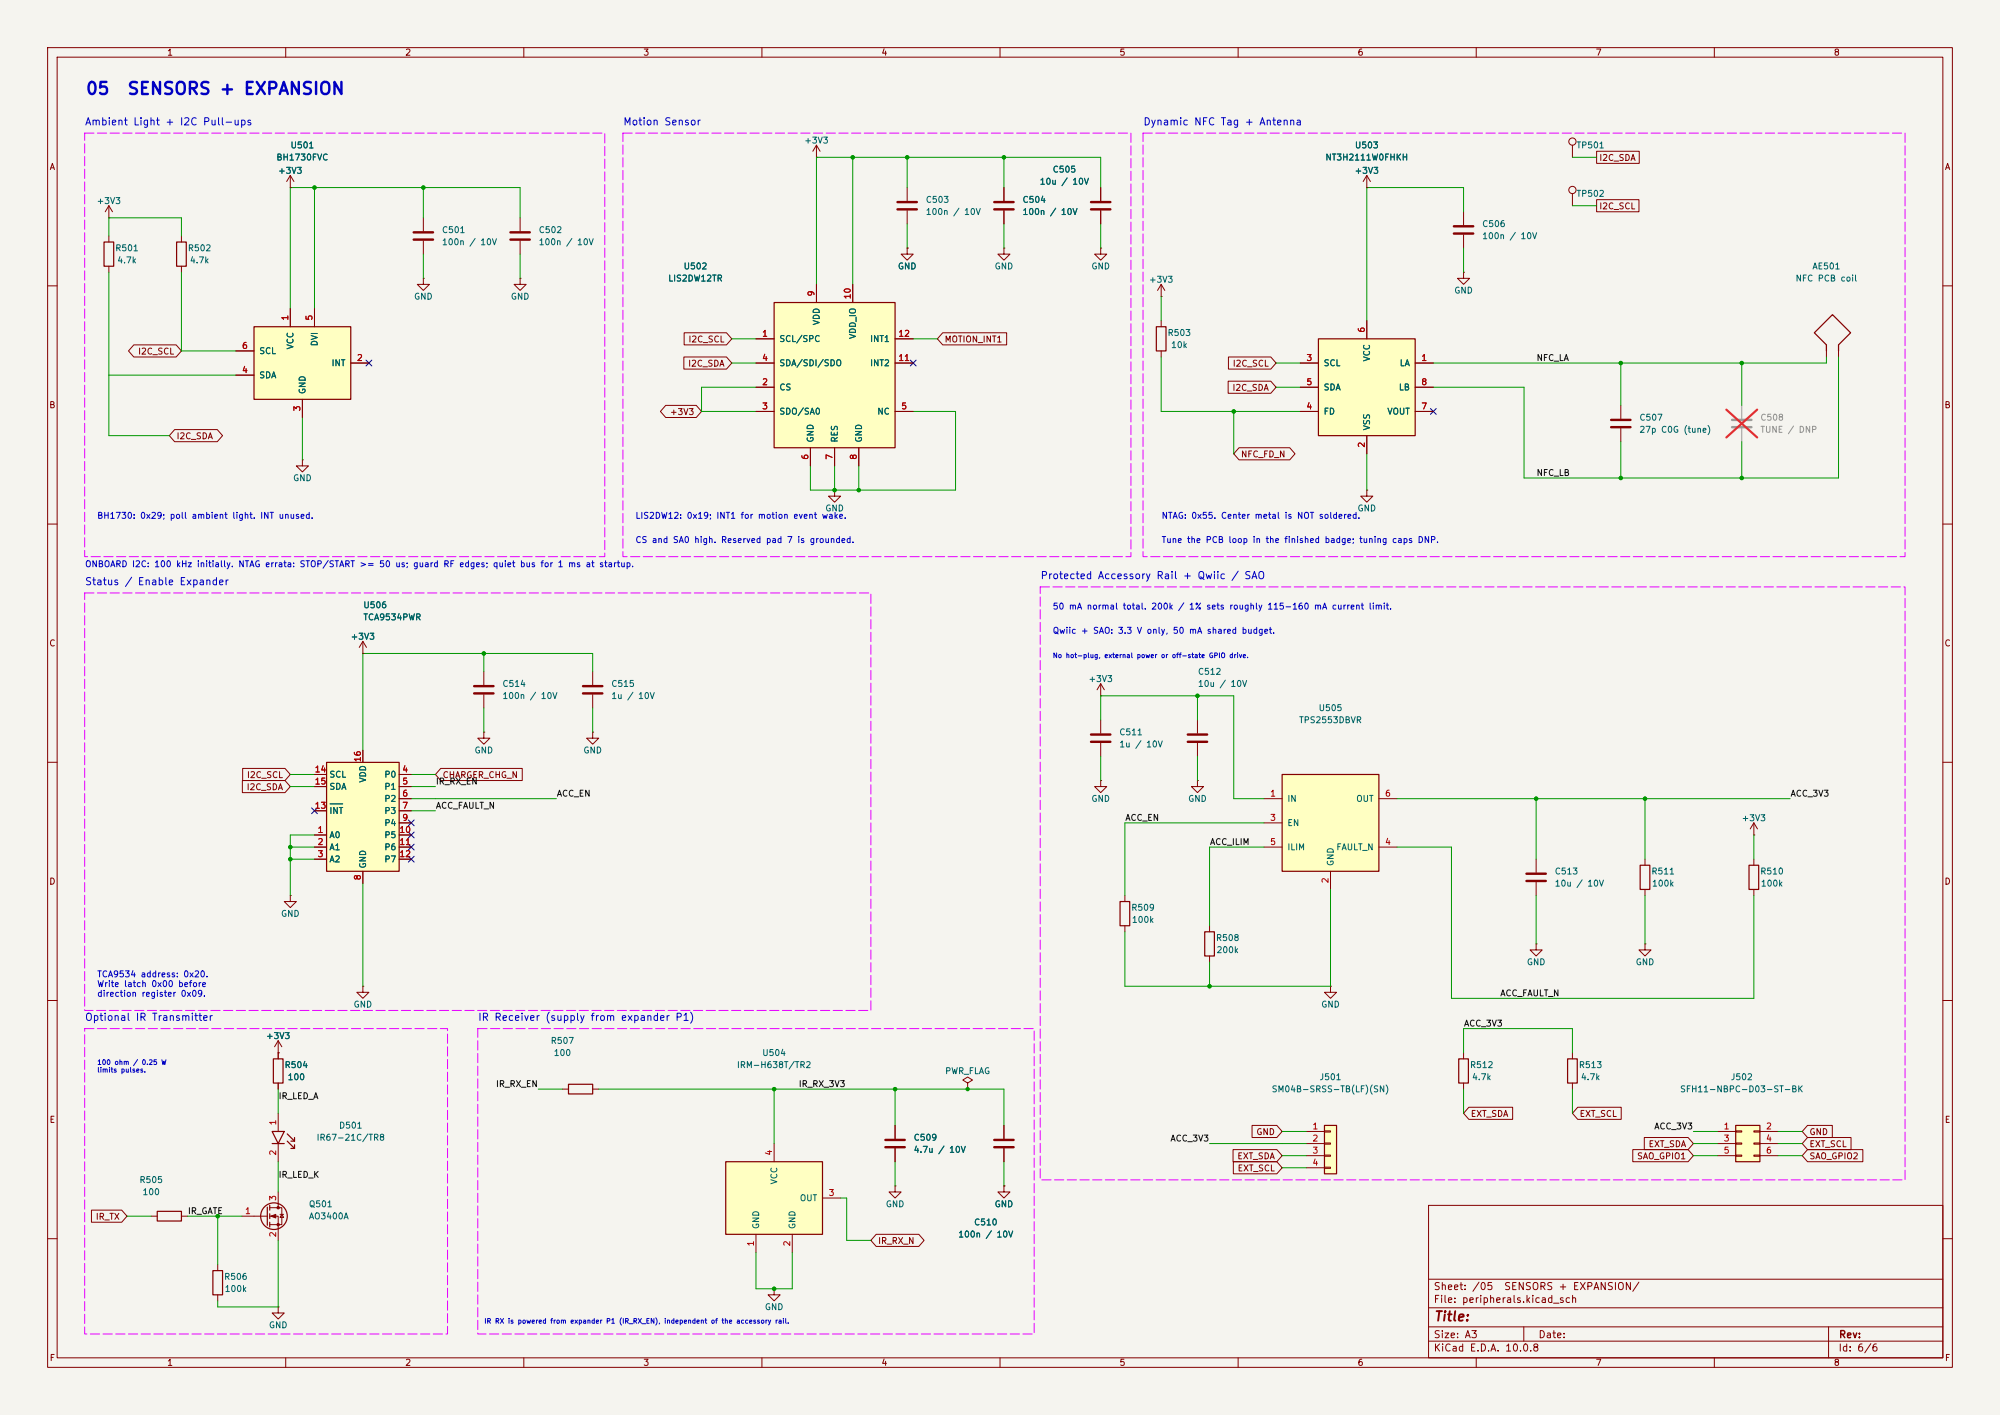
[picture p50: page 6]

Ambient Light + I2C Pull-ups

Dynamic NFC Tag + Antenna

LIS2DW12: 0x19; INT1 for motion event wake. CS and SA0 high. Reserved pad 7 is grounded.

Protected Accessory Rail + Qwiic / SAO

Qwiic + SAO: 3.3 V only, 50 mA shared budget.

No hot-plug, external power or off-state GPIO drive.

IR Receiver (supply from expander P1)

IR RX is powered from expander P1 (IR_RX_EN), independent of the accessory rail.
