thebenedict/tinkerbadge-hardware/exports/design-review-2026-11-10/tinkerbadge-schematic.pdf

1 | 2 | 3 | 4 | 5 | 6
1 | 2 | 3 | 4 | 5 | 6

AB

C

D

AB

C

### D Date:

Size: A4 | Rev:
KiCad E.D.A. 10.0.8 | Id: 1/6

## Title:

### File: tinkerbadge.kicad_sch

### Sheet: /

04 LIGHTING + BUTTONS

File: lighting.kicad_sch

01 POWER + CHARGING

File: power.kicad_sch | 03 E-PAPER DISPLAY

File: display.kicad_sch 05 SENSORS + EXPANSION

File: peripherals.kicad_sch

02 PROCESSOR + RECOVERY

File: mcu.kicad_sch

ESP32-S3-WROOM-1-N16R8 Native USB, UART and boot/reset Reviewed GPIO allocation Prototype schematic 0.1 | 2026-11-09

### Source-controlled circuit contracts: docs/design/

Electrical source review precedes each populated block. Three role + five affinity pixels Red / green power indicator Two buttons, RTC wake TINKERBADGE / ELECTRICAL OVERVIEW

USB / dock input selection Power path, protected BAT sensing
Single nominal 3.3 V shared rail | ED037TC1 electrical interface Switched logic and isolated inputs Exact panel boost support

Ambient, motion, dynamic NFC IR transmit / receive Qwiic / SAO and status expander

INITIAL VARIANT Onboard charging is disabled. Two-wire protected LiPo; optional NTC not fitted. See docs/design/implementation_status.md

for physical and prototype release gates. PROTOTYPE RAIL DECISION

Shared 3.3 V supply, including the eight RGB LEDs. Tolerance can fall below the LED specified minimum. Startup / low-battery / Wi-Fi / LED-step tests required.

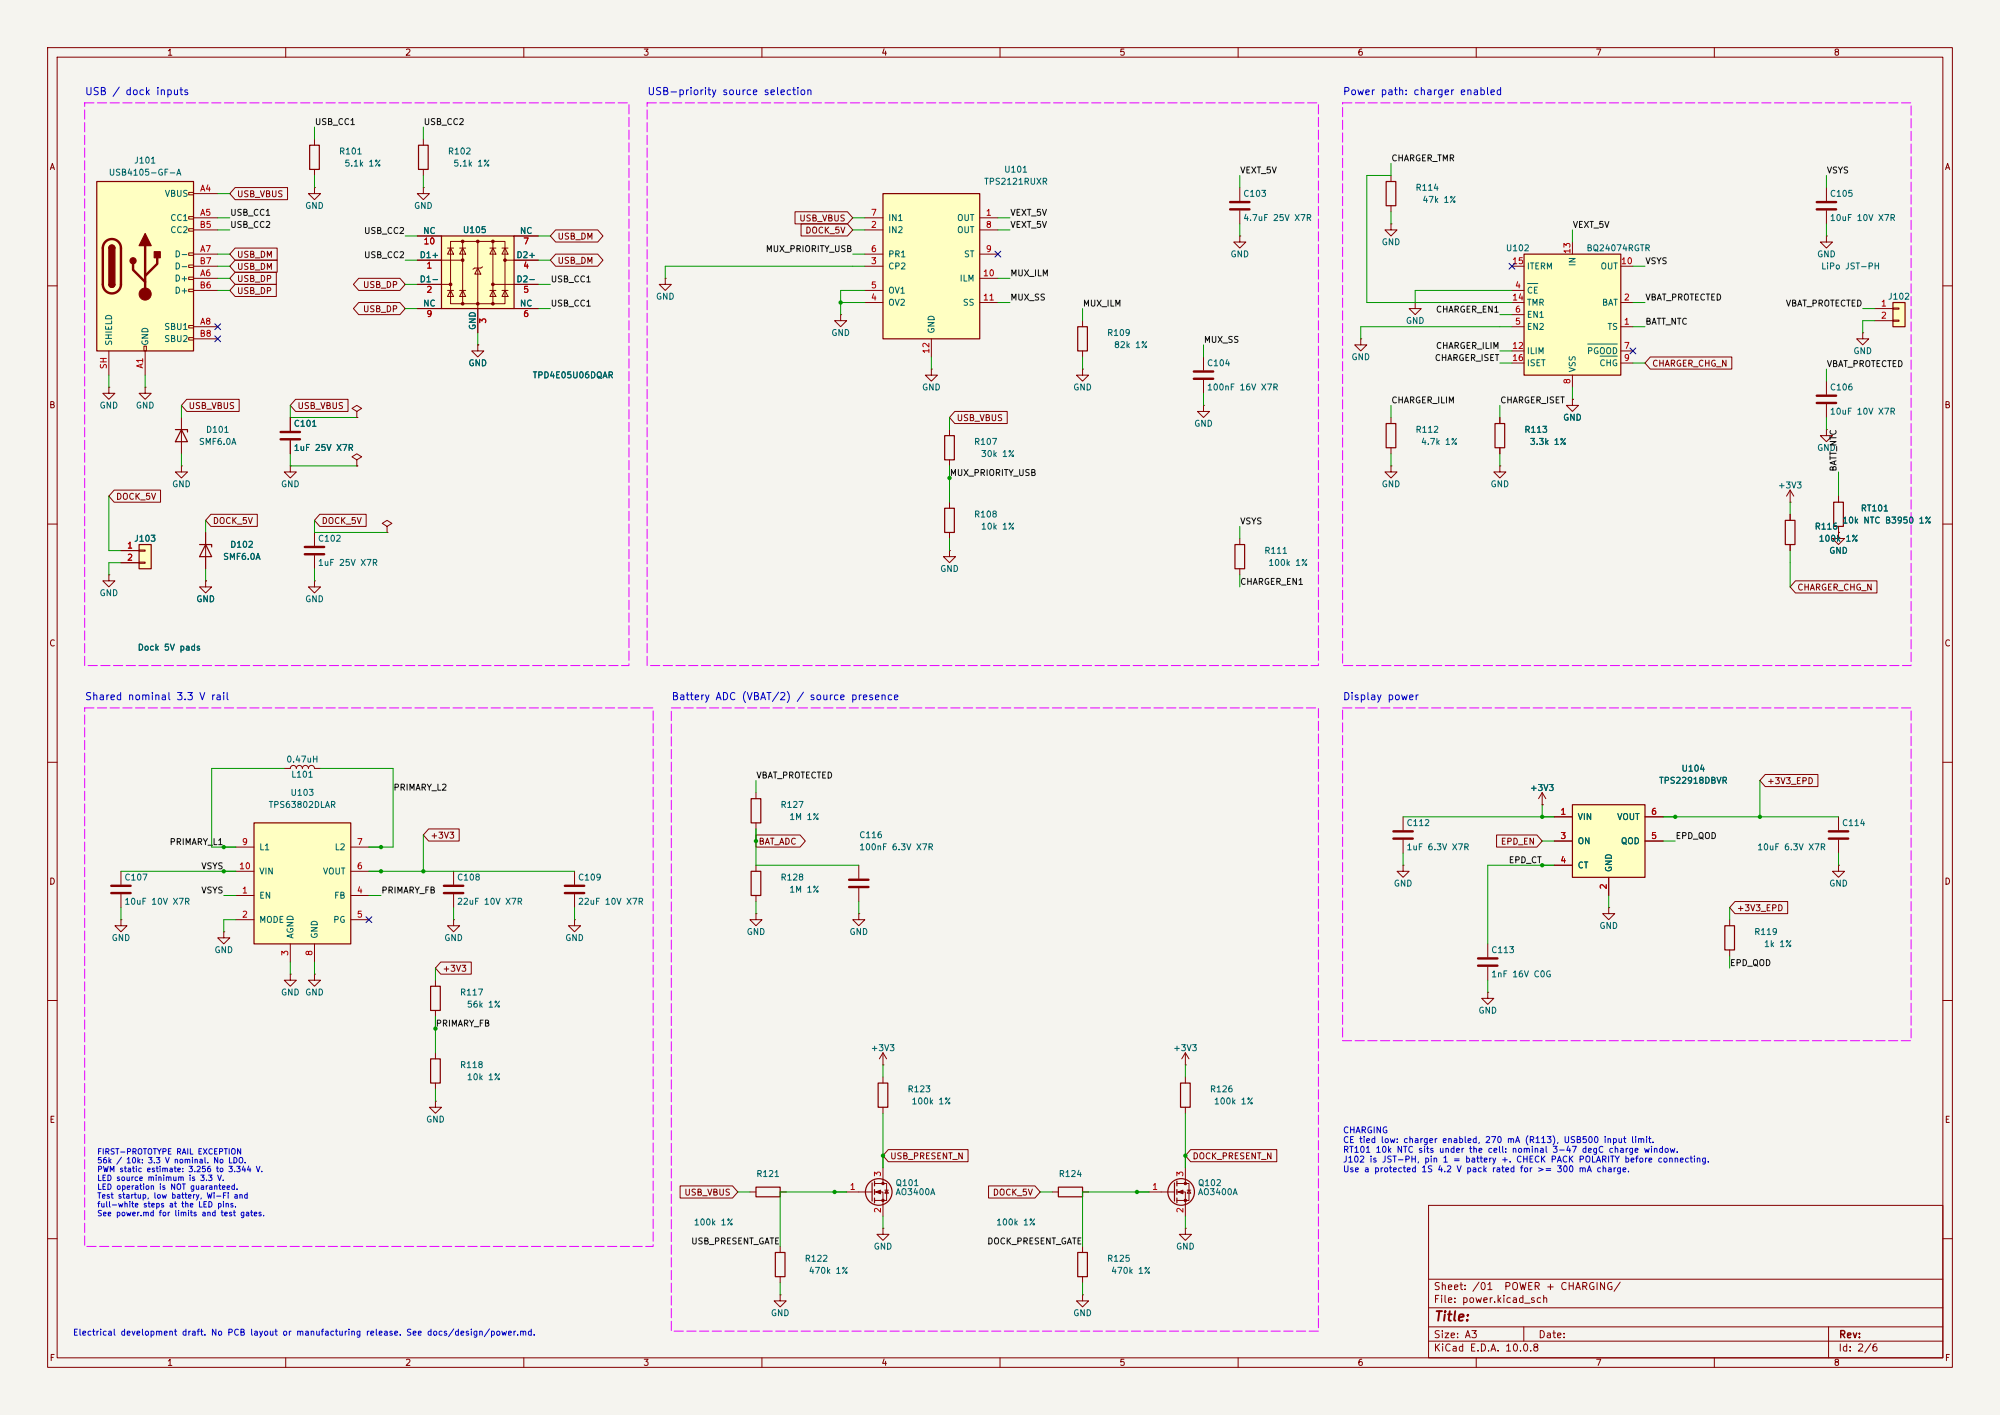
[picture p51: page 2]

USB-priority source selection

Battery ADC (VBAT/2) / source presence

CE tied low: charger enabled, 270 mA (R113), USB500 input limit. RT101 10k NTC sits under the cell: nominal 3-47 degC charge window. J102 is JST-PH, pin 1 = battery +. CHECK PACK POLARITY before connecting. Use a protected 1S 4.2 V pack rated for >= 300 mA charge. Electrical development draft. No PCB layout or manufacturing release. See docs/design/power.md. FIRST-PROTOTYPE RAIL EXCEPTION

56k / 10k: 3.3 V nominal. No LDO. PWM static estimate: 3.256 to 3.344 V. LED source minimum is 3.3 V. LED operation is NOT guaranteed. Test startup, low battery, Wi-Fi and

full-white steps at the LED pins. See power.md for limits and test gates.


Enable + Reset EN: 10 k / 1 uF. Pull low to reset. Boot / Download

Place 100 nF at VDD; keep bulk nearby.

Default: SPI boot, 3.3 V flash. GND

STRAP46 N16R8: GPIO35 / 36 / 37 reserved for octal PSRAM. GPIO3 left open with default eFuse JTAG selection. GND pins 1, 40 and exposed pad 41 are one net. Antenna keepout and RF layout are PCB release gates.

GPIO40 may go high in USB-OTG ROM recovery. The panel remains reset by its local pull-down.

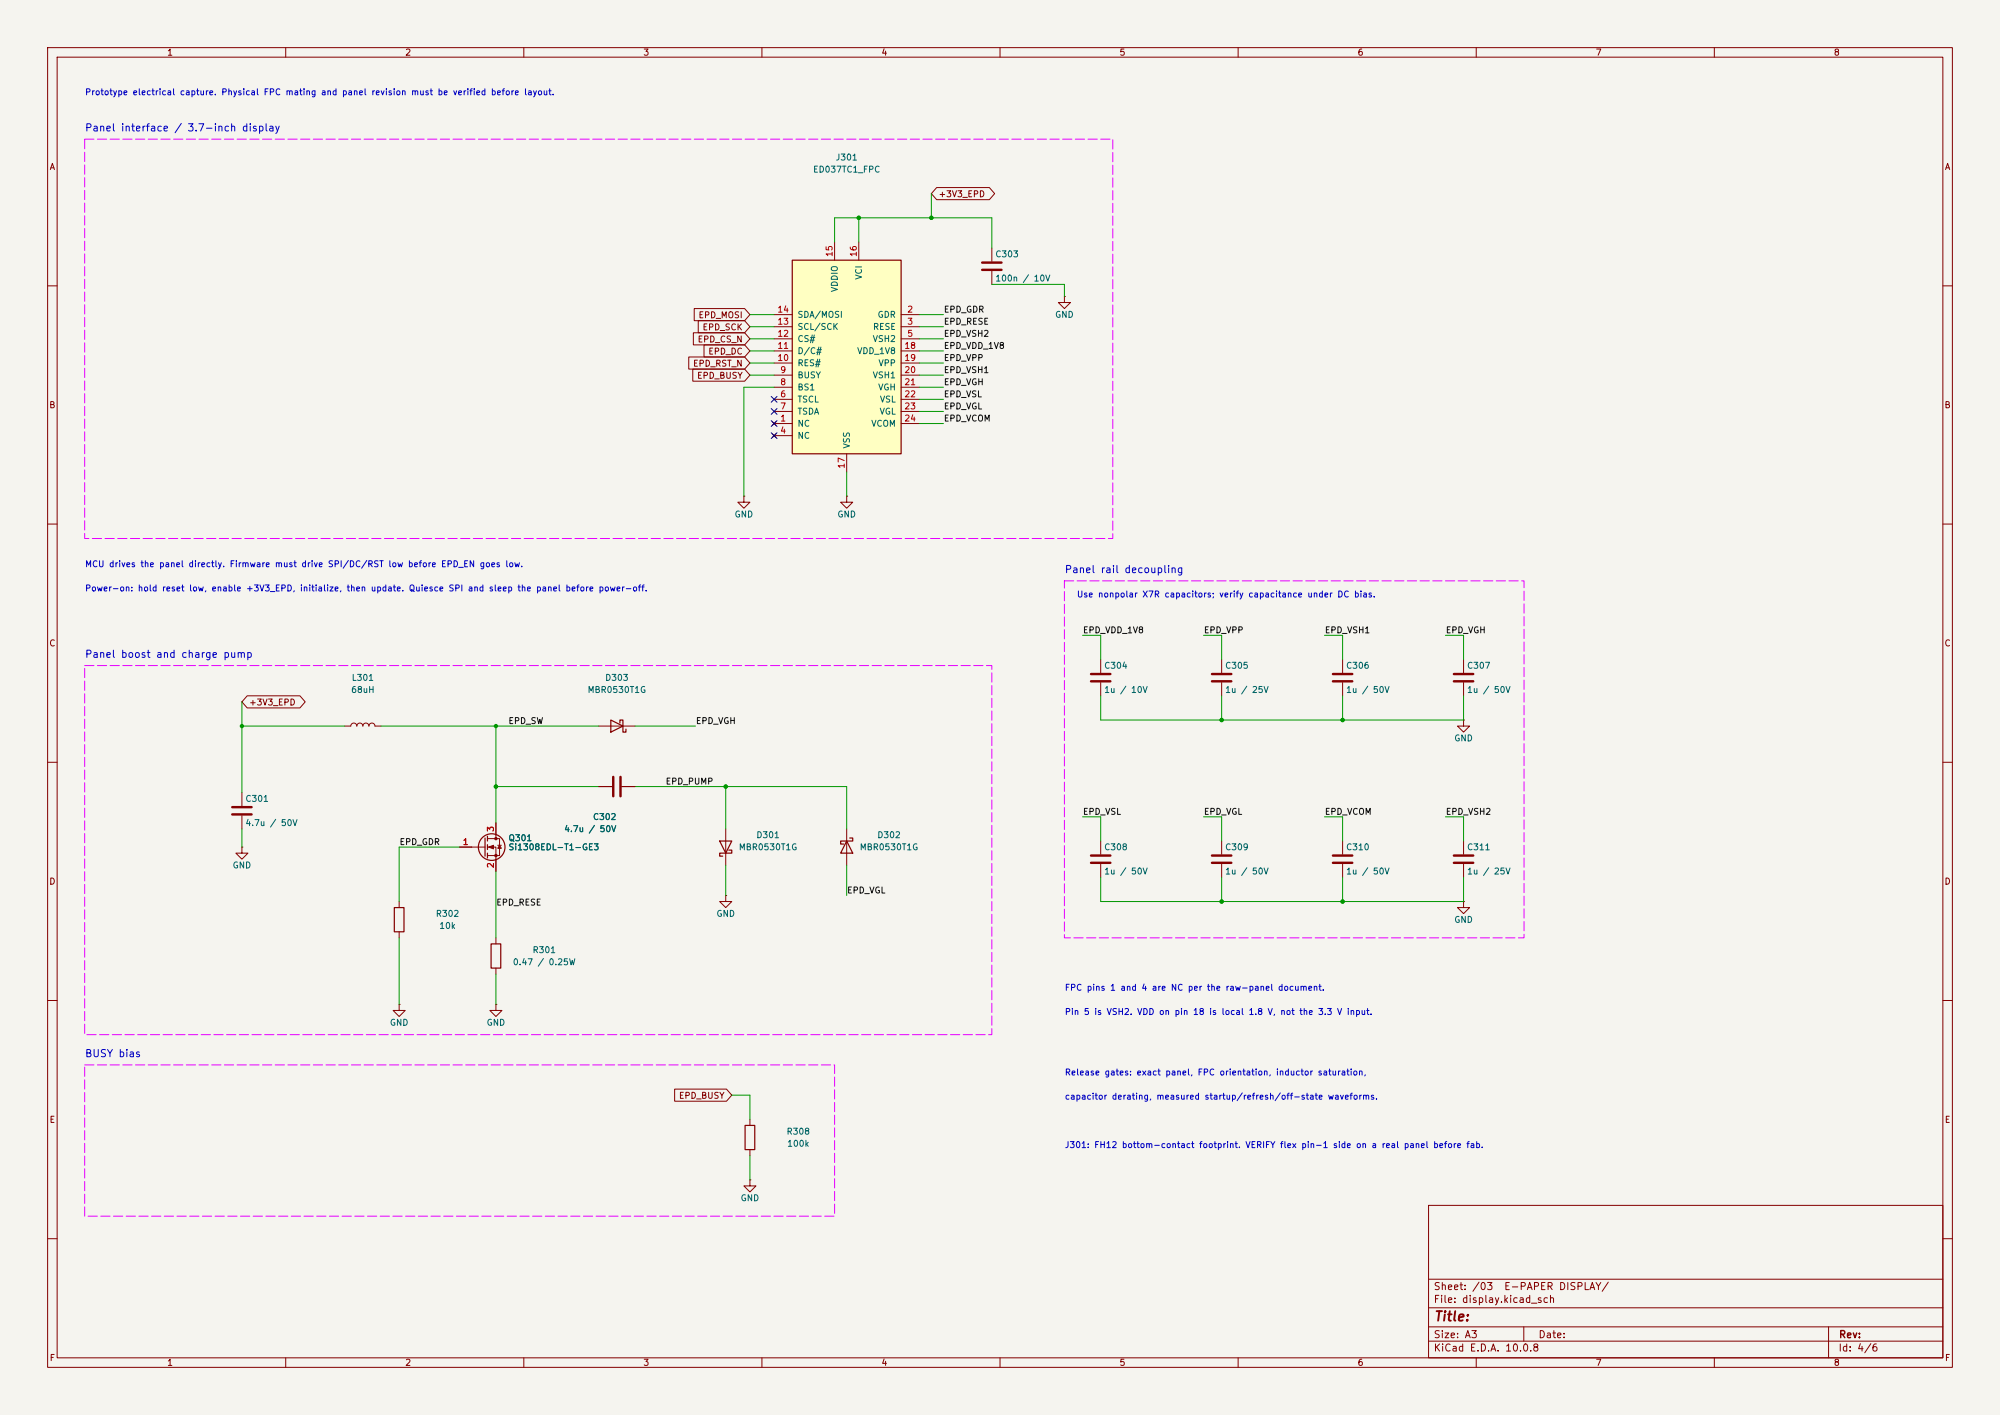
[picture p52: page 4]

Prototype electrical capture. Physical FPC mating and panel revision must be verified before layout. MCU drives the panel directly. Firmware must drive SPI/DC/RST low before EPD_EN goes low. Power-on: hold reset low, enable +3V3_EPD, initialize, then update. Quiesce SPI and sleep the panel before power-off.

Panel boost and charge pump

J301: FH12 bottom-contact footprint. VERIFY flex pin-1 side on a real panel before fab. capacitor derating, measured startup/refresh/off-state waveforms. Release gates: exact panel, FPC orientation, inductor saturation, FPC pins 1 and 4 are NC per the raw-panel document. Pin 5 is VSH2. VDD on pin 18 is local 1.8 V, not the 3.3 V input. C302


Send black before storage. Respect the system power/current budget in firmware. RGB chain: exact WS2812C-2020-V6 on shared nominal +3V3. Below 3.3 V operation is not guaranteed.

Prototype gate: scope startup, low battery, Wi-Fi and full-white transitions at the LEDs; verify shared peak capacity.

Always-on bias and capacitive loading need application qualification.

Footprints for the exact LEDs and switch are intentionally blank pending their physical pad audit.

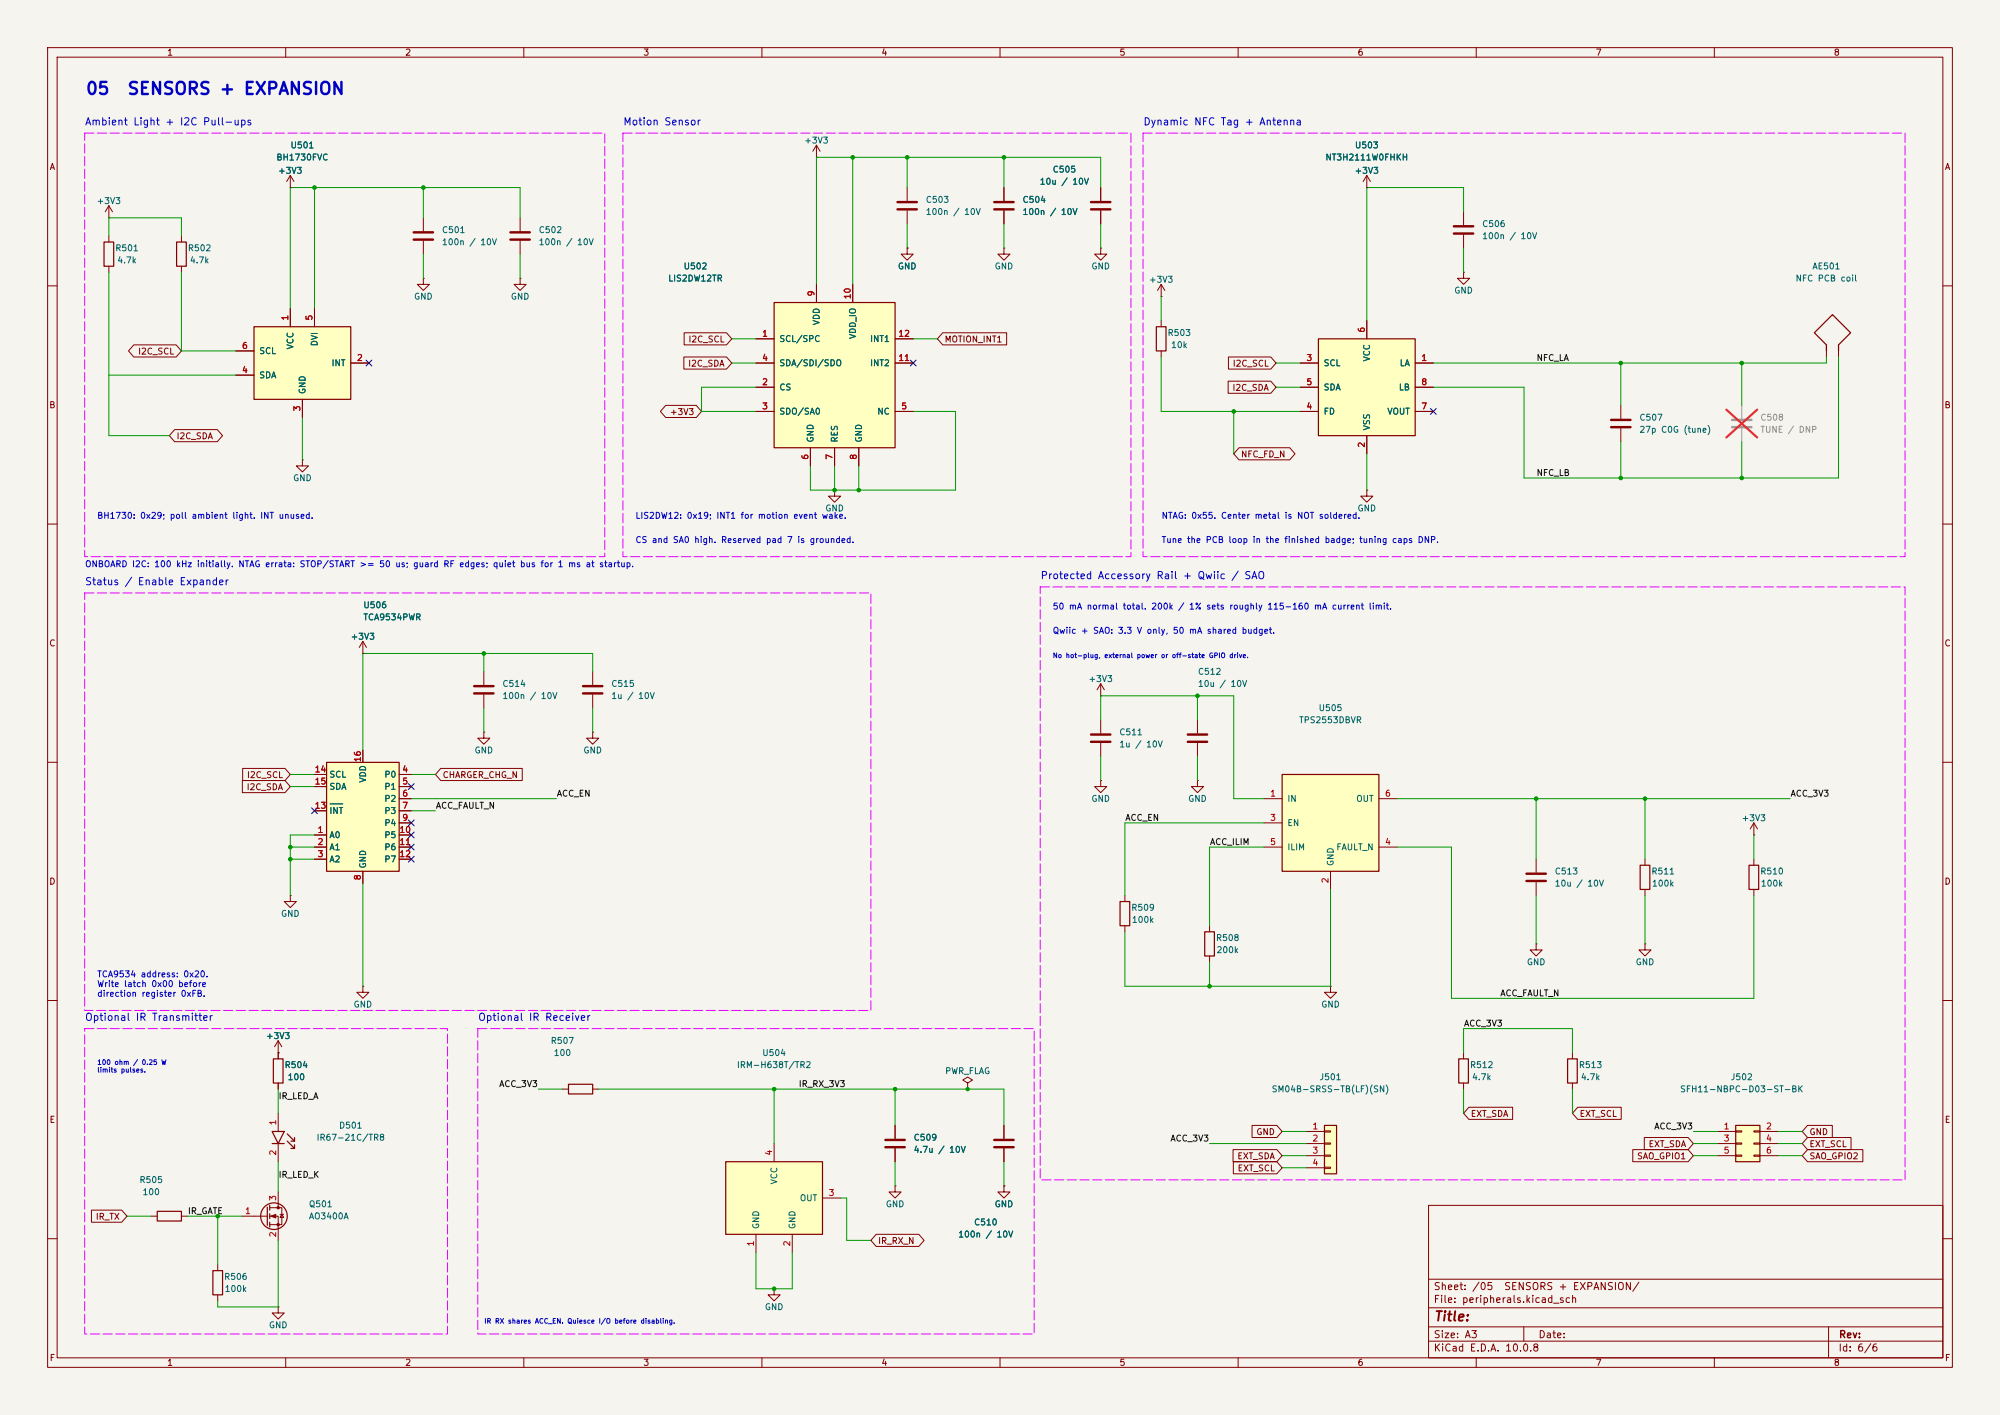
[picture p53: page 6]

No hot-plug, external power or off-state GPIO drive. Tune the PCB loop in the finished badge; tuning caps DNP. Optional IR Receiver TCA9534 address: 0x20. Write latch 0x00 before direction register 0xFB. Status / Enable Expander ONBOARD I2C: 100 kHz initially. NTAG errata: STOP/START >= 50 us; guard RF edges; quiet bus for 1 ms at startup. BH1730: 0x29; poll ambient light. INT unused. Ambient Light + I2C Pull-ups

Motion Sensor LIS2DW12: 0x19; INT1 for motion event wake. +3V3U506

Dynamic NFC Tag + Antenna
GND +3V3 GND

Qwiic + SAO: 3.3 V only, 50 mA shared budget. NTAG: 0x55. Center metal is NOT soldered. Optional IR Transmitter 100 ohm / 0.25 W

IR RX shares ACC_EN. Quiesce I/O before disabling.
