thebenedict/tinkerbadge-hardware/docs/design/history/2026-11-09-before-outlined-blocks/exports/tinkerbadge-schematic.pdf

1 | 2 | 3 | 4 | 5 | 6
1 | 2 | 3 | 4 | 5 | 6

AB

C

D

AB

C

### D Date:

Size: A4 | Rev:
KiCad E.D.A. 10.0.8 | Id: 1/6

## Title:

### File: tinkerbadge.kicad_sch

### Sheet: /

02 PROCESSOR + RECOVERY

File: mcu.kicad_sch | 03 E-PAPER DISPLAY

File: display.kicad_sch 05 SENSORS + EXPANSION

File: peripherals.kicad_sch

01 POWER + CHARGING

File: power.kicad_sch 04 LIGHTING + BUTTONS

File: lighting.kicad_sch

ED037TC1 electrical interface Switched logic and isolated inputs Exact panel boost support

Ambient, motion, dynamic NFC IR transmit / receive Qwiic / SAO and status expander

INITIAL VARIANT Onboard charging is disabled. Two-wire protected LiPo; optional NTC not fitted. See docs/design/implementation_status.md

for physical and prototype release gates. PROTOTYPE RAIL DECISION

Shared 3.3 V supply, including the eight RGB LEDs. Tolerance can fall below the LED specified minimum. Startup / low-battery / Wi-Fi / LED-step tests required.

# TINKERBADGE / ELECTRICAL OVERVIEW

### Prototype schematic 0.1 | 2026-11-09 Source-controlled circuit contracts: docs/design/

Electrical source review precedes each populated block. | ESP32-S3-WROOM-1-N16R8 Native USB, UART and boot/reset Reviewed GPIO allocation

Three role + five affinity pixels Red / green power indicator Two buttons, RTC wake USB / dock input selection Power path, protected BAT sensing

Single nominal 3.3 V shared rail

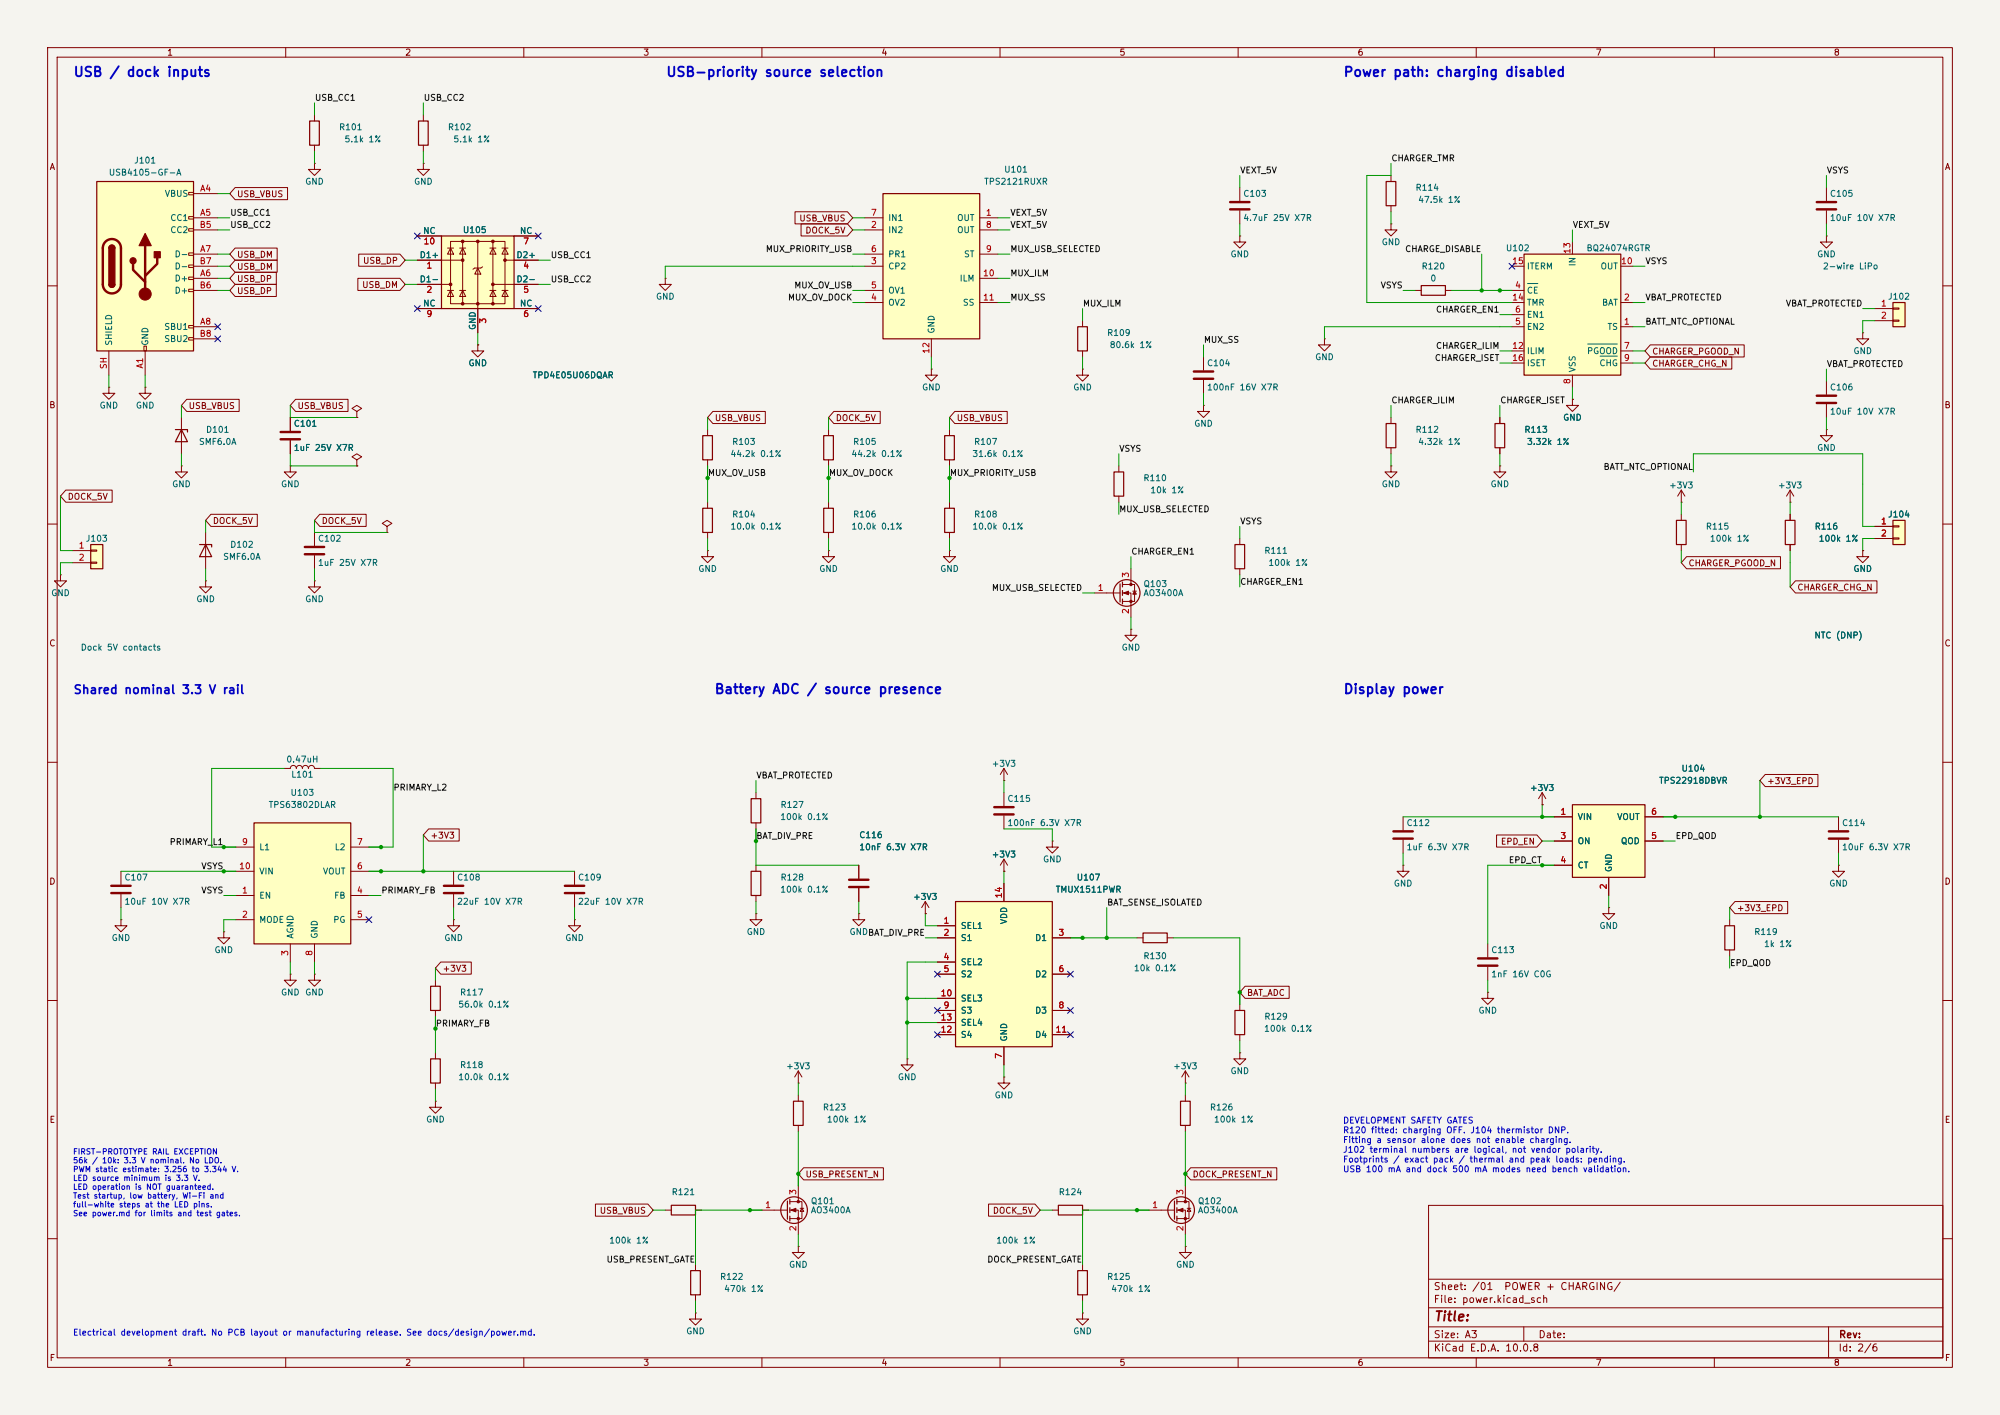
[picture p54: page 2]

USB-priority source selection

Power path: charging disabled

MUX_OV_DOCK MUX_OV_DOCK Battery ADC / source presence

GND
Shared nominal 3.3 V rail FIRST-PROTOTYPE RAIL EXCEPTION

DEVELOPMENT SAFETY GATES R120 fitted: charging OFF. J104 thermistor DNP. Fitting a sensor alone does not enable charging. J102 terminal numbers are logical, not vendor polarity.

56k / 10k: 3.3 V nominal. No LDO. PWM static estimate: 3.256 to 3.344 V. LED source minimum is 3.3 V. LED operation is NOT guaranteed. Test startup, low battery, Wi-Fi and

Footprints / exact pack / thermal and peak loads: pending. USB 100 mA and dock 500 mA modes need bench validation.

full-white steps at the LED pins. See power.md for limits and test gates. Electrical development draft. No PCB layout or manufacturing release. See docs/design/power.md.

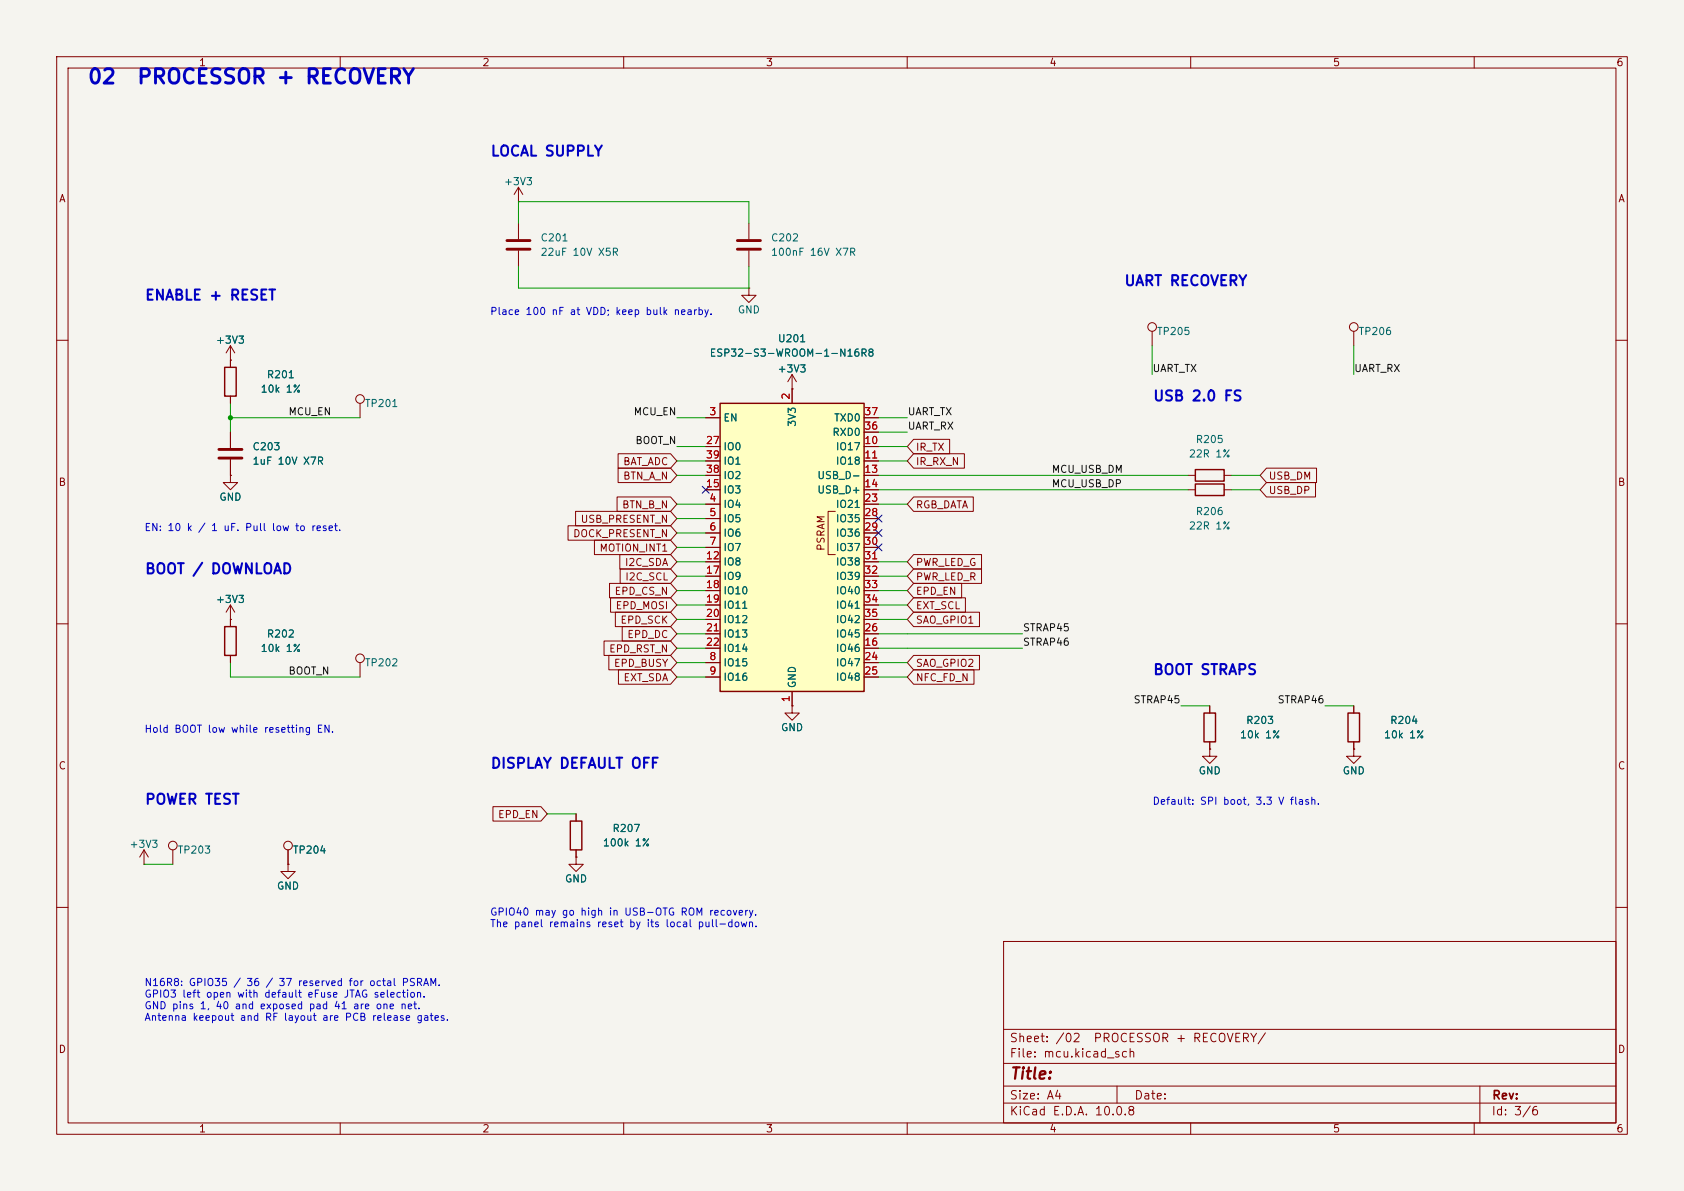
[picture p55: page 3]

Default: SPI boot, 3.3 V flash. Place 100 nF at VDD; keep bulk nearby.

N16R8: GPIO35 / 36 / 37 reserved for octal PSRAM. GPIO3 left open with default eFuse JTAG selection. GND pins 1, 40 and exposed pad 41 are one net. Antenna keepout and RF layout are PCB release gates.

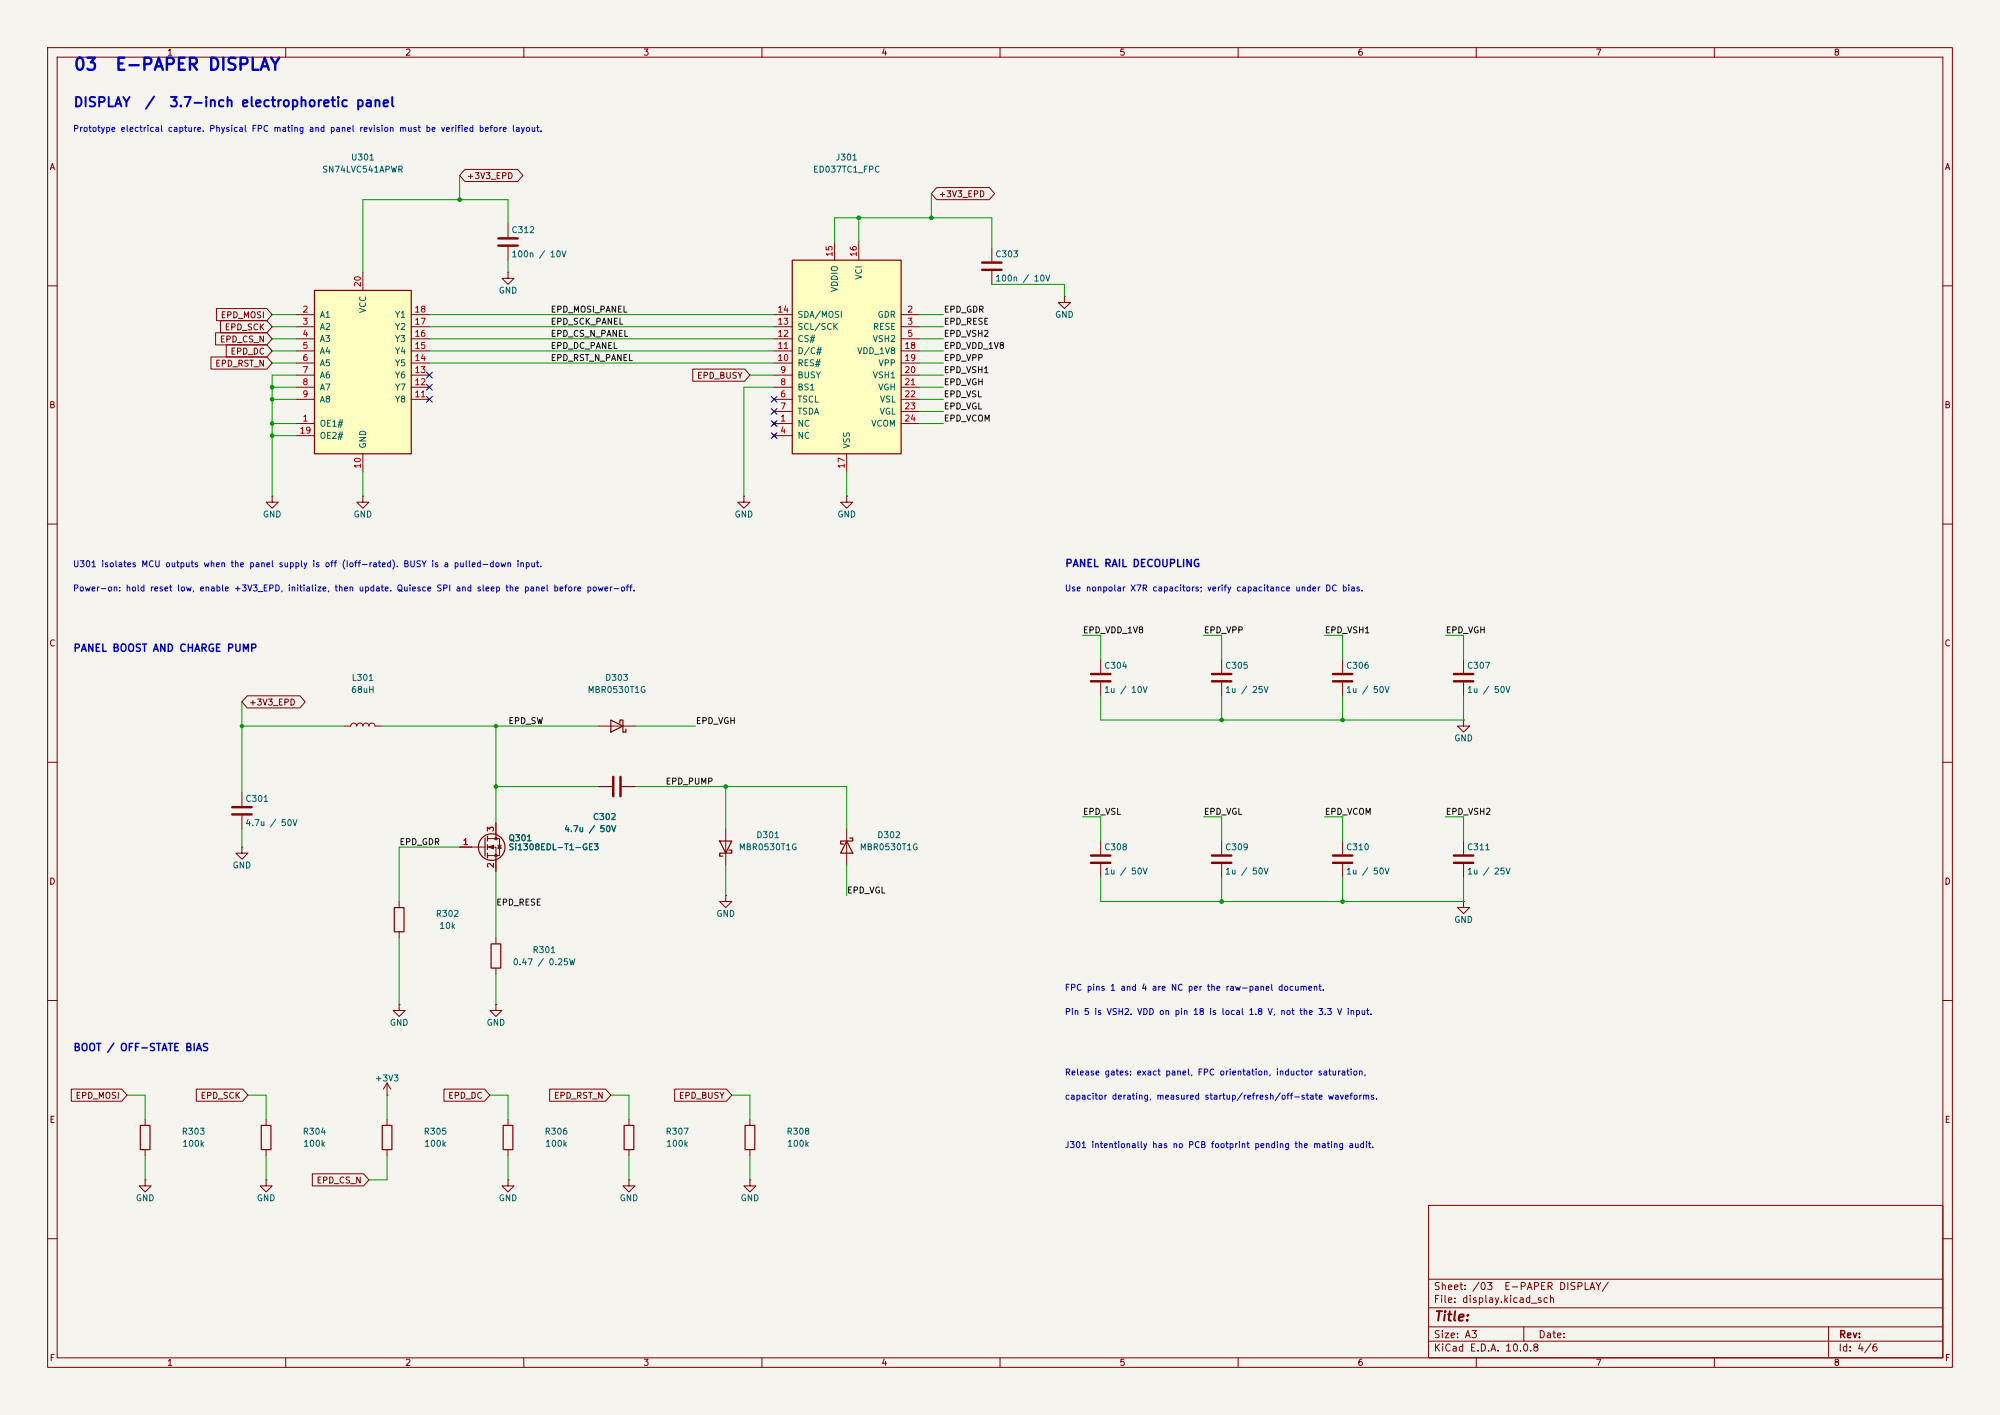
[picture p56: page 4]

DISPLAY / 3.7-inch electrophoretic panel

Prototype electrical capture. Physical FPC mating and panel revision must be verified before layout. Power-on: hold reset low, enable +3V3_EPD, initialize, then update. Quiesce SPI and sleep the panel before power-off.

Use nonpolar X7R capacitors; verify capacitance under DC bias.

PANEL BOOST AND CHARGE PUMP

J301 intentionally has no PCB footprint pending the mating audit. capacitor derating, measured startup/refresh/off-state waveforms. Release gates: exact panel, FPC orientation, inductor saturation, Pin 5 is VSH2. VDD on pin 18 is local 1.8 V, not the 3.3 V input. FPC pins 1 and 4 are NC per the raw-panel document. BOOT / OFF-STATE BIAS

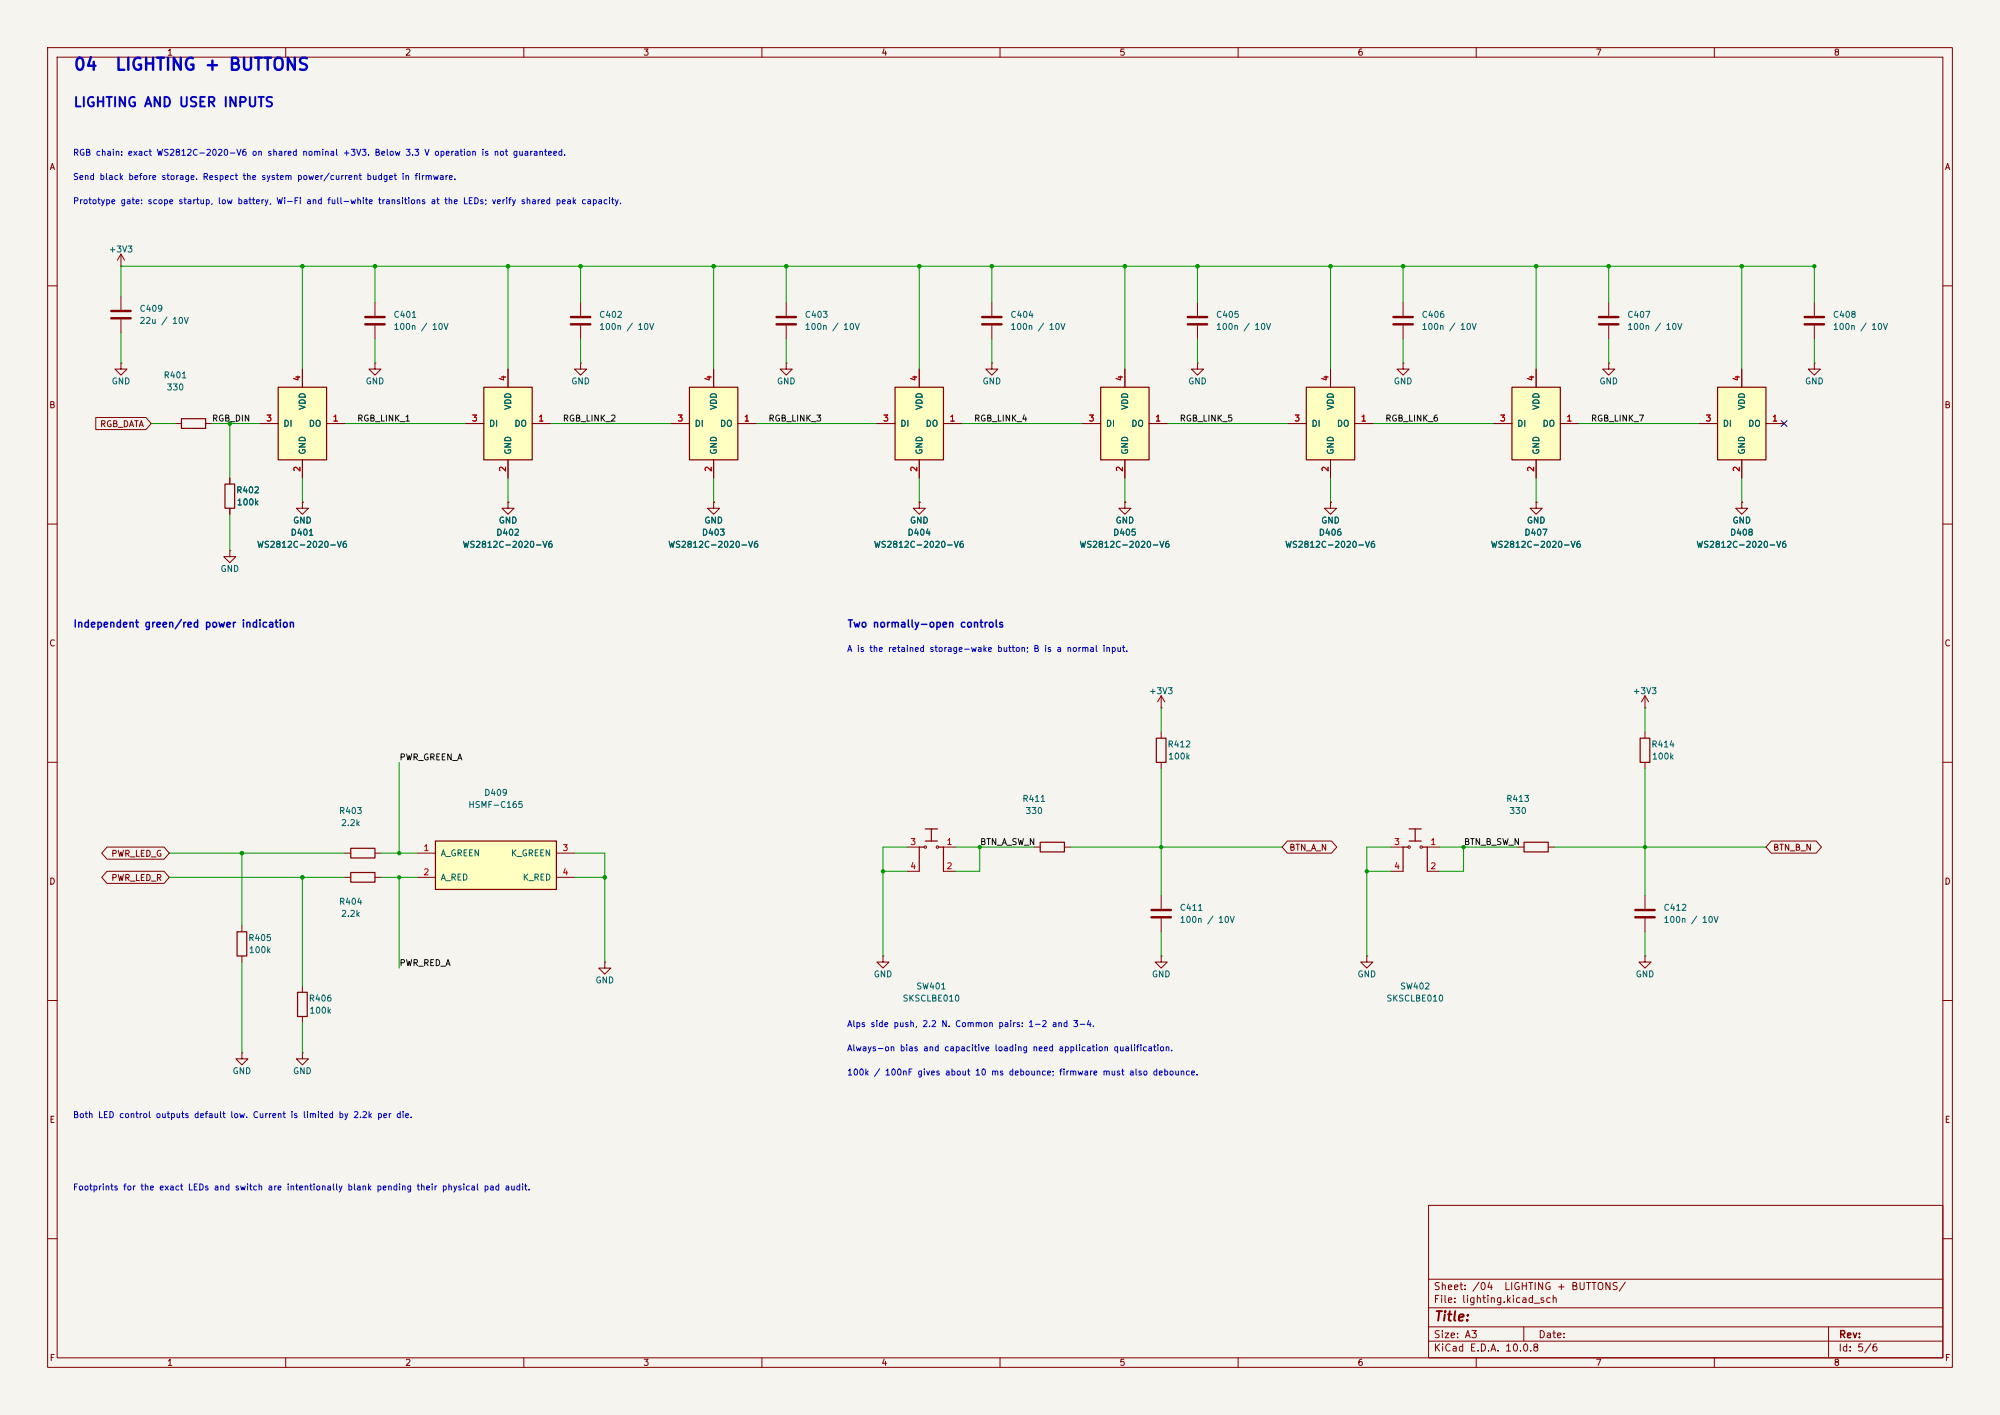
[picture p57: page 5]

LIGHTING AND USER INPUTS

Send black before storage. Respect the system power/current budget in firmware. RGB chain: exact WS2812C-2020-V6 on shared nominal +3V3. Below 3.3 V operation is not guaranteed.

Independent green/red power indication

Alps side push, 2.2 N. Common pairs: 1-2 and 3-4. 100k / 100nF gives about 10 ms debounce; firmware must also debounce.

Always-on bias and capacitive loading need application qualification.

Footprints for the exact LEDs and switch are intentionally blank pending their physical pad audit. Both LED control outputs default low. Current is limited by 2.2k per die.

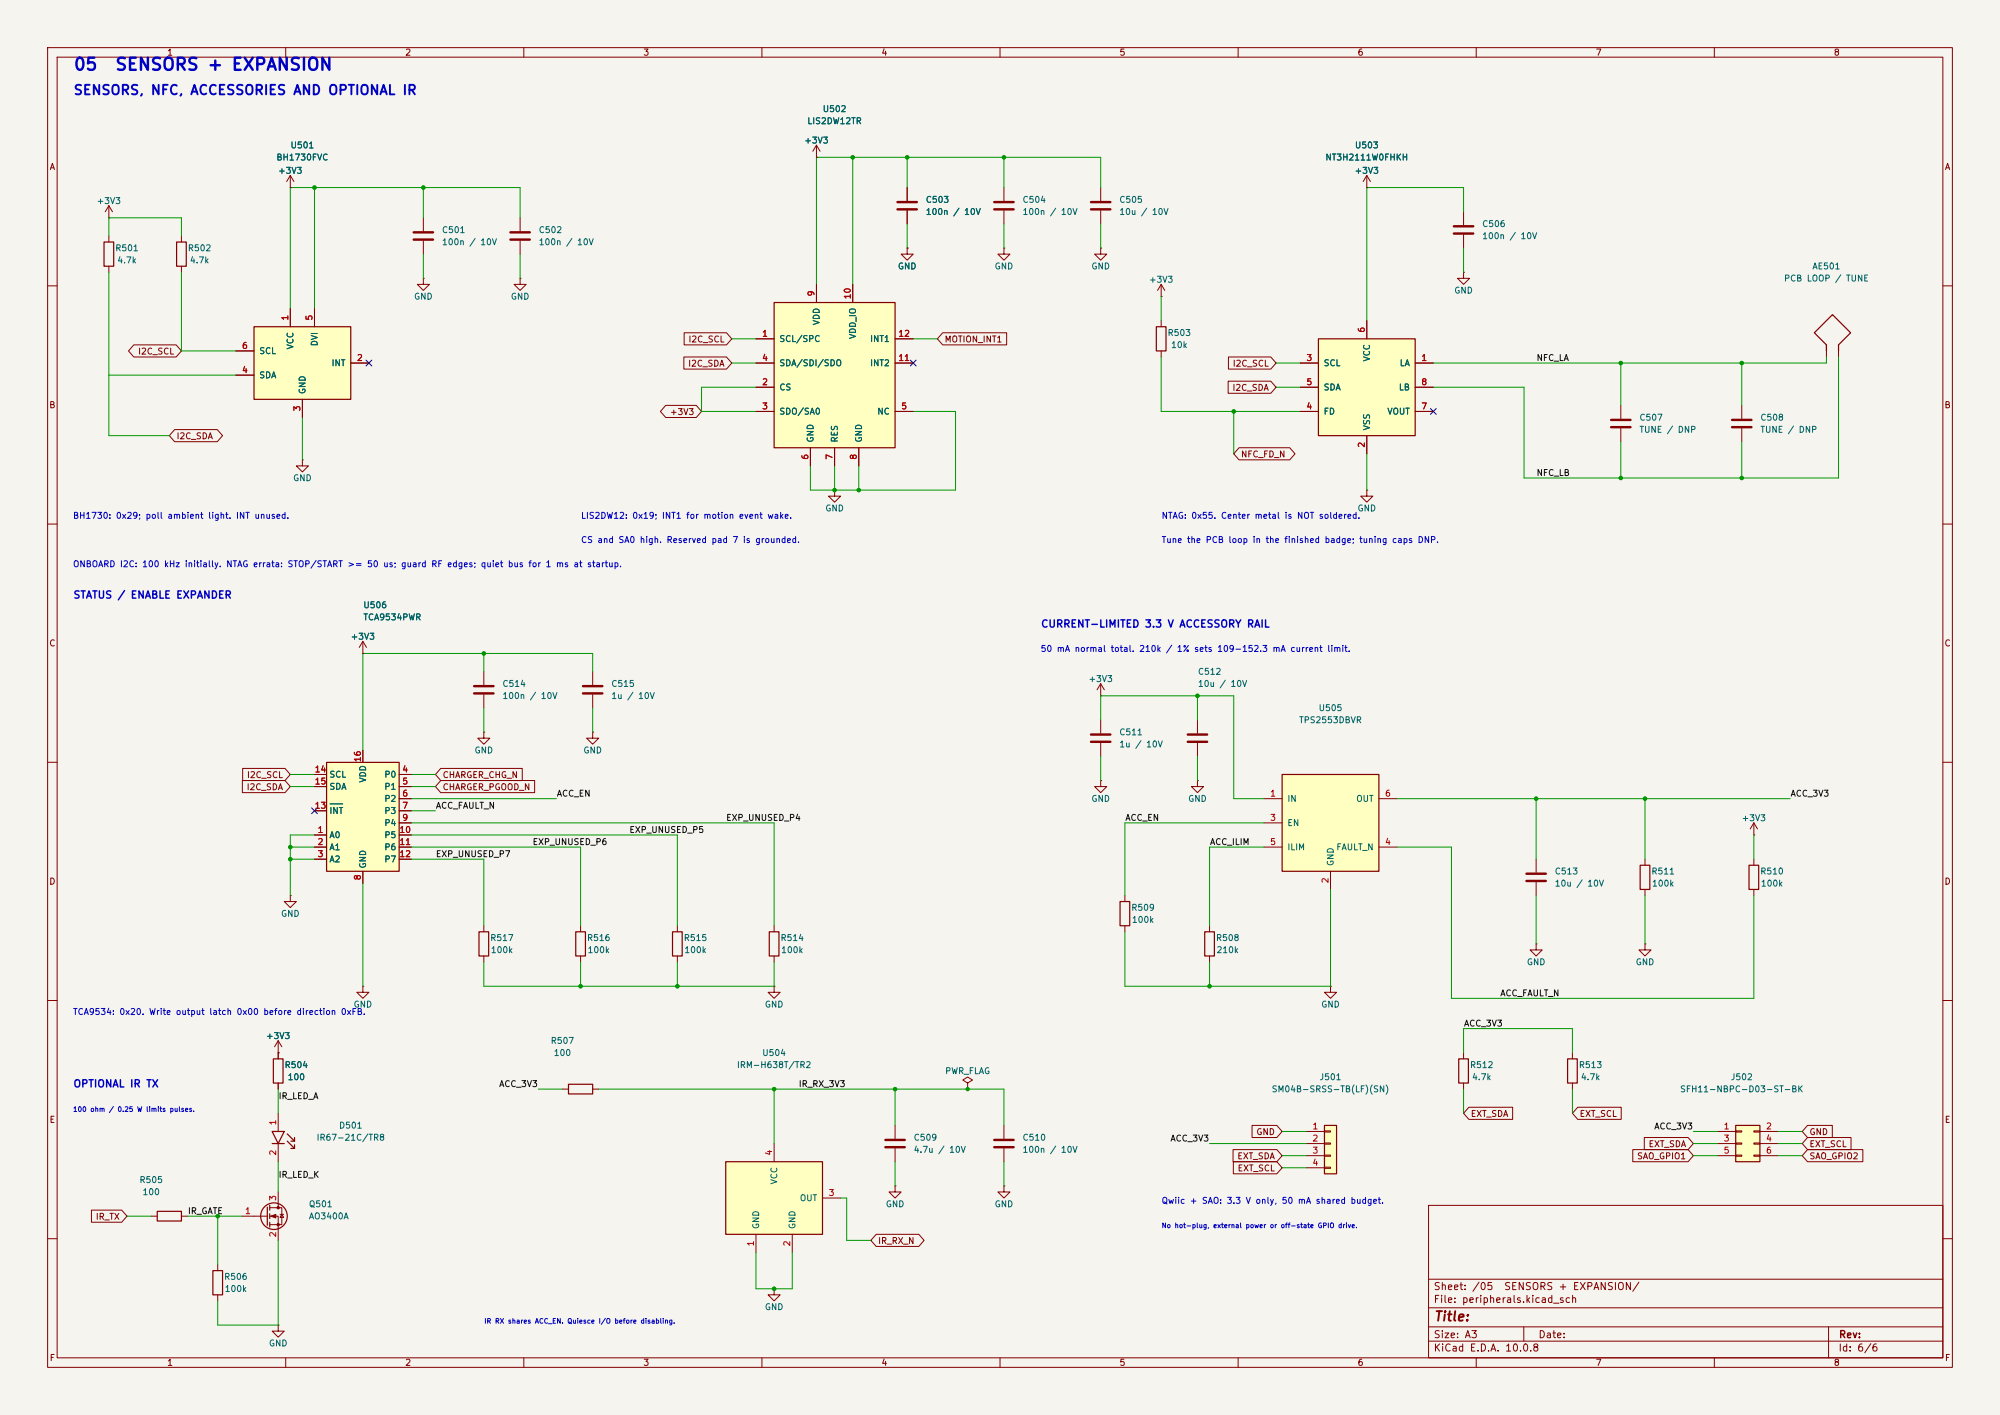
[picture p58: page 6]

05 SENSORS + EXPANSION
SENSORS, NFC, ACCESSORIES AND OPTIONAL IR

SM04B-SRSS-TB(LF)(SN) VCC

IR RX shares ACC_EN. Quiesce I/O before disabling. TCA9534: 0x20. Write output latch 0x00 before direction 0xFB. OPTIONAL IR TX

No hot-plug, external power or off-state GPIO drive. Qwiic + SAO: 3.3 V only, 50 mA shared budget.
