thebenedict/tinkerbadge-hardware/(list of files, drawings)

Other design files:
docs/design/history/2026-11-09-80mm-before-group-spacing/pcb_placement.json
docs/design/history/2026-11-09-100mm-two-sided-fallback/pcb_placement.json
docs/design/history/2026-11-09-left-button-placement/pcb_placement.json
docs/design/history/2026-11-09-organized-before-top-row/pcb_placement.json
docs/design/history/2026-11-10-before-lower-ir/pcb_placement.json
docs/design/history/2026-11-10-before-optical-reposition/pcb_placement.json
docs/design/history/2026-11-10-before-routing/docs/design/pcb_placement.json
docs/design/history/2026-11-10-before-shared-optics/pcb_placement.json
docs/design/pcb_footprint_assignments.json
docs/design/pcb_placement.json
exports/pcb-review/first-routing/schematic-contracts.json
exports/pcb-review/first-routing/schematic-properties.json
exports/pcb-review/schematic-sync.json
