thebenedict/tinkerbadge-hardware/tinkerbadge.kicad_pcb

## KiCad design tinkerbadge.kicad_pcb (2026-11-12)

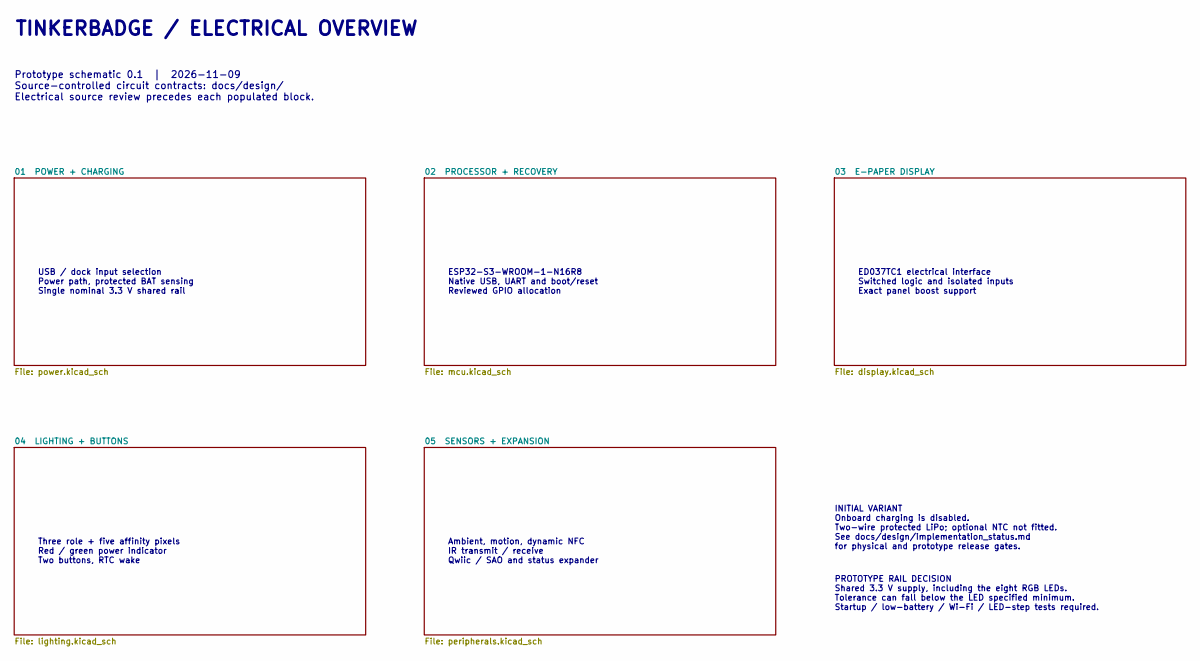
[picture p59: schematic tinkerbadge.kicad_sch]

Notes on the sheet:
ED037TC1 electrical interface Switched logic and isolated inputs Exact panel boost support
Ambient, motion, dynamic NFC IR transmit / receive Qwiic / SAO and status expander
ESP32-S3-WROOM-1-N16R8 Native USB, UART and boot/reset Reviewed GPIO allocation
Prototype schematic 0.1 | 2026-11-09 Source-controlled circuit contracts: docs/design/ Electrical source review precedes each populated block.
Three role + five affinity pixels Red / green power indicator Two buttons, RTC wake
INITIAL VARIANT Onboard charging is disabled. Two-wire protected LiPo; optional NTC not fitted. See docs/design/implementation_status.md for physical and prototype release gates.
TINKERBADGE / ELECTRICAL OVERVIEW
PROTOTYPE RAIL DECISION Shared 3.3 V supply, including the eight RGB LEDs. Tolerance can fall below the LED specified minimum. Startup / low-battery / Wi-Fi / LED-step tests required.
USB / dock input selection Power path, protected BAT sensing Single nominal 3.3 V shared rail

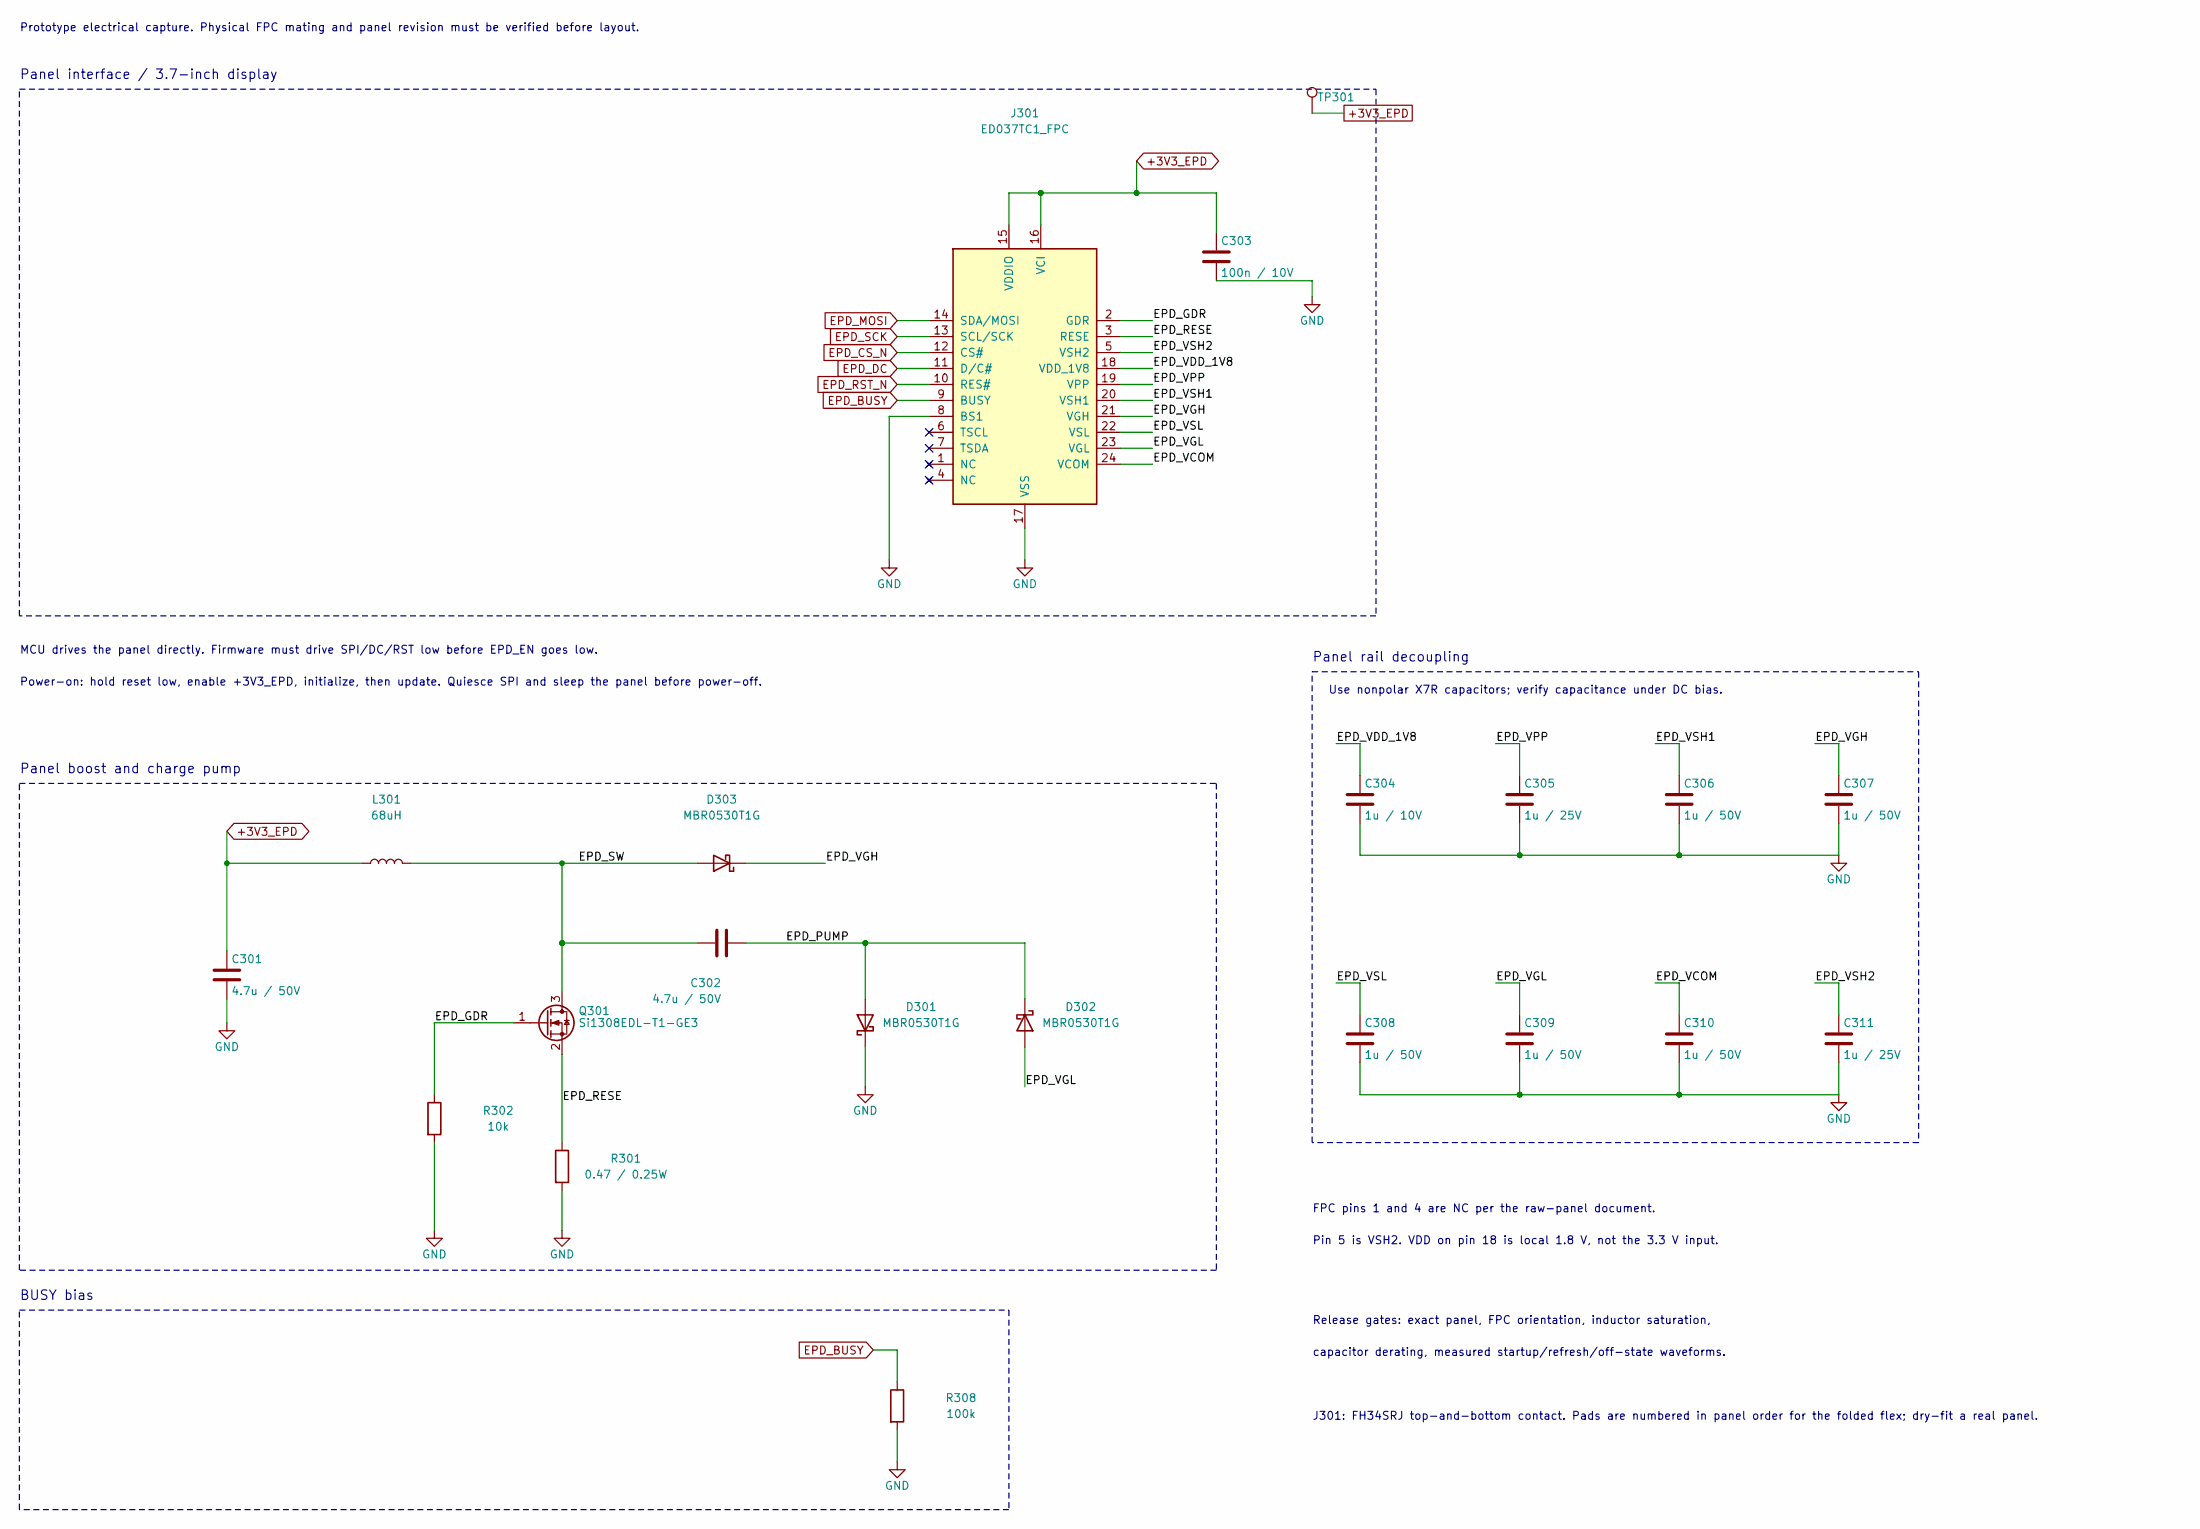
[picture p60: schematic display.kicad_sch]

Parts:
C301: 4.7u / 50V; C_1206_3216Metric; Rating 50V; X7R; ±10%; ceramic nonpolar; MPN 1206B475K500NT; LCSC C29823
C302: 4.7u / 50V; C_1206_3216Metric; Rating 50V; X7R; ±10%; ceramic nonpolar; verif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; MPN 1206B475K500NT; LCSC C29823
C303: 100n / 10V; C_0603_1608Metric; Rating 10V; X7R; ±10%; MPN CC0603KRX7R9BB104; LCSC C14663
C304: 1u / 10V; C_0805_2012Metric; Rating 10V; X7R; ±10%; ceramic nonpolar; selec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; MPN CL21B105KBFNNNE; LCSC C28323
C305, C311: 1u / 25V; C_0805_2012Metric; Rating 25V; X7R; ±10%; ceramic nonpolar; selec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; MPN CL21B105KBFNNNE; LCSC C28323
C306, C307, C308, C309, C310: 1u / 50V; C_0805_2012Metric; Rating 50V; X7R; ±10%; ceramic nonpolar; selec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; MPN CL21B105KBFNNNE; LCSC C28323
D301, D302, D303: MBR0530T1G; D_SOD-123; MPN MBR0530T1G; LCSC C82046
J301: ED037TC1_FPC; Hirose_FH34SRJ-24S-0.5SH_PanelOrder; MPN FH34SRJ-24S-0.5SH(50); LCSC C324726
L301: 68uH; L_Bourns-SRN4018; Rating ±20%; shielded; target Isat>=1A and Irm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; MPN SRN4018-680M; LCSC C2041717
Q301: Si1308EDL-T1-GE3; SOT-323_SC-70; MPN SI1308EDL-T1-GE3; LCSC C469327
R301: 0.47 / 0.25W; R_0805_2012Metric; Rating 1%; >=0.25W; pulse-rated; Kelvin route 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; MPN FBF05FT-R470-00L; LCSC C382278
R302: 10k; R_0603_1608Metric; Rating 1%; >=0.1W; MPN 0603WAF1002T5E; LCSC C25804
R308: 100k; R_0603_1608Metric; Rating 1%; >=0.1W; MPN 0603WAF1003T5E; LCSC C25803
TP301: +3V3_EPD; TestPoint_Pad_D1.0mm; MPN PCB pad only: no fitted component

Connections:
+3V3_EPD: C301.1, C303.1, J301.15 (VDDIO), J301.16 (VCI), L301.1, TP301.1; also elsewhere on the board
/03 E-PAPER DISPLAY/EPD_GDR: J301.2 (GDR), Q301.1 (G), R302.1
/03 E-PAPER DISPLAY/EPD_PUMP: C302.2, D301.2 (A), D302.1 (K)
/03 E-PAPER DISPLAY/EPD_RESE: J301.3 (RESE), Q301.2 (S), R301.1
/03 E-PAPER DISPLAY/EPD_SW: C302.1, D303.2 (A), L301.2, Q301.3 (D)
/03 E-PAPER DISPLAY/EPD_VCOM: C310.1, J301.24 (VCOM)
/03 E-PAPER DISPLAY/EPD_VDD_1V8: C304.1, J301.18 (VDD_1V8)
/03 E-PAPER DISPLAY/EPD_VGH: C307.1, D303.1 (K), J301.21 (VGH)
/03 E-PAPER DISPLAY/EPD_VGL: C309.1, D302.2 (A), J301.23 (VGL)
/03 E-PAPER DISPLAY/EPD_VPP: C305.1, J301.19 (VPP)
/03 E-PAPER DISPLAY/EPD_VSH1: C306.1, J301.20 (VSH1)
/03 E-PAPER DISPLAY/EPD_VSH2: C311.1, J301.5 (VSH2)
/03 E-PAPER DISPLAY/EPD_VSL: C308.1, J301.22 (VSL)
EPD_BUSY: J301.9 (BUSY), R308.1; also elsewhere on the board
EPD_CS_N: J301.12 (CS#); also elsewhere on the board
EPD_DC: J301.11 (D/C#); also elsewhere on the board
EPD_MOSI: J301.14 (SDA/MOSI); also elsewhere on the board
EPD_RST_N: J301.10 (RES#); also elsewhere on the board
EPD_SCK: J301.13 (SCL/SCK); also elsewhere on the board

Notes on the sheet:
FPC pins 1 and 4 are NC per the raw-panel document.
Power-on: hold reset low, enable +3V3_EPD, initialize, then update. Quiesce SPI and sleep the panel before power-off.
Panel boost and charge pump
Prototype electrical capture. Physical FPC mating and panel revision must be verified before layout.
Panel interface / 3.7-inch display
Use nonpolar X7R capacitors; verify capacitance under DC bias.
J301: FH34SRJ top-and-bottom contact. Pads are numbered in panel order for the folded flex; dry-fit a real panel.
MCU drives the panel directly. Firmware must drive SPI/DC/RST low before EPD_EN goes low.
Release gates: exact panel, FPC orientation, inductor saturation,
Panel rail decoupling
Pin 5 is VSH2. VDD on pin 18 is local 1.8 V, not the 3.3 V input.
capacitor derating, measured startup/refresh/off-state waveforms.
BUSY bias

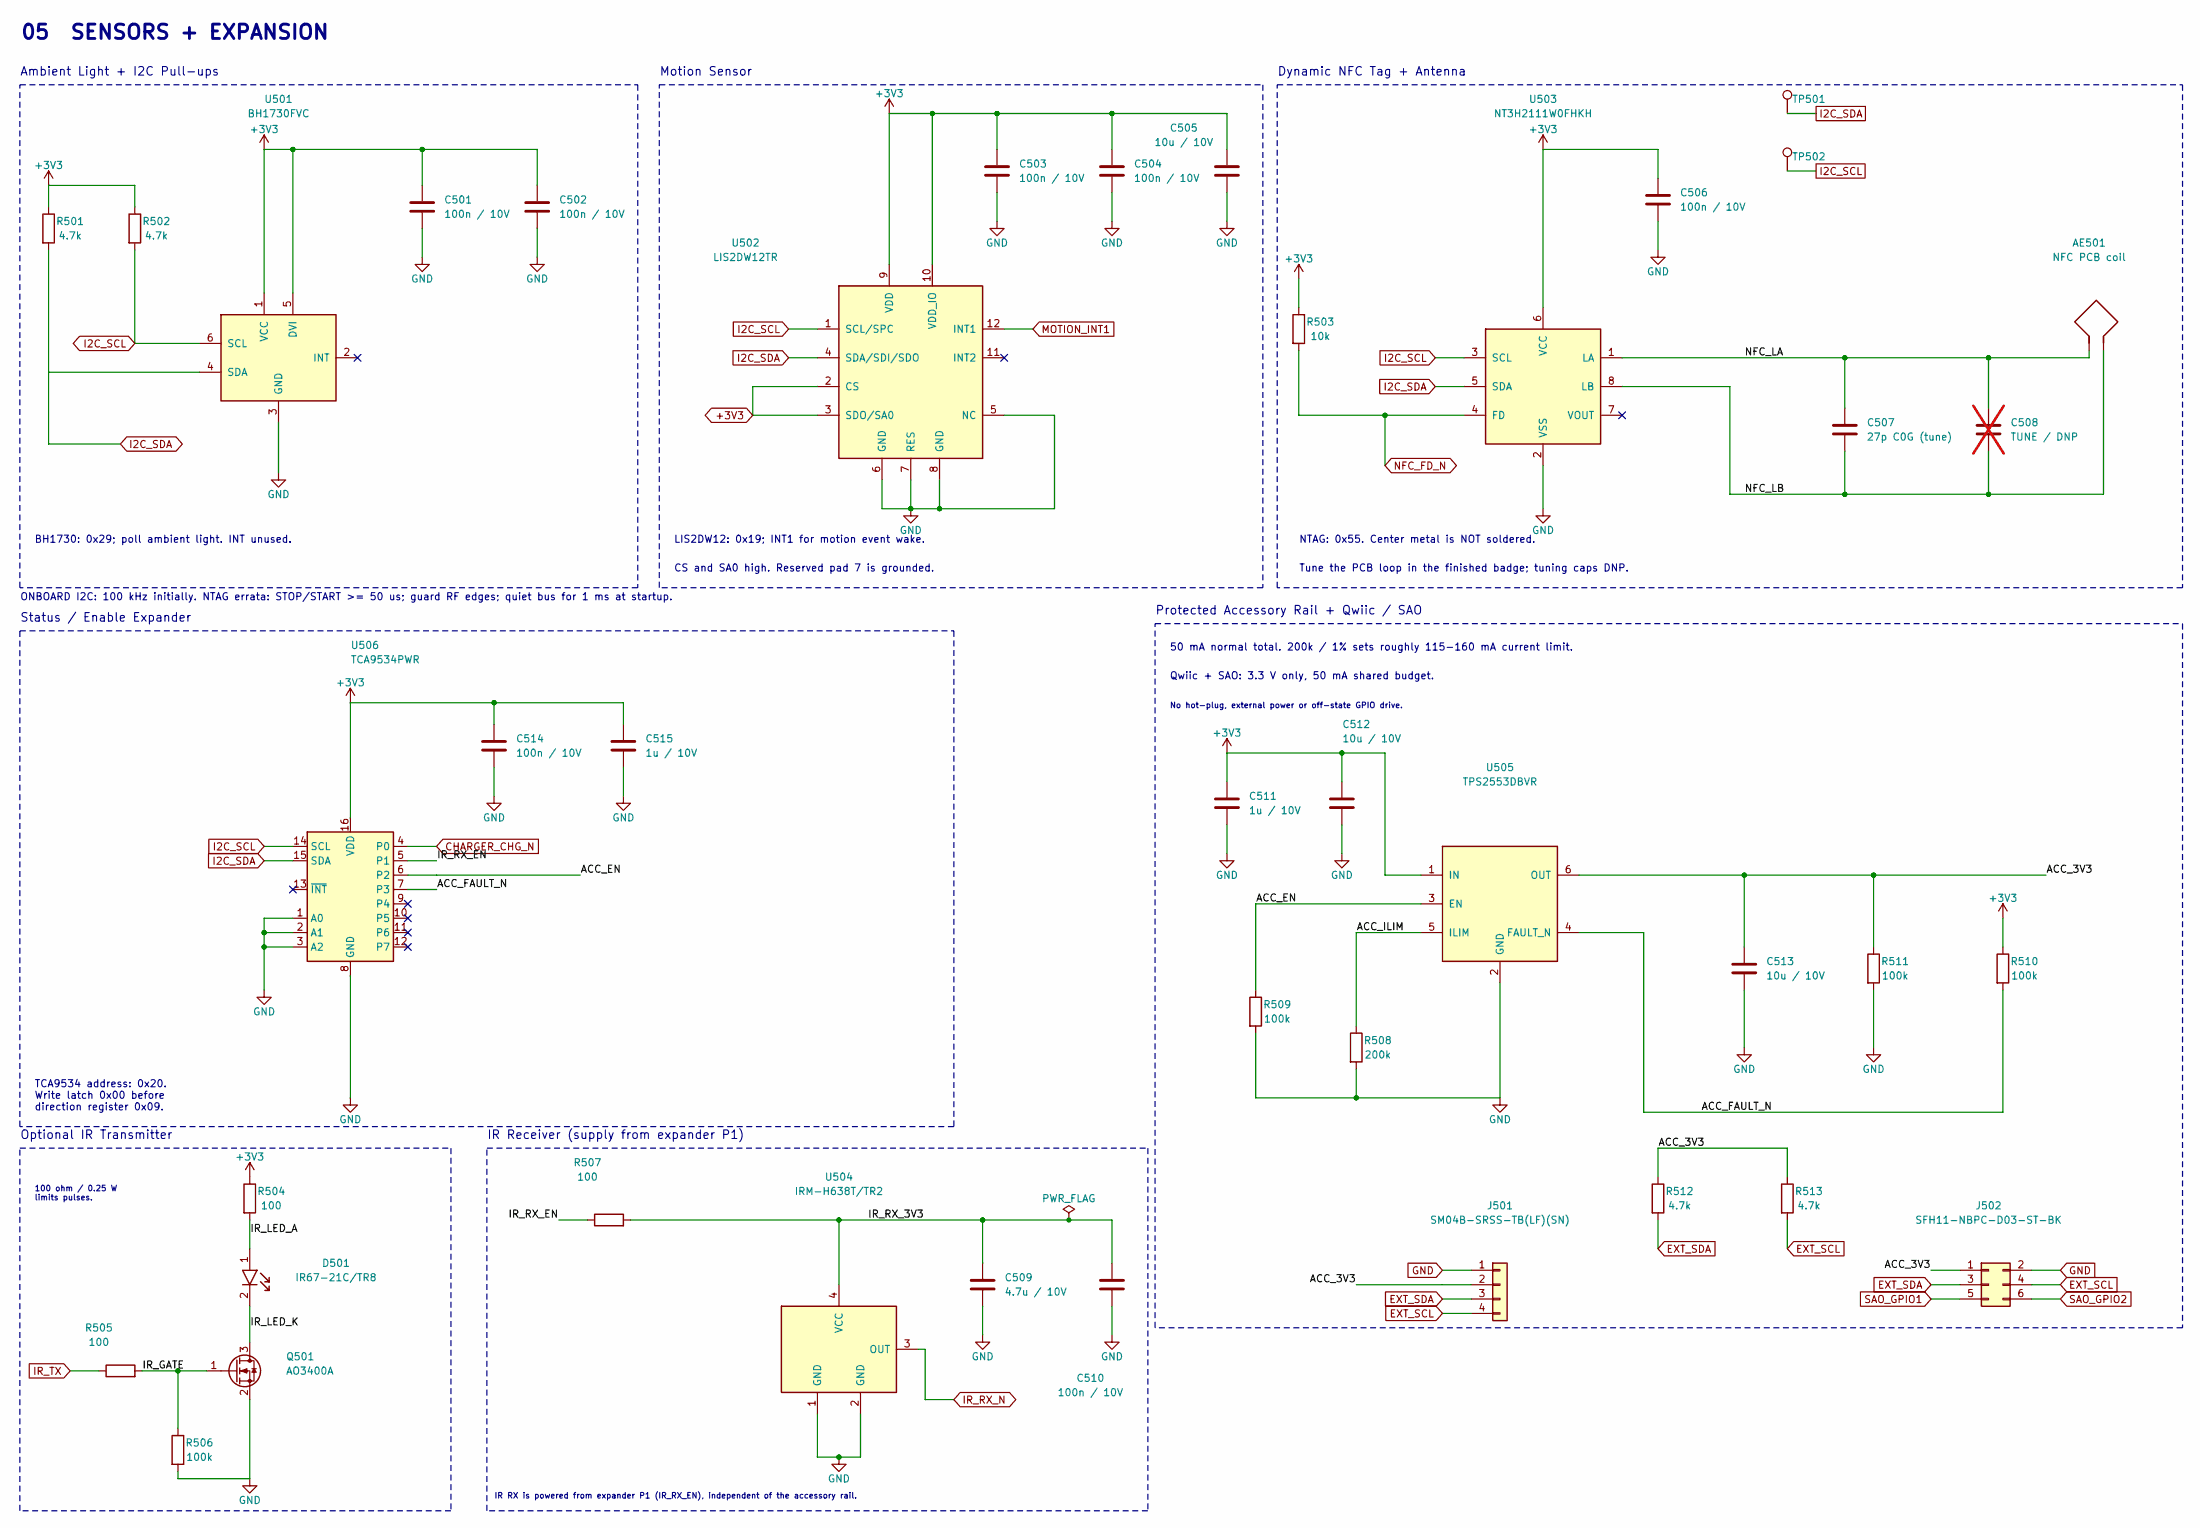
[picture p61: schematic peripherals.kicad_sch]

Parts:
AE501: NFC PCB coil; NFC_Coil_Rear_18x13; Rating 13.56MHz PCB loop, tune; MPN PCB feature: no fitted component
C501, C502, C503, C504, C506, C510, C514: 100n / 10V; C_0603_1608Metric; Rating 100nF 10V X7R; MPN CC0603KRX7R9BB104; LCSC C14663
C505, C512, C513: 10u / 10V; C_0805_2012Metric; Rating 10uF 10V X7R; MPN CL21A106KAYNNNE; LCSC C15850
C507: 27p C0G (tune); C_0603_1608Metric; Rating 27p C0G 50V; MPN CC0603JRNPO9BN270; LCSC C107045
C508: TUNE / DNP; C_0603_1608Metric; Rating TUNE DNP C0G 50V; MPN TBD: support part specification; not fitted
C509: 4.7u / 10V; C_0603_1608Metric; Rating 4.7uF 10V X7R; MPN CL10A475KO8NNNC; LCSC C19666
C511, C515: 1u / 10V; C_0603_1608Metric; Rating 1uF 10V X7R; MPN CL10A105KB8NNNC; LCSC C15849
D501: IR67-21C/TR8; IR67-21C_TR8; Rating 3528 two-pad; MPN IR67-21C/TR8; LCSC C60109
J501: SM04B-SRSS-TB(LF)(SN); JST_SH_SM04B_ProjectTabs; Rating SH1x4 side-entry1mm; MPN SM04B-SRSS-TB(LF)(SN); LCSC C160404
J502: SFH11-NBPC-D03-ST-BK; SAO_Socket_2x03_Front; Rating Keyed female2x3 P2.54mm THT; MPN SFH11-NBPC-D03-ST-BK; LCSC C3320727
Q501: AO3400A; SOT-23; Rating SOT-23; MPN AO3400A; LCSC C20917
R501, R502, R512, R513: 4.7k; R_0603_1608Metric; Rating 4.7k 1%; MPN 0603WAF4701T5E; LCSC C23162
R503: 10k; R_0603_1608Metric; Rating 10k 1%; MPN 0603WAF1002T5E; LCSC C25804
R504: 100; R_0805_2012Metric; Rating 100R 1% 0.25W; MPN 0805W8F1000T5E; LCSC C17408
R505, R507: 100; R_0603_1608Metric; Rating 100R 1%; MPN 0603WAF1000T5E; LCSC C22775
R506, R509, R510, R511: 100k; R_0603_1608Metric; Rating 100k 1%; MPN 0603WAF1003T5E; LCSC C25803
R508: 200k; R_0603_1608Metric; Rating 200k 1%; MPN 0603WAF2003T5E; LCSC C25811
TP501: I2C_SDA; TestPoint_Pad_D1.0mm; MPN PCB pad only: no fitted component
TP502: I2C_SCL; TestPoint_Pad_D1.0mm; MPN PCB pad only: no fitted component
U501: BH1730FVC; BH1730FVC_WSOF6; Rating WSOF6; MPN BH1730FVC; LCSC C79616
U502: LIS2DW12TR; LGA-12_2x2mm_P0.5mm; Rating LGA12 2x2mm; MPN LIS2DW12TR; LCSC C189624
U503: NT3H2111W0FHKH; NT3H2111W0FHKH_XQFN8; Rating XQFN8 SOT902-3; MPN NT3H2111W0FHKH; LCSC C710403
U504: IRM-H638T/TR2; IRM-H638T_Reviewed; Rating H6XXT four-pad; MPN IRM-H638T/TR2; LCSC C91447
U505: TPS2553DBVR; SOT-23-6; Rating DBV SOT-23-6; MPN TPS2553DBVR; LCSC C55266
U506: TCA9534PWR; TSSOP-16_4.4x5mm_P0.65mm; Rating PW TSSOP16; MPN TCA9534PWR; LCSC C783615

Connections:
+3V3: C501.1, C502.1, C503.1, C504.1, C505.1, C506.1, C511.1, C512.1, C514.1, C515.1, R501.1, R502.1, R503.1, R504.1, R510.1, U501.1 (VCC), U501.5 (DVI), U502.2 (CS), U502.3 (SDO/SA0), U502.9 (VDD), U502.10 (VDD_IO), U503.6 (VCC), U505.1 (IN), U506.16 (VDD); also elsewhere on the board
/05 SENSORS + EXPANSION/ACC_3V3: C513.1, J501.2, J502.1, R511.1, R512.1, R513.1, U505.6 (OUT)
/05 SENSORS + EXPANSION/ACC_EN: R509.1, U505.3 (EN), U506.6 (P2)
/05 SENSORS + EXPANSION/ACC_FAULT_N: R510.2, U505.4 (FAULT_N), U506.7 (P3)
/05 SENSORS + EXPANSION/ACC_ILIM: R508.1, U505.5 (ILIM)
/05 SENSORS + EXPANSION/IR_GATE: Q501.1 (G), R505.2, R506.1
/05 SENSORS + EXPANSION/IR_LED_A: D501.1 (ANODE), R504.2
/05 SENSORS + EXPANSION/IR_LED_K: D501.2 (CATHODE), Q501.3 (D)
/05 SENSORS + EXPANSION/IR_RX_3V3: C509.1, C510.1, R507.2, U504.4 (VCC)
/05 SENSORS + EXPANSION/IR_RX_EN: R507.1, U506.5 (P1)
/05 SENSORS + EXPANSION/NFC_LA: AE501.1, C507.1, C508.1, U503.1 (LA)
/05 SENSORS + EXPANSION/NFC_LB: AE501.2, C507.2, C508.2, U503.8 (LB)
CHARGER_CHG_N: U506.4 (P0); also elsewhere on the board
EXT_SCL: J501.4, J502.4, R513.2; also elsewhere on the board
EXT_SDA: J501.3, J502.3, R512.2; also elsewhere on the board
I2C_SCL: R502.2, TP502.1, U501.6 (SCL), U502.1 (SCL/SPC), U503.3 (SCL), U506.14 (SCL); also elsewhere on the board
I2C_SDA: R501.2, TP501.1, U501.4 (SDA), U502.4 (SDA/SDI/SDO), U503.5 (SDA), U506.15 (SDA); also elsewhere on the board
IR_RX_N: U504.3 (OUT); also elsewhere on the board
IR_TX: R505.1; also elsewhere on the board
MOTION_INT1: U502.12 (INT1); also elsewhere on the board
NFC_FD_N: R503.2, U503.4 (FD); also elsewhere on the board
SAO_GPIO1: J502.5; also elsewhere on the board
SAO_GPIO2: J502.6; also elsewhere on the board

Notes on the sheet:
05 SENSORS + EXPANSION
Qwiic + SAO: 3.3 V only, 50 mA shared budget.
ONBOARD I2C: 100 kHz initially. NTAG errata: STOP/START >= 50 us; guard RF edges; quiet bus for 1 ms at startup.
No hot-plug, external power or off-state GPIO drive.
Dynamic NFC Tag + Antenna
Motion Sensor
50 mA normal total. 200k / 1% sets roughly 115-160 mA current limit.
NTAG: 0x55. Center metal is NOT soldered.
Tune the PCB loop in the finished badge; tuning caps DNP.
Optional IR Transmitter
BH1730: 0x29; poll ambient light. INT unused.
CS and SA0 high. Reserved pad 7 is grounded.
Status / Enable Expander
IR RX is powered from expander P1 (IR_RX_EN), independent of the accessory rail.
TCA9534 address: 0x20. Write latch 0x00 before direction register 0x09.
Protected Accessory Rail + Qwiic / SAO
Ambient Light + I2C Pull-ups
LIS2DW12: 0x19; INT1 for motion event wake.
IR Receiver (supply from expander P1)
100 ohm / 0.25 W limits pulses.

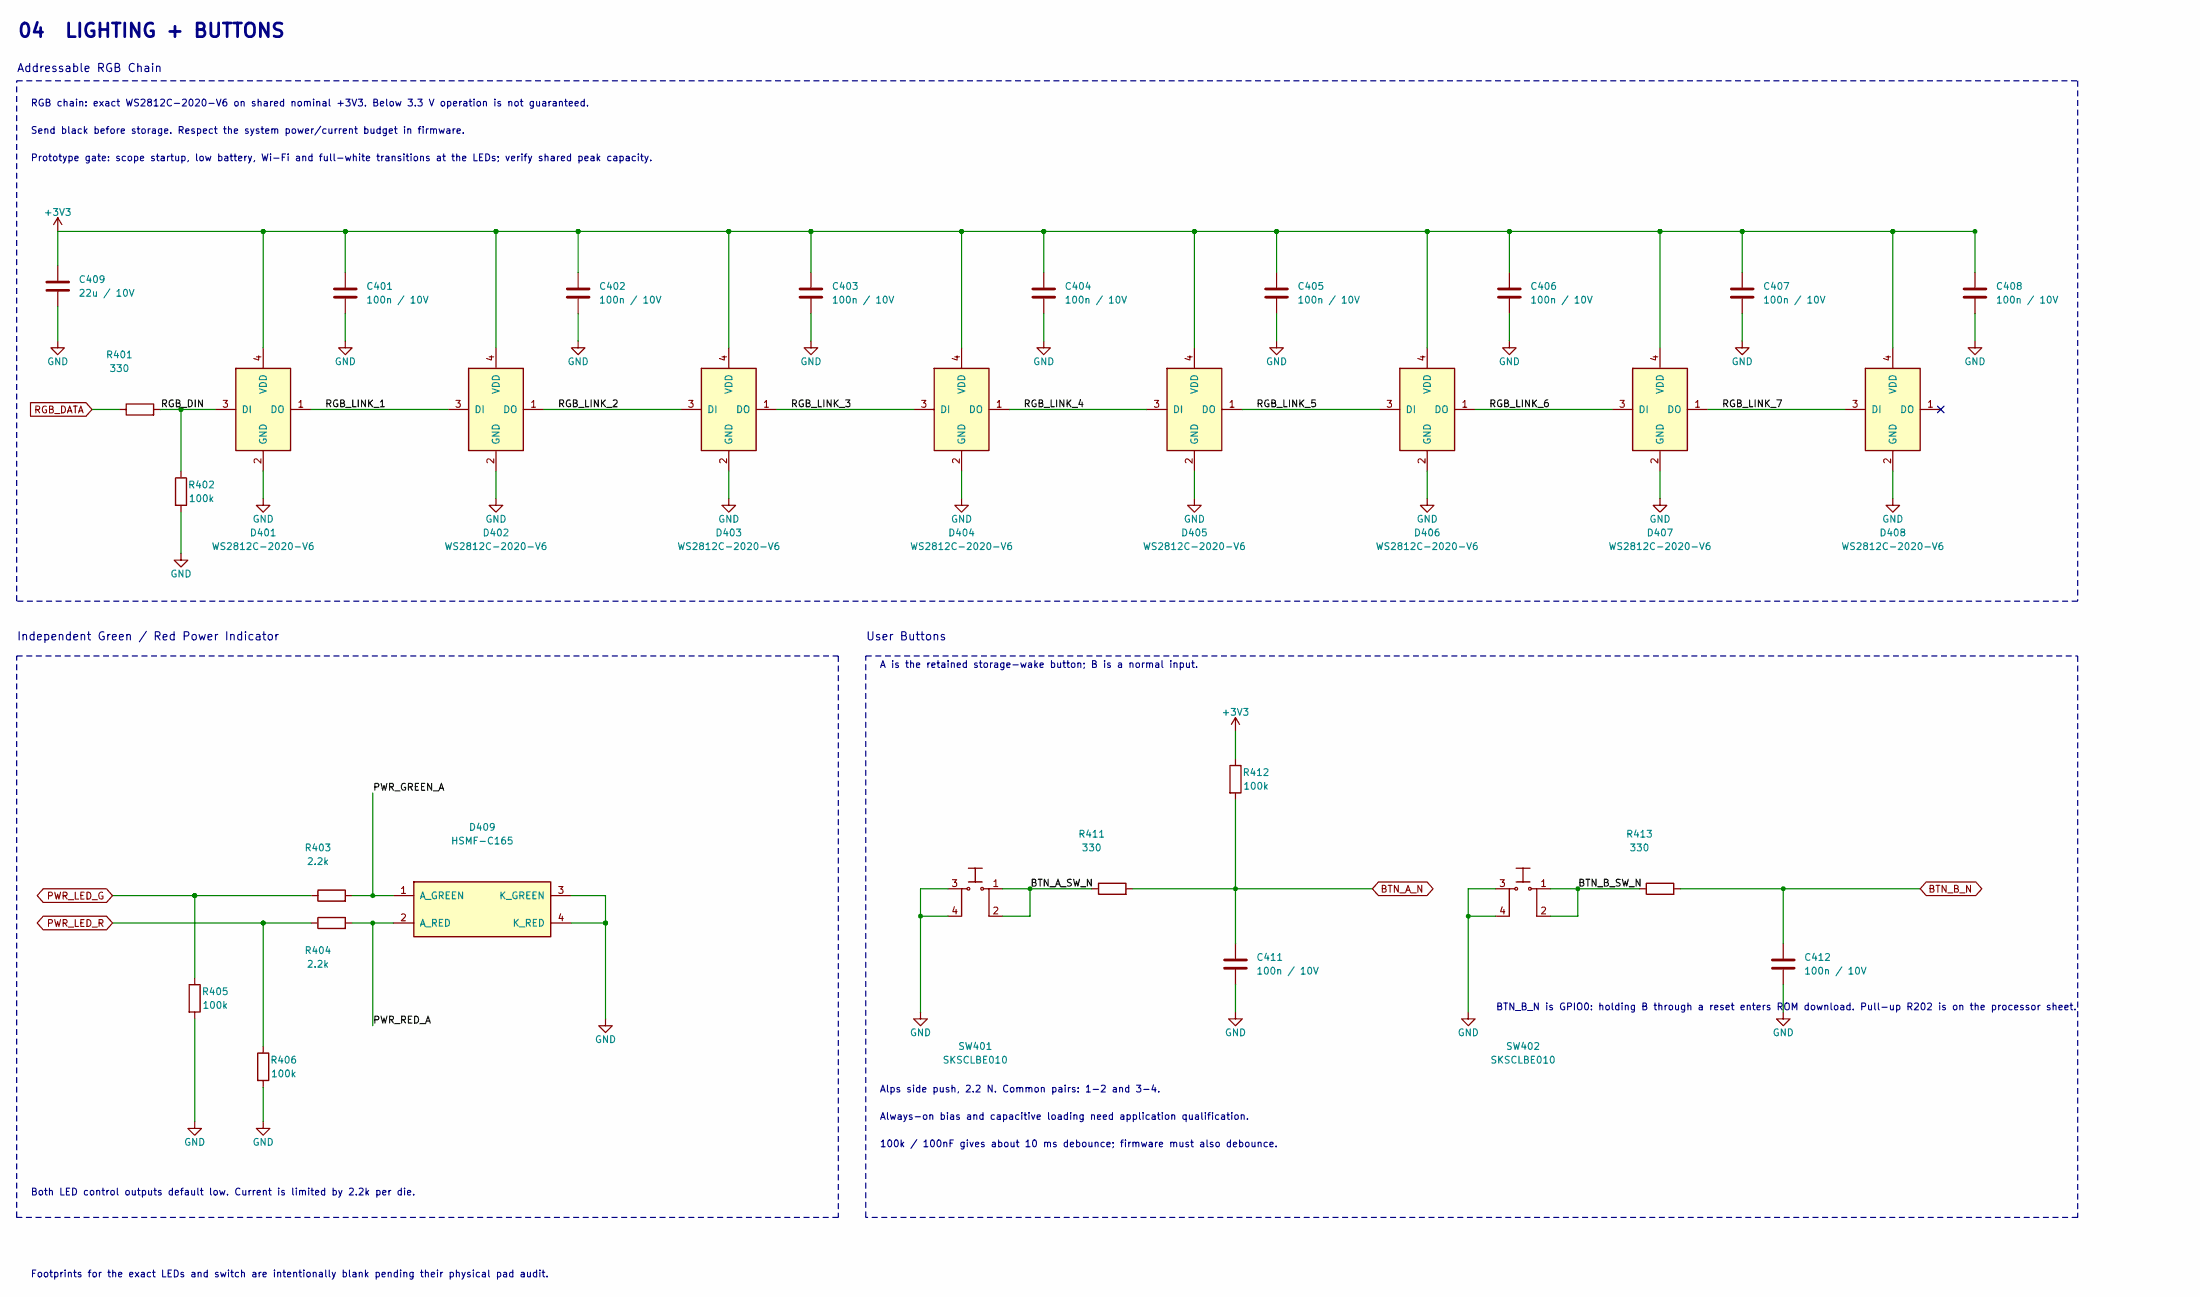
[picture p62: schematic lighting.kicad_sch]

Parts:
C401, C402, C403, C404, C405, C406, C407, C408, C411, C412: 100n / 10V; C_0603_1608Metric; Rating 100nF 10V X7R; MPN CC0603KRX7R9BB104; LCSC C14663
C409: 22u / 10V; C_0805_2012Metric; Rating 22uF 10V X7R; MPN CL21A226MAQNNNE; LCSC C45783
D401, D402, D403, D404, D405, D406, D407, D408: WS2812C-2020-V6; WS2812C-2020-V6_Reviewed; Rating 2020 four-pad; MPN WS2812C-2020-V6; LCSC C55109522
D409: HSMF-C165; Rating 0603 four-pad; MPN HSMF-C165; LCSC C188726
R401, R411, R413: 330; R_0603_1608Metric; Rating 330R 1%; MPN 0603WAF3300T5E; LCSC C23138
R402, R405, R406, R412: 100k; R_0603_1608Metric; Rating 100k 1%; MPN 0603WAF1003T5E; LCSC C25803
R403, R404: 2.2k; R_0603_1608Metric; Rating 2.2k 1%; MPN 0603WAF2201T5E; LCSC C4190
SW401, SW402: SKSCLBE010; Rating 12VDC/50mA max;1VDC/10uA min;2.2+/-0.65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; MPN SKSCLBE010; JLCPCB C115361

Connections:
+3V3: C401.1, C402.1, C403.1, C404.1, C405.1, C406.1, C407.1, C408.1, C409.1, D401.4 (VDD), D402.4 (VDD), D403.4 (VDD), D404.4 (VDD), D405.4 (VDD), D406.4 (VDD), D407.4 (VDD), D408.4 (VDD), R412.1; also elsewhere on the board
/04 LIGHTING + BUTTONS/BTN_A_SW_N: R411.1, SW401.1, SW401.2
/04 LIGHTING + BUTTONS/BTN_B_SW_N: R413.1, SW402.1, SW402.2
/04 LIGHTING + BUTTONS/PWR_GREEN_A: D409.1 (A_GREEN), R403.2
/04 LIGHTING + BUTTONS/PWR_RED_A: D409.2 (A_RED), R404.2
/04 LIGHTING + BUTTONS/RGB_DIN: D401.3 (DI), R401.2, R402.1
/04 LIGHTING + BUTTONS/RGB_LINK_1: D401.1 (DO), D402.3 (DI)
/04 LIGHTING + BUTTONS/RGB_LINK_2: D402.1 (DO), D403.3 (DI)
/04 LIGHTING + BUTTONS/RGB_LINK_3: D403.1 (DO), D404.3 (DI)
/04 LIGHTING + BUTTONS/RGB_LINK_4: D404.1 (DO), D405.3 (DI)
/04 LIGHTING + BUTTONS/RGB_LINK_5: D405.1 (DO), D406.3 (DI)
/04 LIGHTING + BUTTONS/RGB_LINK_6: D406.1 (DO), D407.3 (DI)
/04 LIGHTING + BUTTONS/RGB_LINK_7: D407.1 (DO), D408.3 (DI)
BTN_A_N: C411.1, R411.2, R412.2; also elsewhere on the board
BTN_B_N: C412.1, R413.2; also elsewhere on the board
PWR_LED_G: R403.1, R405.1; also elsewhere on the board
PWR_LED_R: R404.1, R406.1; also elsewhere on the board
RGB_DATA: R401.1; also elsewhere on the board

Notes on the sheet:
Send black before storage. Respect the system power/current budget in firmware.
RGB chain: exact WS2812C-2020-V6 on shared nominal +3V3. Below 3.3 V operation is not guaranteed.
Alps side push, 2.2 N. Common pairs: 1-2 and 3-4.
A is the retained storage-wake button; B is a normal input.
Addressable RGB Chain
04 LIGHTING + BUTTONS
100k / 100nF gives about 10 ms debounce; firmware must also debounce.
Prototype gate: scope startup, low battery, Wi-Fi and full-white transitions at the LEDs; verify shared peak capacity.
BTN_B_N is GPIO0: holding B through a reset enters ROM download. Pull-up R202 is on the processor sheet.
Both LED control outputs default low. Current is limited by 2.2k per die.
Always-on bias and capacitive loading need application qualification.
User Buttons
Footprints for the exact LEDs and switch are intentionally blank pending their physical pad audit.
Independent Green / Red Power Indicator
