thebenedict/tinkerbadge-hardware/tinkerbadge.kicad_pcb

## KiCad design tinkerbadge.kicad_pcb (continued)

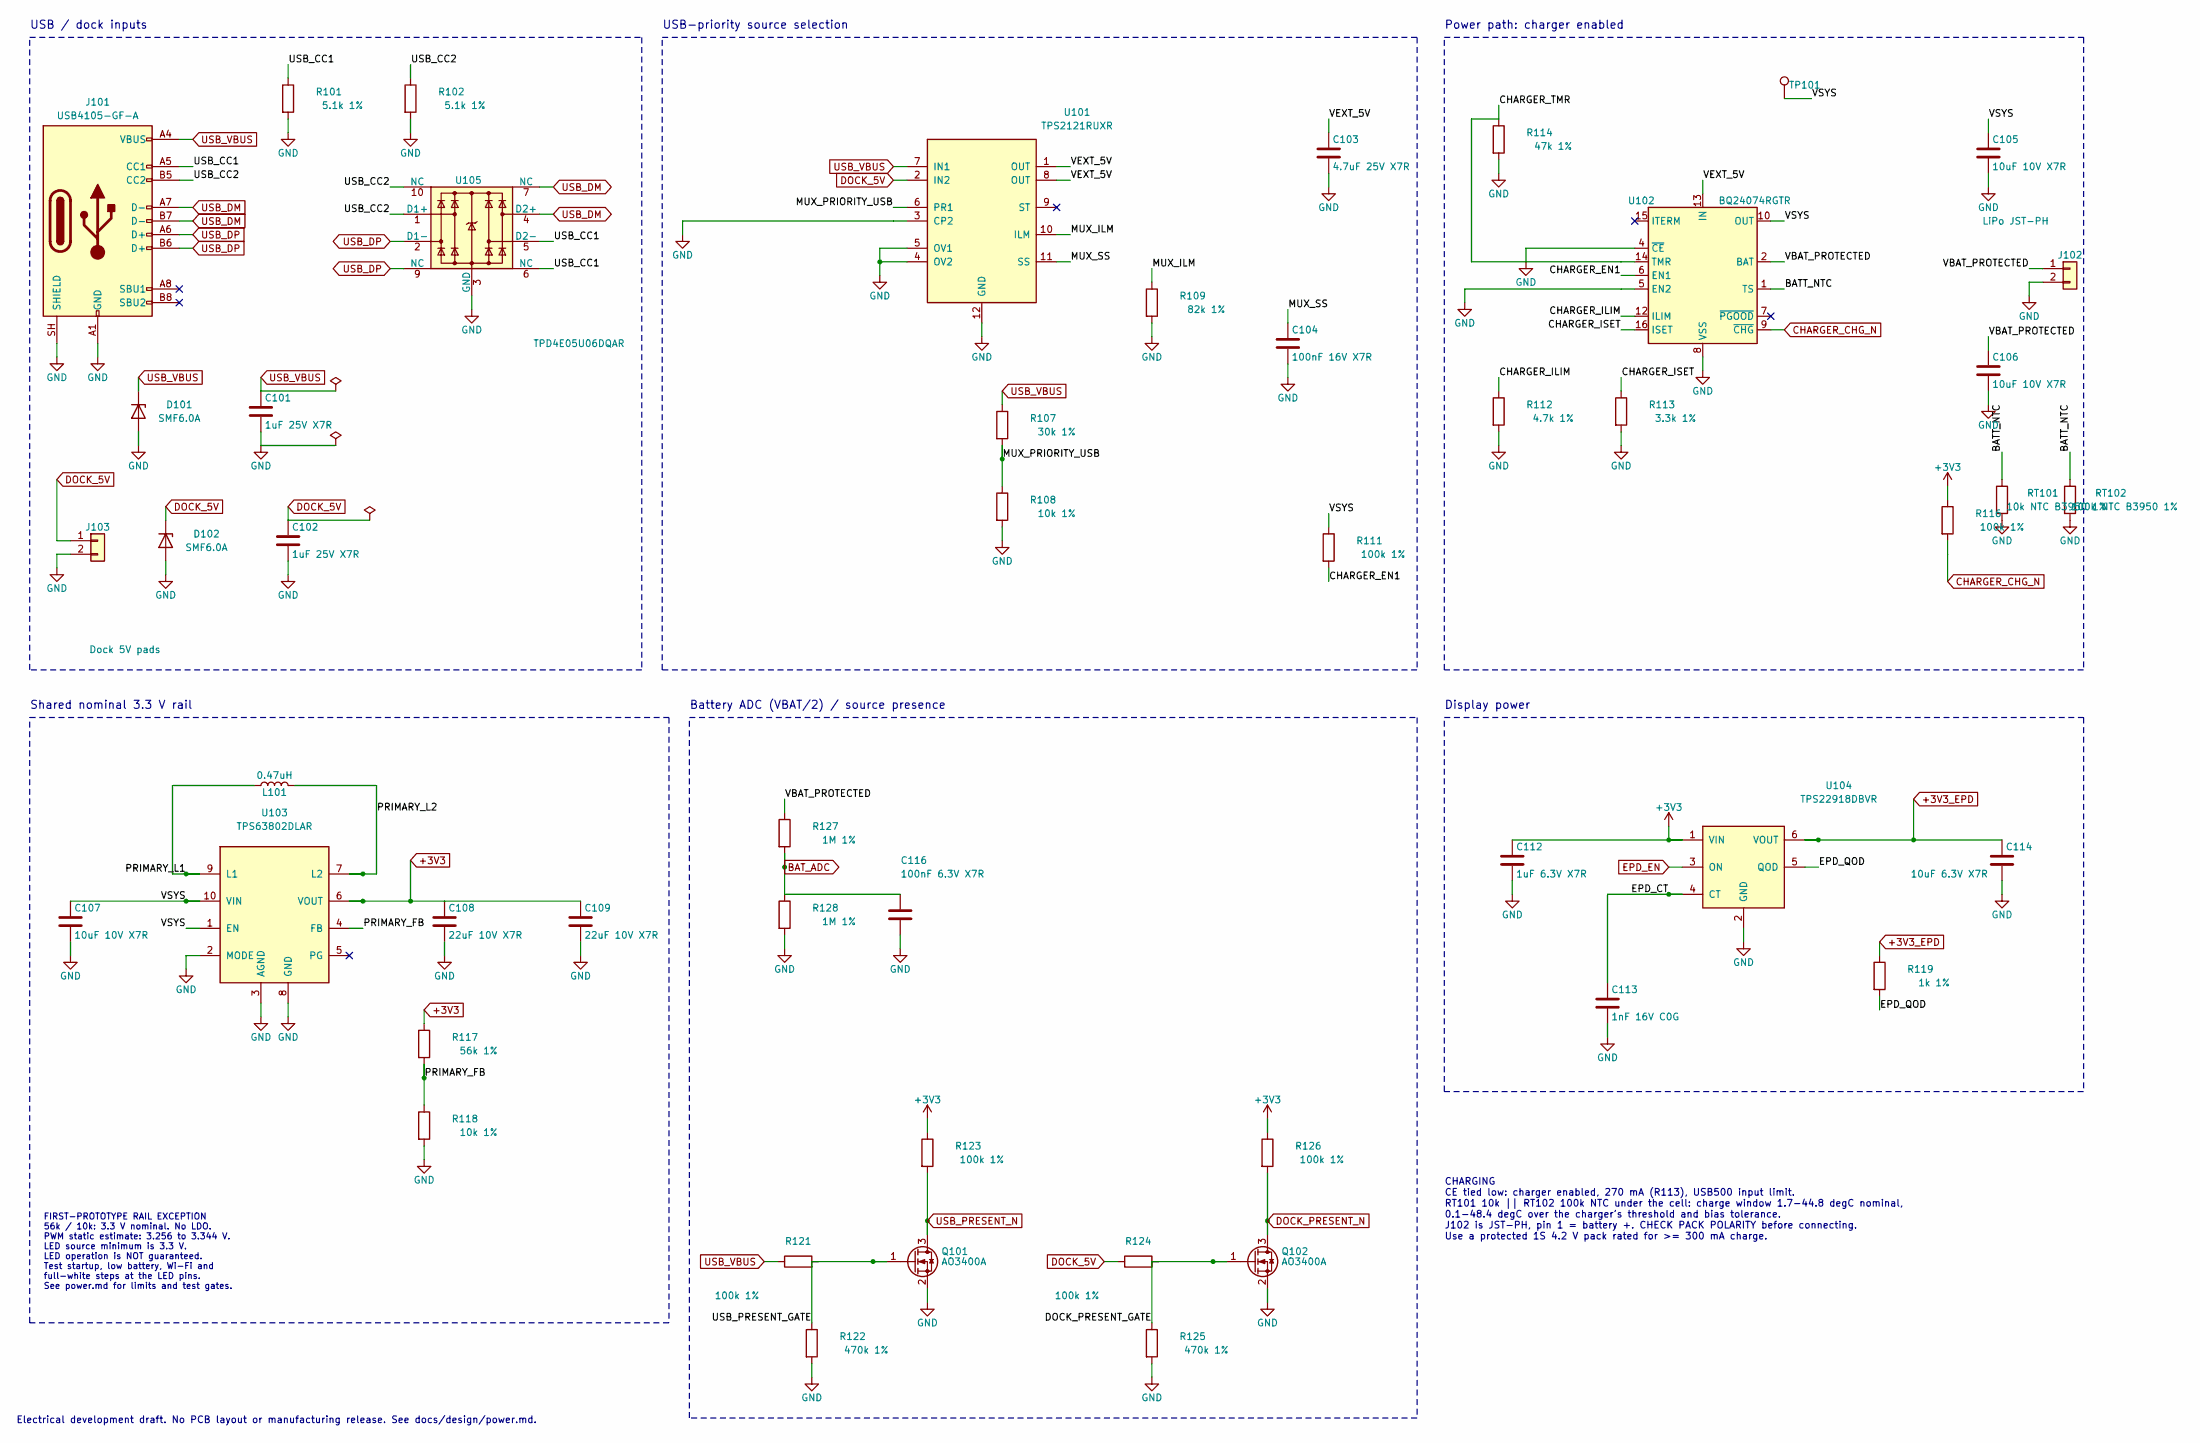
[picture p63: schematic power.kicad_sch]

Parts:
C101, C102: 1uF 25V X7R; C_0805_2012Metric; MPN CL21B105KBFNNNE; LCSC C28323
C103: 4.7uF 25V X7R; C_1206_3216Metric; MPN 1206B475K500NT; LCSC C29823
C104: 100nF 16V X7R; C_0603_1608Metric; MPN CC0603KRX7R9BB104; LCSC C14663
C105, C106, C107: 10uF 10V X7R; C_0805_2012Metric; MPN CL21A106KAYNNNE; LCSC C15850
C108, C109: 22uF 10V X7R; C_1210_3225Metric; MPN CL32B226KAJNNNE; LCSC C309062
C112: 1uF 6.3V X7R; C_0805_2012Metric; MPN CL21B105KBFNNNE; LCSC C28323
C113: 1nF 16V C0G; C_0603_1608Metric; MPN CL10B102KB8NNNC; LCSC C1588
C114: 10uF 6.3V X7R; C_0805_2012Metric; MPN CL21A106KAYNNNE; LCSC C15850
C116: 100nF 6.3V X7R; C_0603_1608Metric; MPN CC0603KRX7R9BB104; LCSC C14663
D101, D102: SMF6.0A; MPN SMF6.0A; LCSC C19077499
J101: USB4105-GF-A; USB4105-GF-A_ProjectShells; MPN USB4105-GF-A; LCSC C3020560
J102: LiPo JST-PH; JST_PH_S2B-PH-K_1x02_P2.00mm_Horizontal; MPN S2B-PH-K-S(LF)(SN); LCSC C173752
J103: Dock 5V pads; Dock_Pads_2x_4x6mm; MPN PCB pads only: no fitted component
L101: 0.47uH; L_Changjiang_FNR4020S; MPN SWPA4020SR47NT; LCSC C98415
Q101, Q102: AO3400A; SOT-23; MPN AO3400A; LCSC C20917
R101, R102: 5.1k 1%; R_0603_1608Metric; MPN 0603WAF5101T5E; LCSC C23186
R107: 30k 1%; R_0603_1608Metric; MPN 0603WAF3002T5E; LCSC C22984
R108, R118: 10k 1%; R_0603_1608Metric; MPN 0603WAF1002T5E; LCSC C25804
R109: 82k 1%; R_0603_1608Metric; MPN 0603WAF8202T5E; LCSC C23254
R111, R116, R121, R123, R124, R126: 100k 1%; R_0603_1608Metric; MPN 0603WAF1003T5E; LCSC C25803
R112: 4.7k 1%; R_0603_1608Metric; MPN 0603WAF4701T5E; LCSC C23162
R113: 3.3k 1%; R_0603_1608Metric; MPN 0603WAF3301T5E; LCSC C22978
R114: 47k 1%; R_0603_1608Metric; MPN 0603WAF4702T5E; LCSC C25819
R117: 56k 1%; R_0603_1608Metric; MPN 0603WAF5602T5E; LCSC C23206
R119: 1k 1%; R_0603_1608Metric; MPN 0603WAF1001T5E; LCSC C21190
R122, R125: 470k 1%; R_0603_1608Metric; MPN 0603WAF4703T5E; LCSC C23178
R127, R128: 1M 1%; R_0603_1608Metric; MPN 0603WAF1004T5E; LCSC C22935
RT101: 10k NTC B3950 1%; R_0603_1608Metric; MPN KNTC0603/10KF3950; LCSC C2892547
RT102: 100k NTC B3950 1%; R_0603_1608Metric; MPN KNTC0603/100KF3950; LCSC C2892545
TP101: VSYS; TestPoint_Pad_D1.0mm; MPN PCB pad only: no fitted component
U101: TPS2121RUXR; TPS2121RUXR_Reviewed; MPN TPS2121RUXR; LCSC C485916
U102: BQ24074RGTR; BQ24074RGTR_Reviewed; MPN BQ24074RGTR; LCSC C54313
U103: TPS63802DLAR; TPS63802_DLA0010A_Reviewed; MPN TPS63802DLAR; LCSC C2845237
U104: TPS22918DBVR; SOT-23-6; MPN TPS22918DBVR; LCSC C131941
U105: TPD4E05U06DQAR; USON-10_2.5x1.0mm_P0.5mm; MPN TPD4E05U06DQAR; LCSC C138714

Connections:
+3V3: C108.1, C109.1, C112.1, R116.1, R117.1, R123.1, R126.1, U103.6 (VOUT), U104.1 (VIN); also elsewhere on the board
+3V3_EPD: C114.1, R119.1, U104.6 (VOUT); also elsewhere on the board
/01 POWER + CHARGING/BATT_NTC: RT101.1, RT102.1, U102.1 (TS)
/01 POWER + CHARGING/CHARGER_EN1: R111.2, U102.6 (EN1)
/01 POWER + CHARGING/CHARGER_ILIM: R112.1, U102.12 (ILIM)
/01 POWER + CHARGING/CHARGER_ISET: R113.1, U102.16 (ISET)
/01 POWER + CHARGING/DOCK_PRESENT_GATE: Q102.1 (G), R124.2, R125.1
/01 POWER + CHARGING/EPD_CT: C113.1, U104.4 (CT)
/01 POWER + CHARGING/EPD_QOD: R119.2, U104.5 (QOD)
/01 POWER + CHARGING/MUX_ILM: R109.1, U101.10 (ILM)
/01 POWER + CHARGING/MUX_PRIORITY_USB: R107.2, R108.1, U101.6 (PR1)
/01 POWER + CHARGING/MUX_SS: C104.1, U101.11 (SS)
/01 POWER + CHARGING/PRIMARY_FB: R117.2, R118.1, U103.4 (FB)
/01 POWER + CHARGING/PRIMARY_L1: L101.1, U103.9 (L1)
/01 POWER + CHARGING/PRIMARY_L2: L101.2, U103.7 (L2)
/01 POWER + CHARGING/USB_CC1: J101.A5 (CC1), R101.1, U105.5 (D2-), U105.6 (NC)
/01 POWER + CHARGING/USB_CC2: J101.B5 (CC2), R102.1, U105.1 (D1+), U105.10 (NC)
/01 POWER + CHARGING/USB_PRESENT_GATE: Q101.1 (G), R121.2, R122.1
/01 POWER + CHARGING/VBAT_PROTECTED: C106.1, J102.1, R127.1, U102.2 (BAT), U102.3 (BAT)
/01 POWER + CHARGING/VEXT_5V: C103.1, U101.1 (OUT), U101.8 (OUT), U102.13 (IN)
/01 POWER + CHARGING/VSYS: C105.1, C107.1, R111.1, TP101.1, U102.10 (OUT), U102.11 (OUT), U103.1 (EN), U103.10 (VIN)
BAT_ADC: C116.1, R127.2, R128.1; also elsewhere on the board
CHARGER_CHG_N: R116.2, U102.9 (~CHG); also elsewhere on the board
DOCK_PRESENT_N: Q102.3 (D), R126.2; also elsewhere on the board
EPD_EN: U104.3 (ON); also elsewhere on the board
USB_DM: J101.A7 (D-), J101.B7 (D-), U105.4 (D2+), U105.7 (NC); also elsewhere on the board
USB_DP: J101.A6 (D+), J101.B6 (D+), U105.2 (D1-), U105.9 (NC); also elsewhere on the board
USB_PRESENT_N: Q101.3 (D), R123.2; also elsewhere on the board

Notes on the sheet:
USB-priority source selection
USB / dock inputs
Shared nominal 3.3 V rail
CHARGING CE tied low: charger enabled, 270 mA (R113), USB500 input limit. RT101 10k || RT102 100k NTC under the cell: charge window 1.7-44.8 degC nominal, 0.1-48.4 degC over the charger's threshold and bias tolerance. J102 is JST-PH, pin 1 = battery +. CHECK PACK POLARITY before connecting. Use a p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
Display power
FIRST-PROTOTYPE RAIL EXCEPTION 56k / 10k: 3.3 V nominal. No LDO. PWM static estimate: 3.256 to 3.344 V. LED source minimum is 3.3 V. LED operation is NOT guaranteed. Test startup, low battery, Wi-Fi and full-white steps at the LED pins. See power.md for limits and test gates.
Electrical development draft. No PCB layout or manufacturing release. See docs/design/power.md.
Battery ADC (VBAT/2) / source presence
Power path: charger enabled

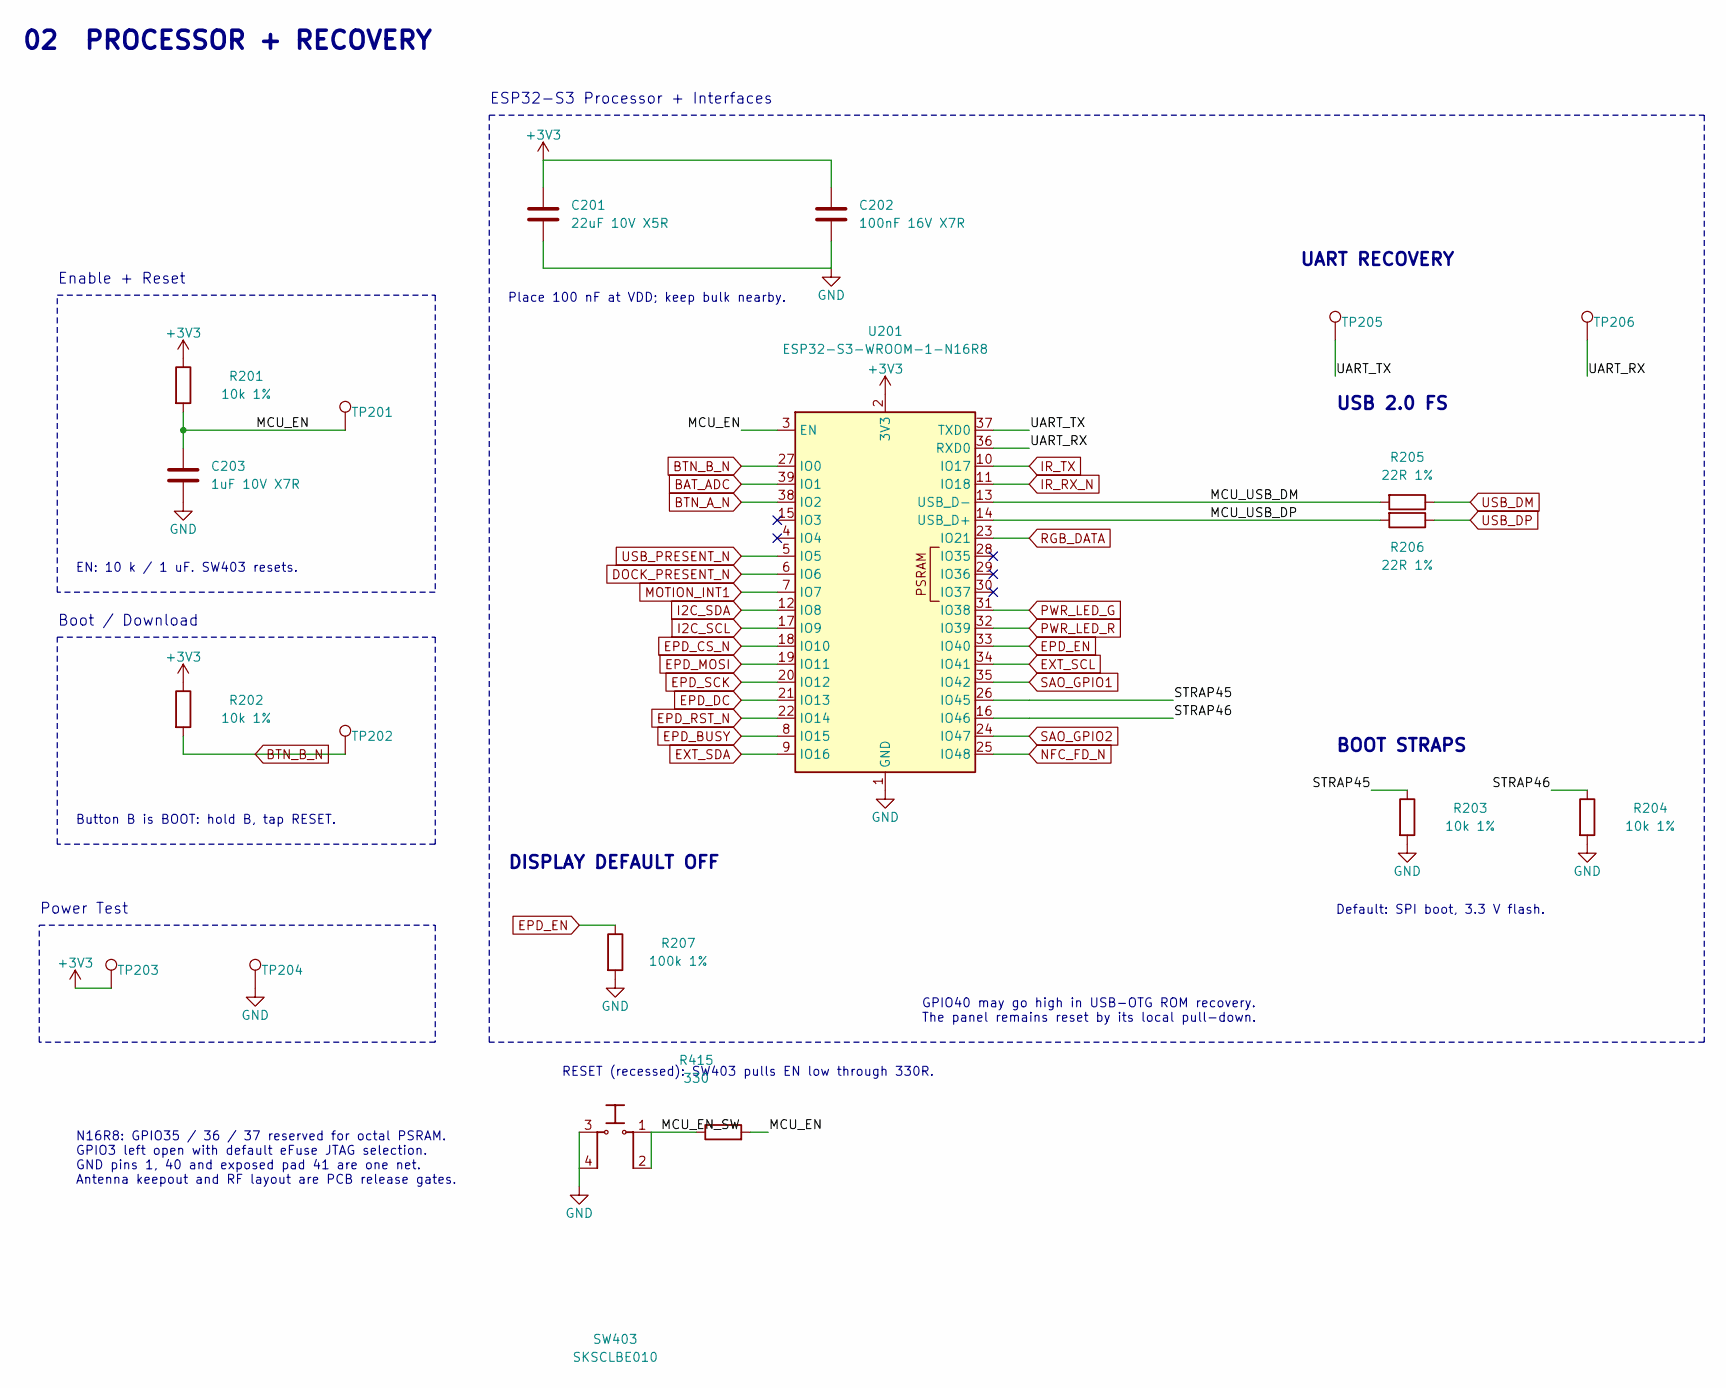
[picture p64: schematic mcu.kicad_sch]

Parts:
C201: 22uF 10V X5R; C_0805_2012Metric; MPN CL21A226MAQNNNE; LCSC C45783
C202: 100nF 16V X7R; C_0402_1005Metric; MPN CL05B104KO5NNNC; LCSC C1525
C203: 1uF 10V X7R; C_0402_1005Metric; MPN CL05A105KA5NQNC; LCSC C52923
R201, R202, R203, R204: 10k 1%; R_0402_1005Metric; MPN 0402WGF1002TCE; LCSC C25744
R205, R206: 22R 1%; R_0402_1005Metric; MPN 0402WGF220JTCE; LCSC C25092
R207: 100k 1%; R_0402_1005Metric; MPN 0402WGF1003TCE; LCSC C25741
R415: 330; R_0603_1608Metric; Rating 330R 1%; MPN 0603WAF3300T5E; LCSC C23138
SW403: SKSCLBE010; Rating 12VDC/50mA max;1VDC/10uA min;2.2+/-0.65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; MPN SKSCLBE010; JLCPCB C115361
TP201: MCU_EN; TestPoint_Pad_D1.0mm; MPN PCB pad only: no fitted component
TP202: BOOT / BTN_B; TestPoint_Pad_D1.0mm; MPN PCB pad only: no fitted component
TP203: +3V3; TestPoint_Pad_D1.0mm; MPN PCB pad only: no fitted component
TP204: GND; TestPoint_Pad_D1.0mm; MPN PCB pad only: no fitted component
TP205: UART_TX; TestPoint_Pad_D1.0mm; MPN PCB pad only: no fitted component
TP206: UART_RX; TestPoint_Pad_D1.0mm; MPN PCB pad only: no fitted component
U201: ESP32-S3-WROOM-1-N16R8; ESP32-S3-WROOM-1; MPN ESP32-S3-WROOM-1-N16R8; LCSC C2913202

Connections:
+3V3: C201.1, C202.1, R201.1, R202.1, TP203.1, U201.2 (3V3); also elsewhere on the board
/02 PROCESSOR + RECOVERY/MCU_EN: C203.1, R201.2, R415.2, TP201.1, U201.3 (EN)
/02 PROCESSOR + RECOVERY/MCU_EN_SW: R415.1, SW403.1, SW403.2
/02 PROCESSOR + RECOVERY/MCU_USB_DM: R205.2, U201.13 (USB_D-)
/02 PROCESSOR + RECOVERY/MCU_USB_DP: R206.2, U201.14 (USB_D+)
/02 PROCESSOR + RECOVERY/STRAP45: R203.1, U201.26 (IO45)
/02 PROCESSOR + RECOVERY/STRAP46: R204.1, U201.16 (IO46)
/02 PROCESSOR + RECOVERY/UART_RX: TP206.1, U201.36 (RXD0)
/02 PROCESSOR + RECOVERY/UART_TX: TP205.1, U201.37 (TXD0)
BAT_ADC: U201.39 (IO1); also elsewhere on the board
BTN_A_N: U201.38 (IO2); also elsewhere on the board
BTN_B_N: R202.2, TP202.1, U201.27 (IO0); also elsewhere on the board
DOCK_PRESENT_N: U201.6 (IO6); also elsewhere on the board
EPD_BUSY: U201.8 (IO15); also elsewhere on the board
EPD_CS_N: U201.18 (IO10); also elsewhere on the board
EPD_DC: U201.21 (IO13); also elsewhere on the board
EPD_EN: R207.1, U201.33 (IO40); also elsewhere on the board
EPD_MOSI: U201.19 (IO11); also elsewhere on the board
EPD_RST_N: U201.22 (IO14); also elsewhere on the board
EPD_SCK: U201.20 (IO12); also elsewhere on the board
EXT_SCL: U201.34 (IO41); also elsewhere on the board
EXT_SDA: U201.9 (IO16); also elsewhere on the board
I2C_SCL: U201.17 (IO9); also elsewhere on the board
I2C_SDA: U201.12 (IO8); also elsewhere on the board
IR_RX_N: U201.11 (IO18); also elsewhere on the board
IR_TX: U201.10 (IO17); also elsewhere on the board
MOTION_INT1: U201.7 (IO7); also elsewhere on the board
NFC_FD_N: U201.25 (IO48); also elsewhere on the board
PWR_LED_G: U201.31 (IO38); also elsewhere on the board
PWR_LED_R: U201.32 (IO39); also elsewhere on the board
RGB_DATA: U201.23 (IO21); also elsewhere on the board
SAO_GPIO1: U201.35 (IO42); also elsewhere on the board
SAO_GPIO2: U201.24 (IO47); also elsewhere on the board
USB_DM: R205.1; also elsewhere on the board
USB_DP: R206.1; also elsewhere on the board
USB_PRESENT_N: U201.5 (IO5); also elsewhere on the board

Notes on the sheet:
EN: 10 k / 1 uF. SW403 resets.
ESP32-S3 Processor + Interfaces
UART RECOVERY
Place 100 nF at VDD; keep bulk nearby.
BOOT STRAPS
Button B is BOOT: hold B, tap RESET.
Default: SPI boot, 3.3 V flash.
GPIO40 may go high in USB-OTG ROM recovery. The panel remains reset by its local pull-down.
USB 2.0 FS
02 PROCESSOR + RECOVERY
Enable + Reset
RESET (recessed): SW403 pulls EN low through 330R.
N16R8: GPIO35 / 36 / 37 reserved for octal PSRAM. GPIO3 left open with default eFuse JTAG selection. GND pins 1, 40 and exposed pad 41 are one net. Antenna keepout and RF layout are PCB release gates.
Power Test
Boot / Download
DISPLAY DEFAULT OFF

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
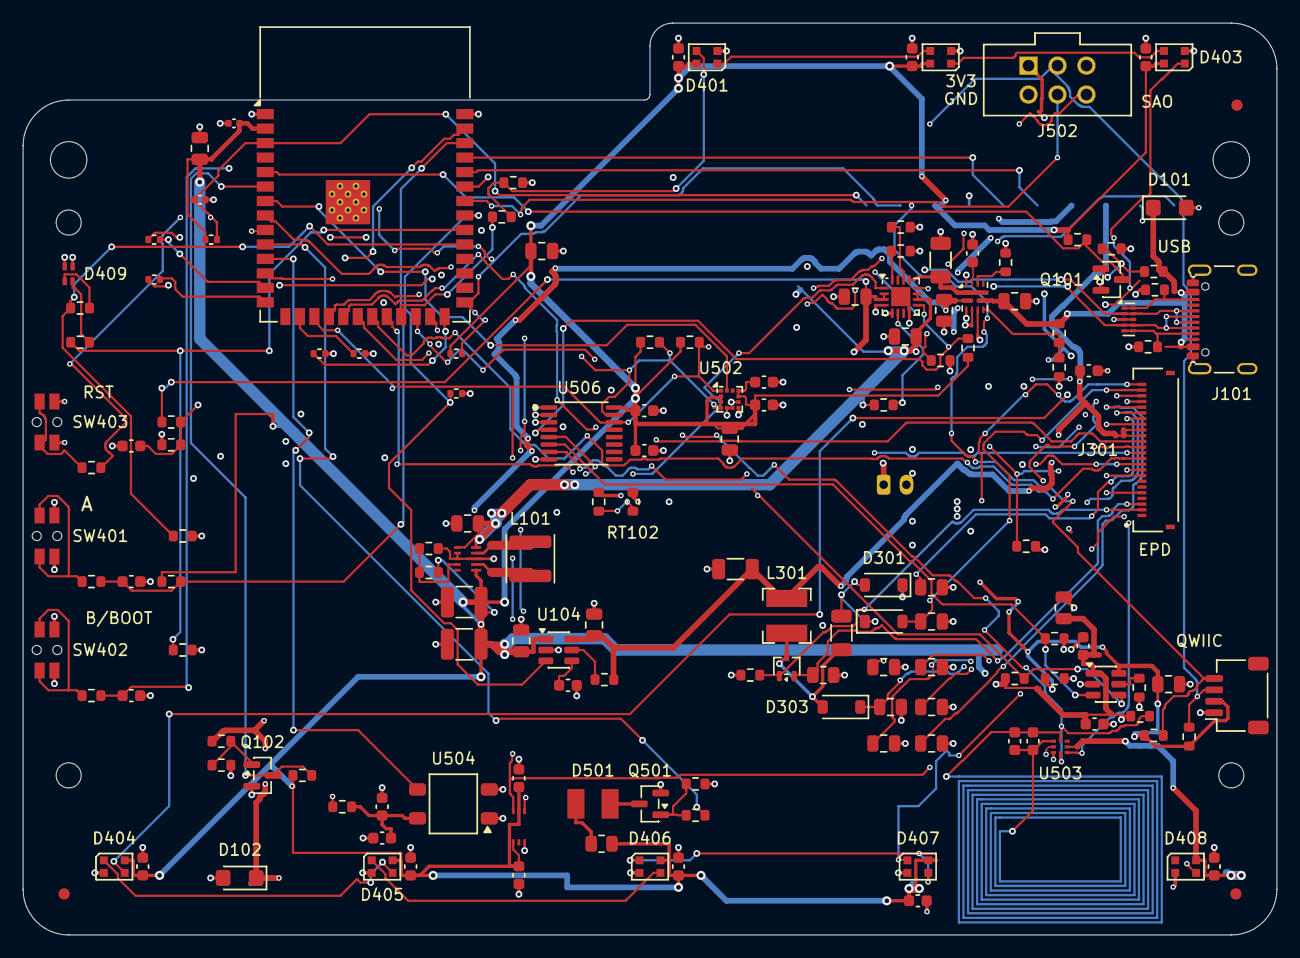
[picture p65: board tinkerbadge.kicad_pcb from above]

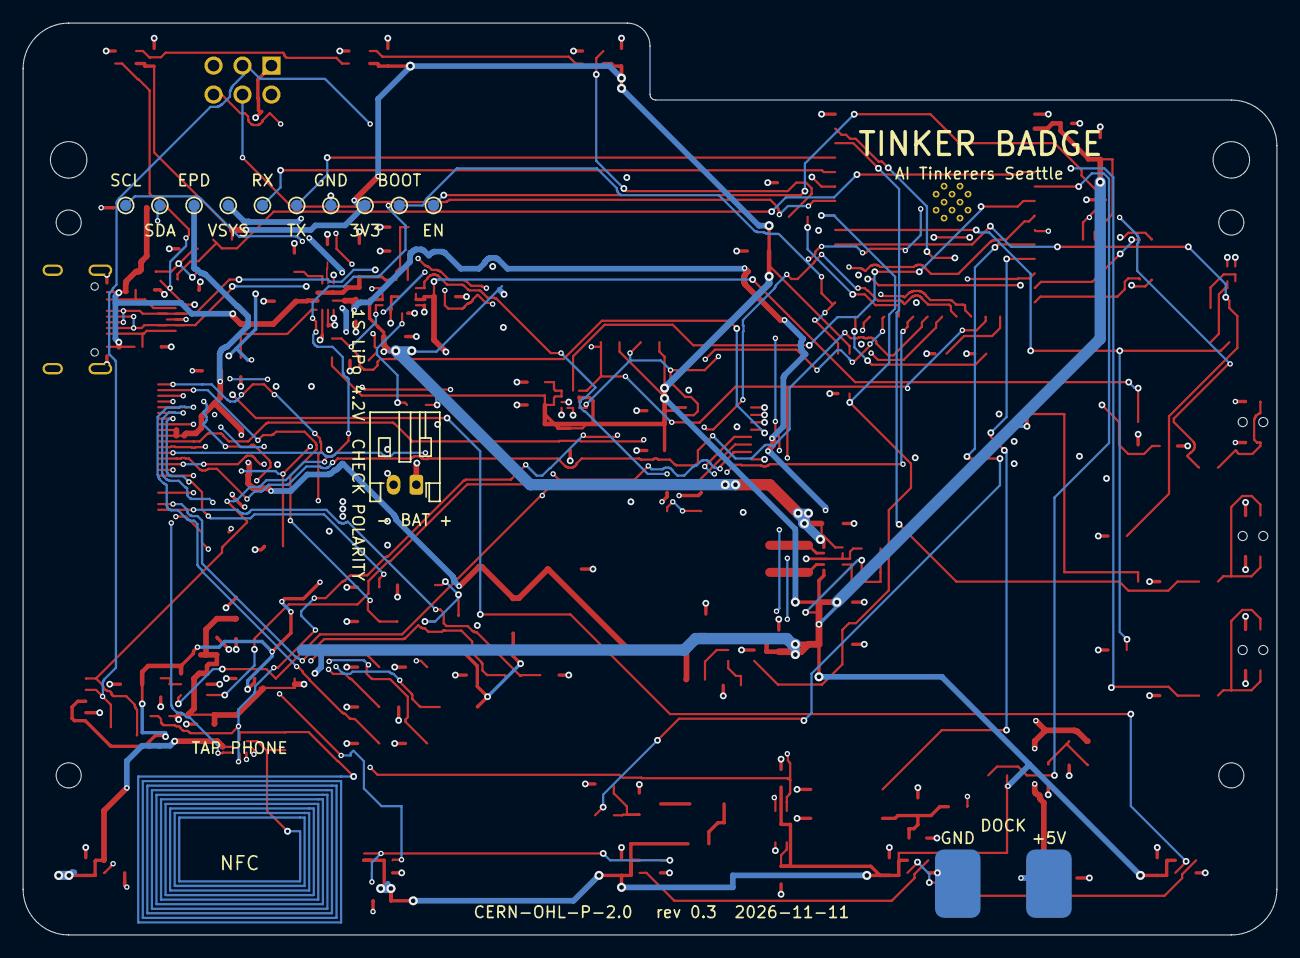
[picture p66: board tinkerbadge.kicad_pcb from below]

Board: 4 copper layers, 110.0 x 80.0 mm, 173 parts (14 on the bottom side), 96 nets.

Other parts of the board:
FID1, FID2, FID3: Fiducial; Fiducial_1mm_Mask2mm
H1, H2, H3, H4: PROVISIONAL; MountingHole_2.2mm_M2
H5, H6: REVIEW ENVELOPE ONLY; Review_Cord_Hole_3p2
MECH_BATTERY: REVIEW ONLY; Review_Battery_Allowance
MECH_PANEL: REVIEW ENVELOPE ONLY; Review_Panel_Raised_4p5
