thebenedict/tinkerbadge-hardware/(commit log)

2026-11-10 Publish checked ALS placement and licensed hardware sources
    [display.kicad_sch, lighting.kicad_sch, mcu.kicad_sch, pcb_footprint_assignments.json, pcb_placement.json, peripherals.kicad_sch, placement-before-native-repair.kicad_pcb, power.kicad_sch]
2026-11-10 Publish checked first PCB routing pass
    [pcb_placement.json, schematic-contracts.json, schematic-properties.json, tinkerbadge.kicad_pcb]
2026-11-10 Name the processor Microcontroller in the BOM
2026-11-11 Checkpoint latest routed badge design and manufacturing exports
    Preserve the current work in progress exactly, including native KiCad CAD,
    project footprints, contracts, reproducible routing inputs and tools,
    review evidence, and the JLCPCB manufacturing package.
    Checkpoint only, not fabrication approval. The known NFC inner-plane
    copper issue and open electrical, physical, thermal, and prototype
    qualification gates remain unresolved. No design edits are made here.
    PCB SHA-256: e810ede1361930f441fd6476230c689aeb4480719db890b1a41619168cab674d
    [bom-hand-fit.csv, bom-jlcpcb.csv, bom.csv, display.kicad_sch, jlcpcb_parts_check_2026-11-10.csv, lighting.kicad_sch, mcu.kicad_sch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]
2026-11-12 Board revision 0.3: fix the 11 November review findings
    Adds the independent design review of checkpoint 3120d6e and the response
    to it, and carries the accepted fixes through the schematic, board, records
    and JLCPCB package.
    - NFC: copper-free window on all four layers under the rear coil, enforced
    by a custom design rule and checked on both the board file and the
    exported Gerbers; the export stops if either check fails
    - Battery: a second NTC recentres the charge window, and both sensors move
    opposite the middle of the cell
    - SAO socket footprint, courtyard and 3D envelope redrawn from the Sullins
    drawing
    - Display connector changed to the dual-contact Hirose FH34SRJ and moved to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
    [bom-jlcpcb.csv, bom.csv, display.kicad_sch, jlcpcb_parts_check_2026-11-11.csv, lighting.kicad_sch, mcu.kicad_sch, pcb_placement.json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]
2026-11-12 Add A2 enclosure CAD and record the selected enclosure direction
    Work from a separate session, committed as found.
    mechanical/enclosure/ holds the parametric build123d sources for the layered
    clear enclosure (clear front and rear plates, dark printed frame, open LED
    windows), its STEP, STL, DXF and GLB exports, and the nominal fit checks.
    The specification records that direction as selected on 11 November 2026 and
    replaces the diffuser and light-guide wording with open LED windows. The
    README links the enclosure.
    interfaces.json pins board SHA-256 7b6ea0e6, an intermediate revision 0.3
    state. The 30 mechanical reference records are the same on the final board
    (2ab108d4), so only extract_in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
    [battery-guide.step, battery-guide.stl, enclosure.step, frame.step, frame.stl, front.dxf, front.step, front.stl]
2026-11-12 Add overall product review of revision 0.3
    Reviews the electrical design, enclosure, attendee experience and loaner
    operations against the final revision 0.3 board (SHA-256 2ab108d4) and the
    A2 enclosure. docs/review/product-review-2026-11-11/ holds its check results
    and a manifest of the input hashes it was run against.
    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
2026-11-12 Synchronize publication exports with final PCB revision 0.3
    [battery-guide.step, enclosure.step, frame.step, front.dxf, front.step, optical-baffle.step, rear.dxf, rear.step]
